David0412-sun/Rapidhand/RAPID-Hand-main/README.md

<p align="center">
    <h1 align="center"><strong>
    RAPID Hand: A Robust, Affordable,<br>
    Perception-Integrated, Dexterous Manipulation Platform<br>
    for Generalist Robot Autonomy</strong>
    </h1>
</p>

<p align="center" style="font-size:18px;">
    <a href="https://jeffreyzhaoliang.github.io/zhaoliang-wan.github.io/"><strong>Zhaoliang Wan</strong></a>
    ·
    <a href=""><strong>Zetong Bi</strong></a>
    ·
    <a href=""><strong>Zida Zhou</strong></a>
    ·
    <a href="https://hren20.github.io/"><strong>Hao Ren</strong></a>
    ·
    <a href="https://jzengym.github.io/JZENGYM/"><strong>Yiming Zeng</strong></a>
    ·
    <a href=""><strong>Yihan Li</strong></a>
    <br>
    <a href="http://luqi.info/"><strong>Lu Qi</strong></a>
    ·
    <a href="https://people.ucas.edu.cn/~XuYang"><strong>Xu Yang</strong></a>
    ·
    <a href="https://faculty.ucmerced.edu/mhyang/"><strong>Ming-Hsuan Yang</strong></a>
    ·
    <a href="https://cse.sysu.edu.cn/teacher/ChengHui"><strong>Hui Cheng</strong></a>
</p>

<p align="center">
    <img src="RapidTeleop/assets/images/institution/sysu_logo.png" height=40">                    
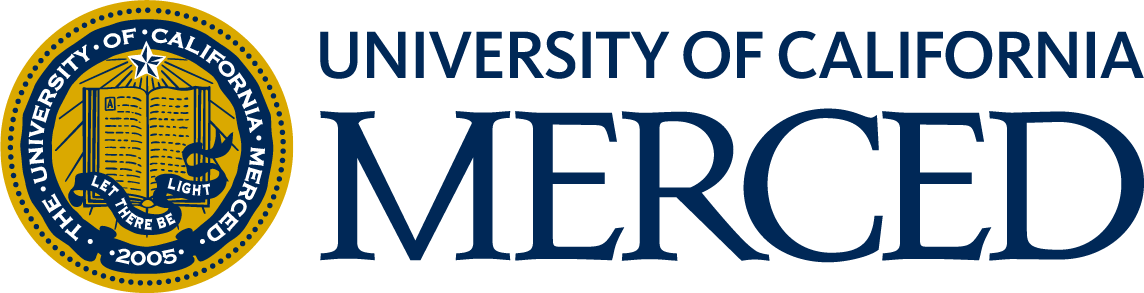
[picture p1: RAPID-Hand-main/RapidTeleop/assets/images/institution/University_of_Califronia_Merced_logo.png]
                        
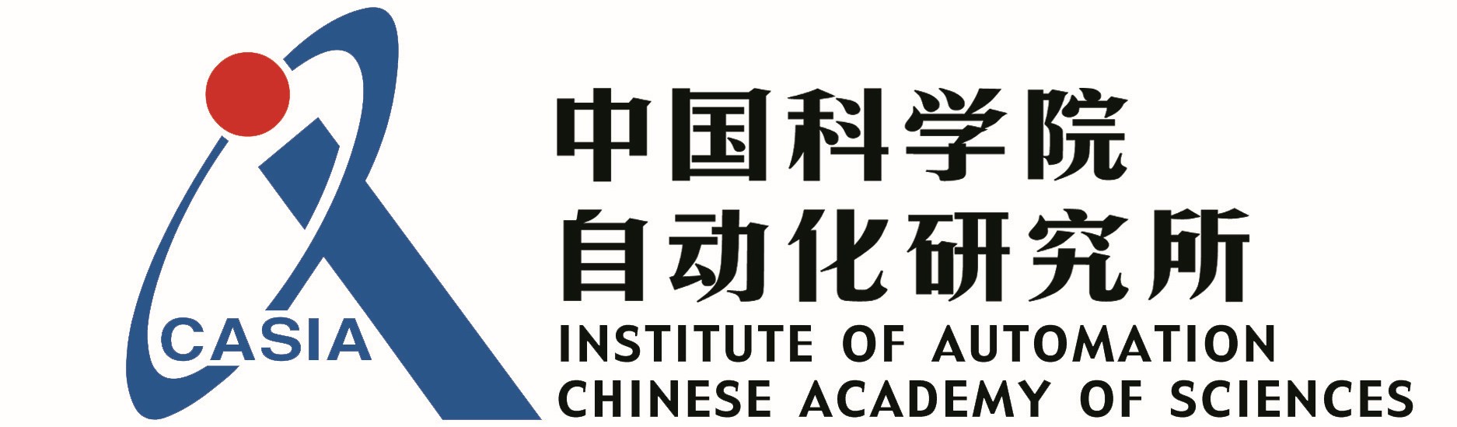
[picture p2: RAPID-Hand-main/RapidTeleop/assets/images/institution/casia-logo.jpg]
    
</p>

<h3 align="center"><a href="https://www.arxiv.org/abs/2506.07490">Paper</a> | <a href="https://rapid-hand.github.io/">Project Page</a> | <a href="https://github.com/SYSU-RoboticsLab/RAPID-Hand/tree/main/RapidHandHardware">Hardware Design</a> | <a href="https://github.com/SYSU-RoboticsLab/RAPID-Hand/tree/main/RapidTeleop">Teleoperation</a> </a></h3>

<p align="center">
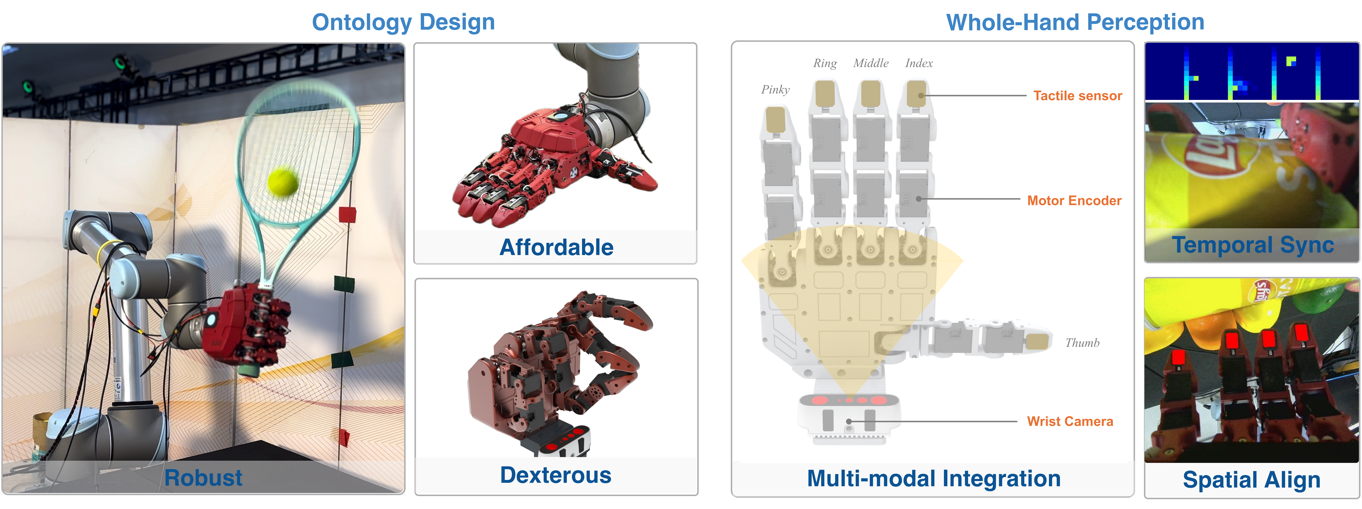
[picture p3: RAPID-Hand-main/RapidTeleop/assets/images/teaser_rss_7_00.png]
    
</p>

## 🔥 News

- \[2025-06\] RAPID Hand full system released with mechanical, electrical, and software modules.
- \[2025-06\] We release the [paper](https://www.arxiv.org/abs/2506.07490) of RAPID Hand.

---

## 🏠 Introduction

This repository is an official implementation of **RAPID Hand**, which is a low-cost, high-fidelity, modular hardware-software platform for dexterous hand manipulation, consisting of:

- **RapidHandHardware**: Detailed hardware design (PCBs, 3D printable parts, bill of materials).
- **RapidTeleop**: Vision-guided teleoperation suite with intuitive user control.

It enables researchers and hobbyists to easily replicate complex hand hardware for manipulation tasks at a much lower cost.

---

## 🛠️ Installation & Usage

Please refer to the sub-repository READMEs for detailed instructions:

- 🧩 [RapidHandHardware](./RapidHandHardware/README.md): mechanical design, PCB setup, and system integration for the RAPID Hand platform.
- 🖥️ [RapidTeleop](./RapidTeleop/README.md): teleoperation interface, ROS setup, and control pipeline for both simulation and real hardware.

---

## 📝 TODO

- \[x\] Release hardware and BOM.
- \[x\] Upload software for teleop and control.
- \[ \] Extend to multiple hand variants and task types.

---

## 🔗 Citation

If you use our project, please cite:

```bibtex
@article{wan2025rapid,
  title={RAPID Hand: A Robust, Affordable, Perception-Integrated, Dexterous Manipulation Platform for Generalist Robot Autonomy},
  author={Wan, Zhaoliang and Bi, Zetong and Zhou, Zida and Ren, Hao and Zeng, Yiming and Li, Yihan and Qi, Lu and Yang, Xu and Yang, Ming-Hsuan and Cheng, Hui},
  journal={arXiv preprint arXiv:2506.07490},
  year={2025}
}
```

---

## 📄 License

This project is licensed under the [Creative Commons BY-NC-SA 4.0 License](http://creativecommons.org/licenses/by-nc-sa/4.0/).

---

## 🙏 Acknowledgements

This project was developed with help of the following codebases.
- [Tracking Streamer](https://github.com/Improbable-AI/VisionProTeleop)  
- [AnyTeleop](https://yzqin.github.io/anyteleop/)  
- [Bunny-VisionPro](https://dingry.github.io/projects/bunny_visionpro.html)  
- [HATO](https://toruowo.github.io/hato/)  
- [Orbbec-sdk](https://github.com/orbbec/pyorbbecsdk)  

We would also like to thank orbot **ORBOT** Ltd. for their support on the robot hardware and [LUSTER](https://www.luster3ds.com/content/details202_5099.html) for motion capture devices. We sincerely appreciate the contributions from all related institutions and authors.
