David0412-sun/Rapidhand/RAPID-Hand-main/RapidHandHardware/mechanical_structure/rss_design/finger_with_cam/手指带摄像头爆炸图.PNG

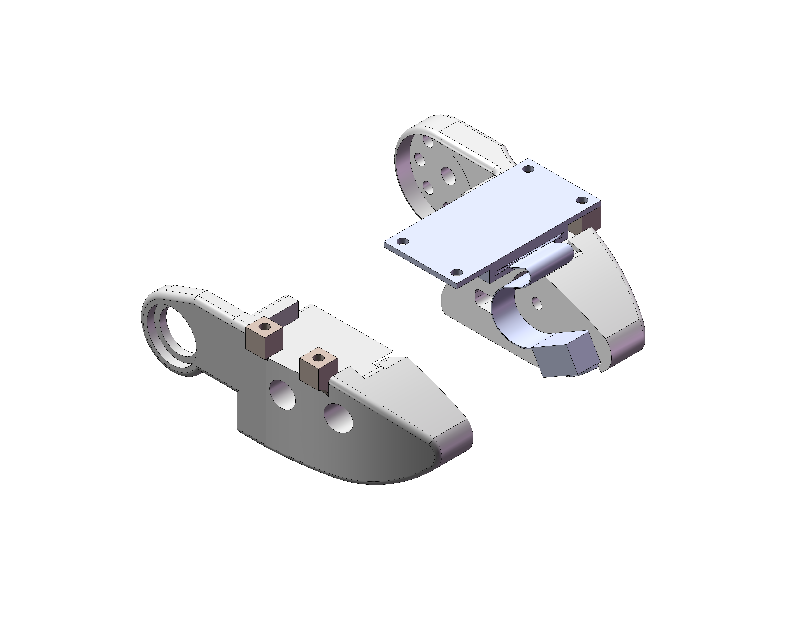
RAPID-Hand-main/RapidHandHardware/mechanical_structure/rss_design/finger_with_cam/手指带摄像头爆炸图.PNG
