David0412-sun/Rapidhand/tmp/pdfs/final_render/page_01.png

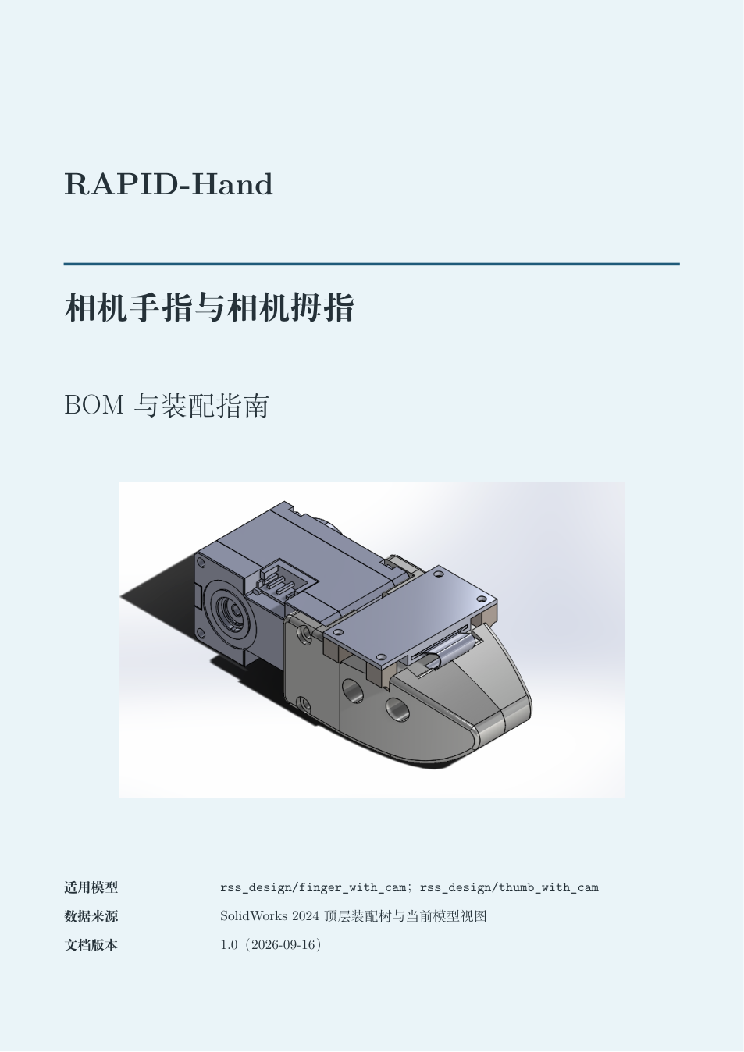
tmp/pdfs/final_render/page_01.png
