David0412-sun/Rapidhand/tmp/pdfs/final_render/page_02.png

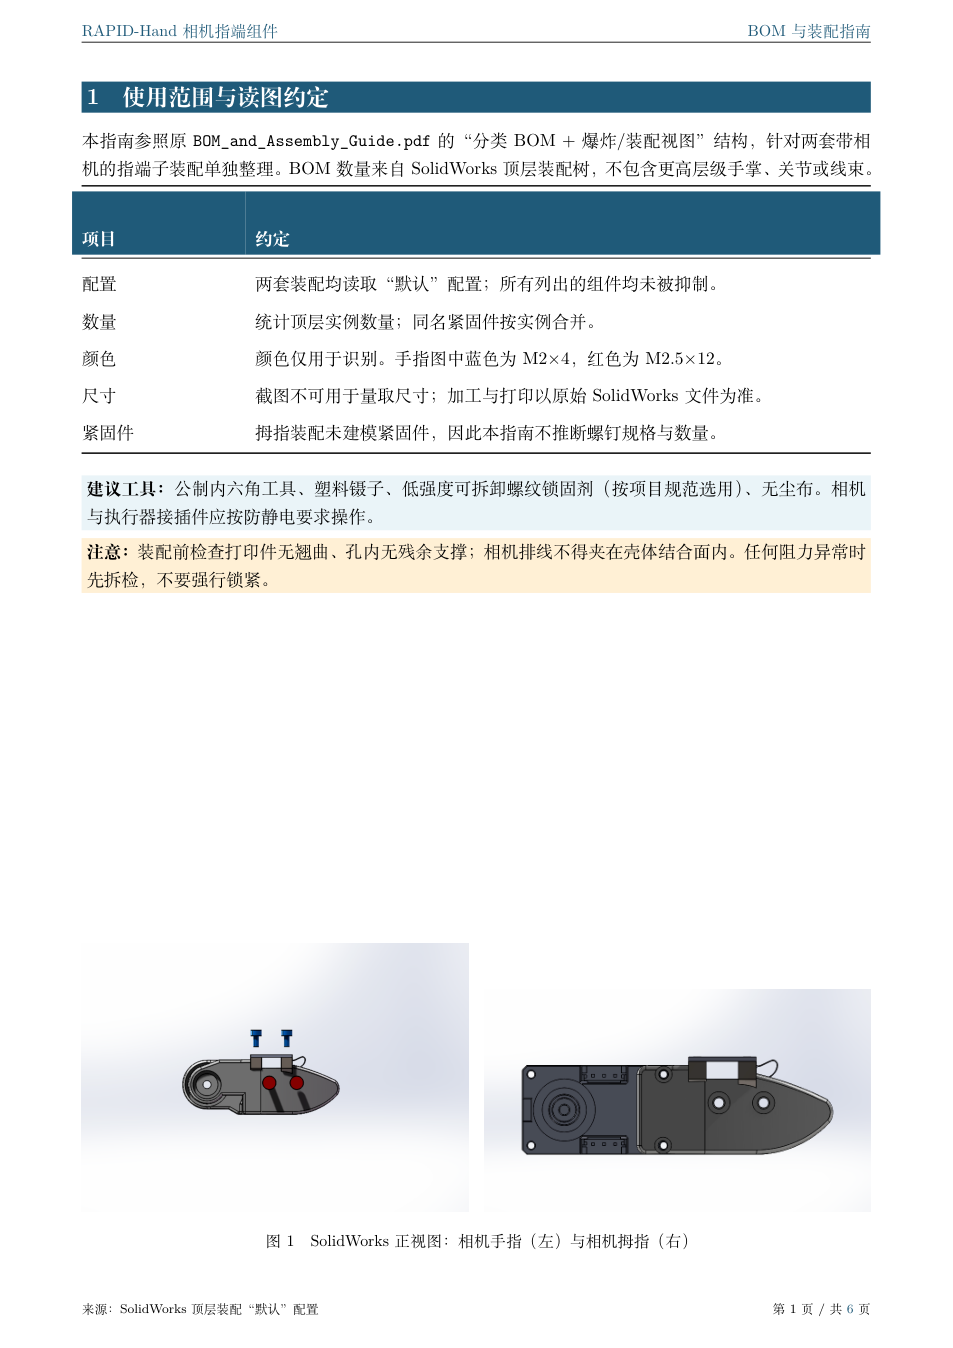
tmp/pdfs/final_render/page_02.png
