David0412-sun/Rapidhand/tmp/pdfs/final_render/page_03.png

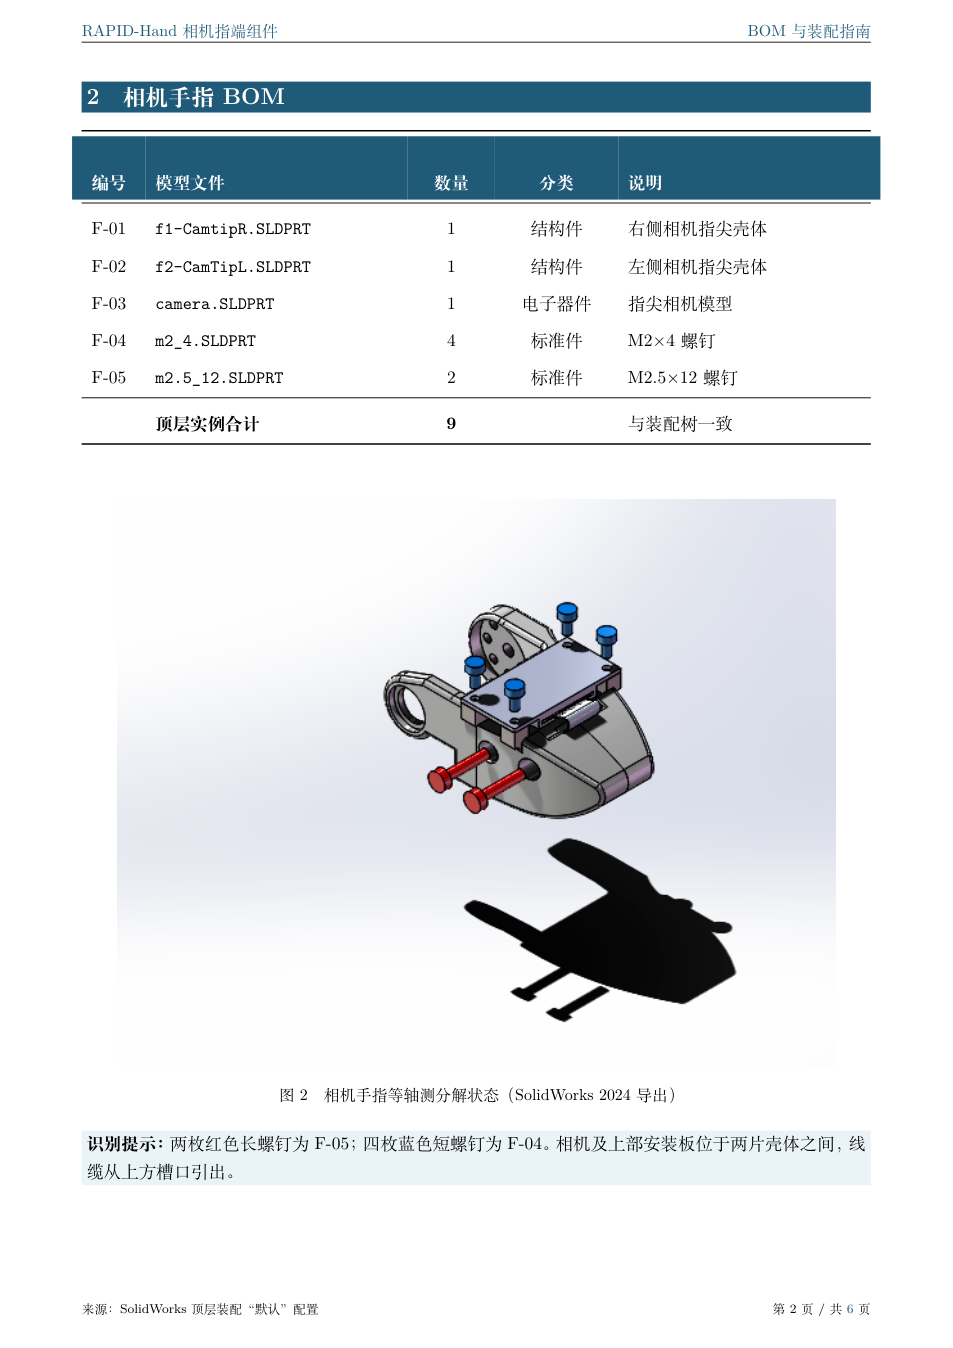
tmp/pdfs/final_render/page_03.png
