David0412-sun/Rapidhand/tmp/pdfs/final_render/page_04.png

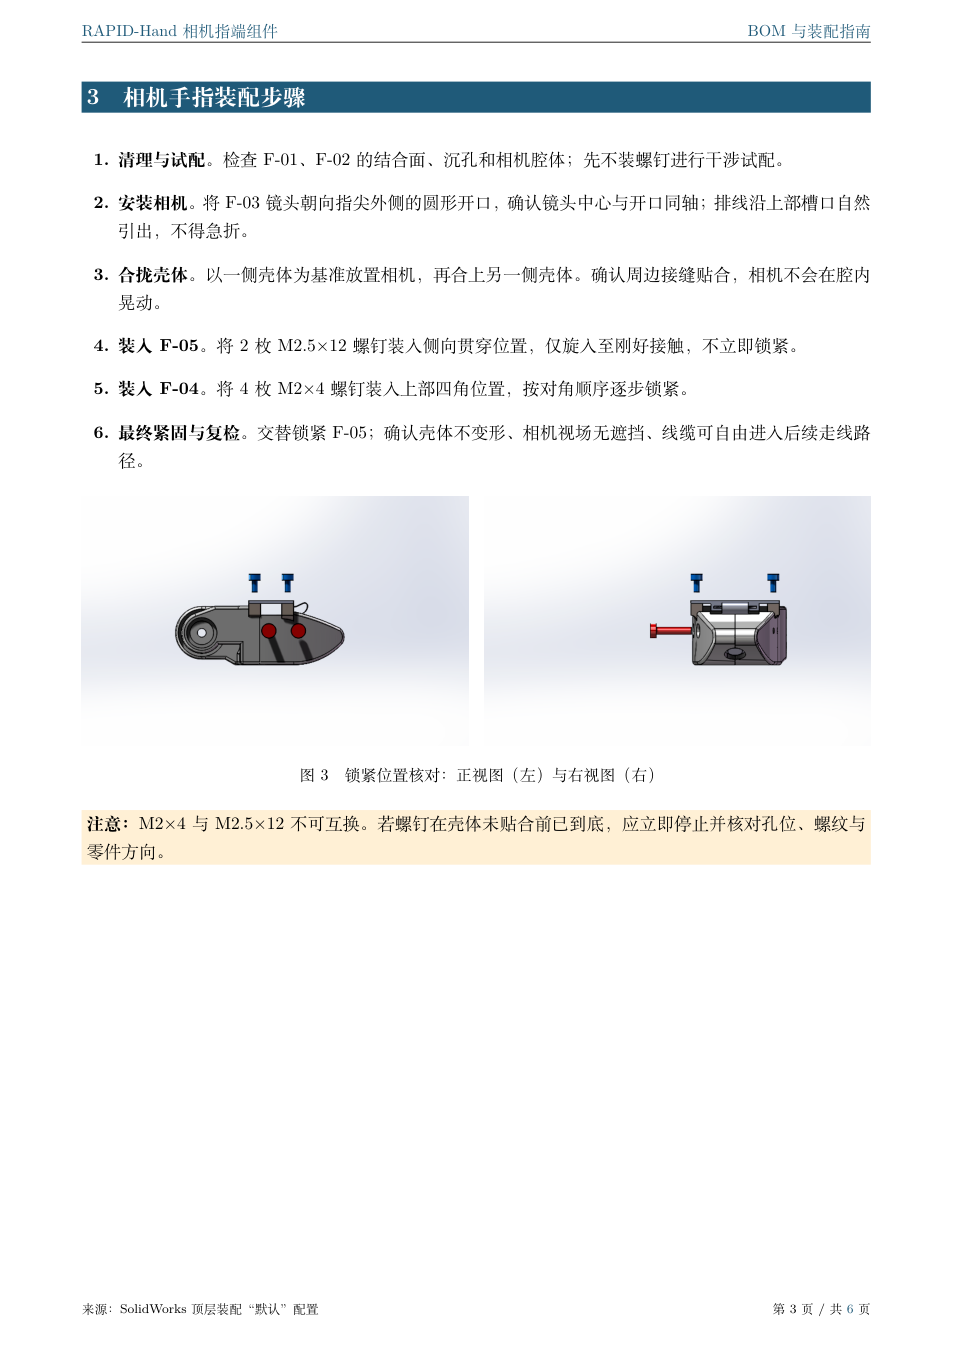
tmp/pdfs/final_render/page_04.png
