David0412-sun/Rapidhand/tmp/pdfs/final_render/page_05.png

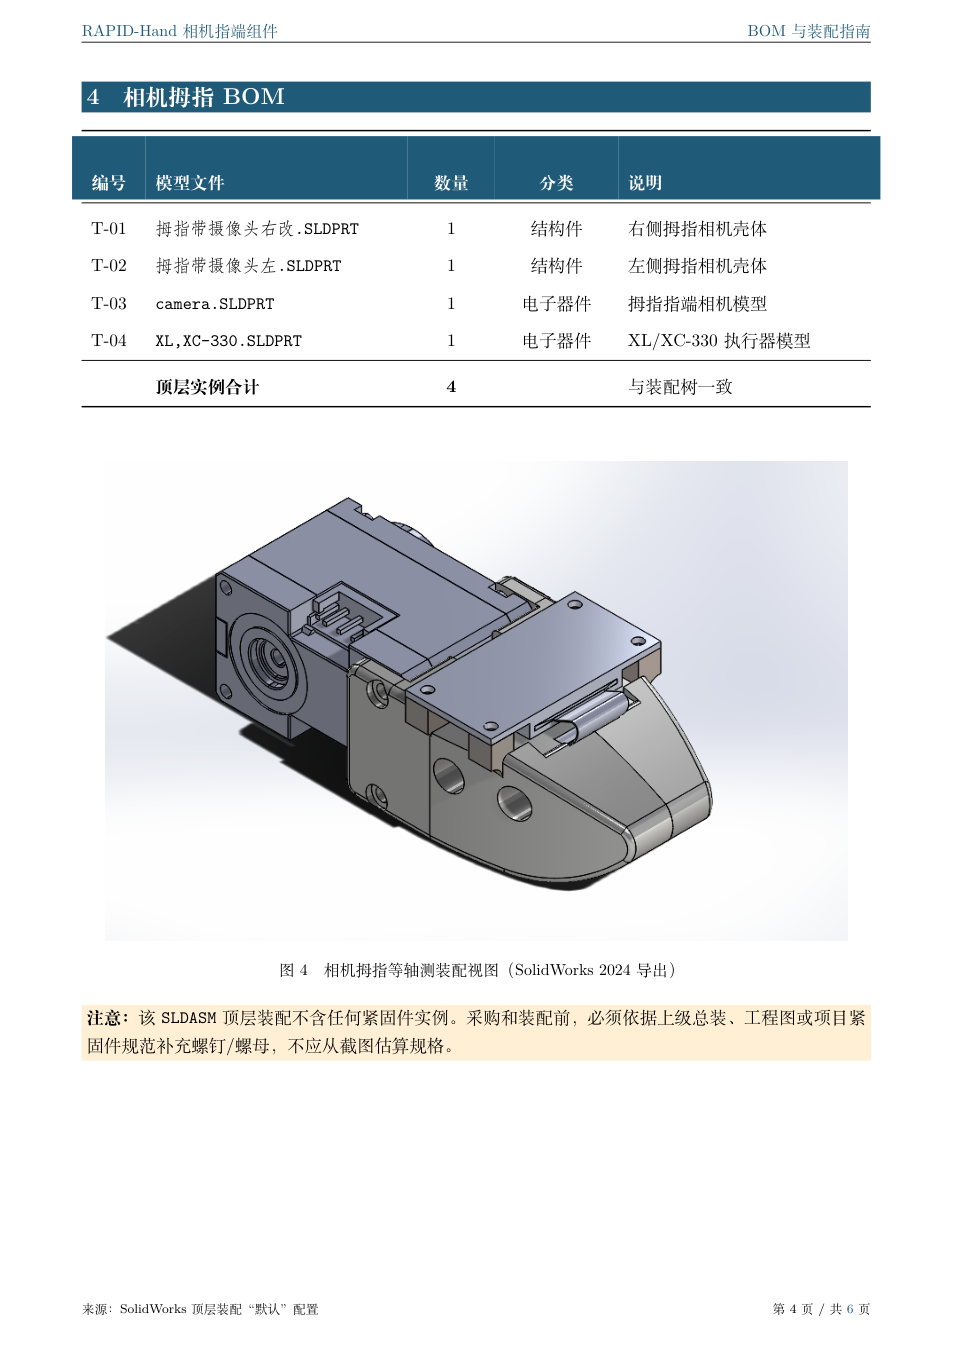
tmp/pdfs/final_render/page_05.png
