David0412-sun/Rapidhand/tmp/pdfs/final_render/page_07.png

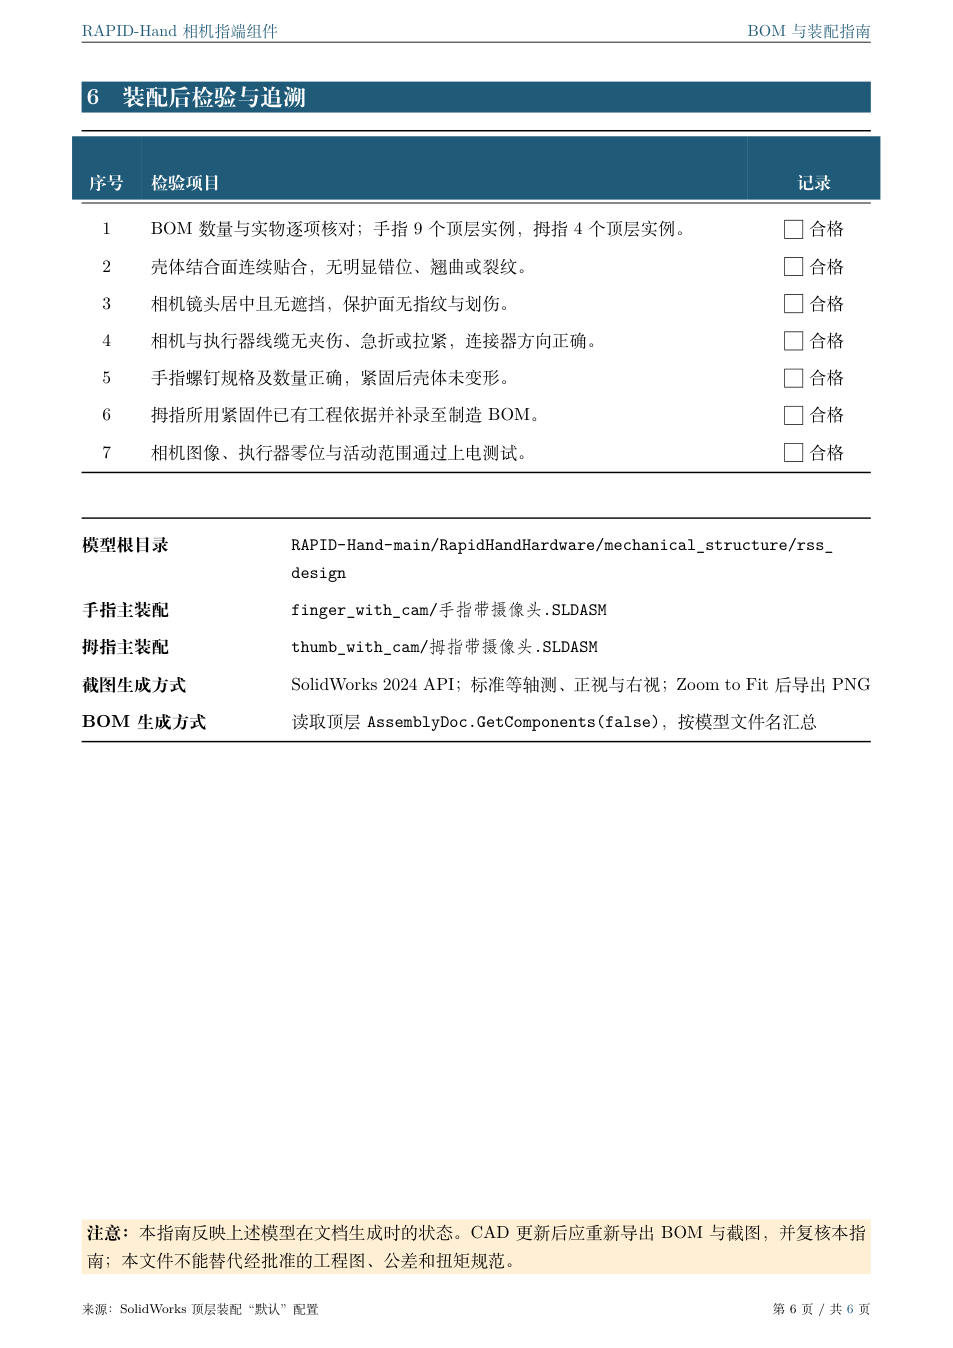
tmp/pdfs/final_render/page_07.png
