David0412-sun/Rapidhand/tmp/thumb_latest_review.png

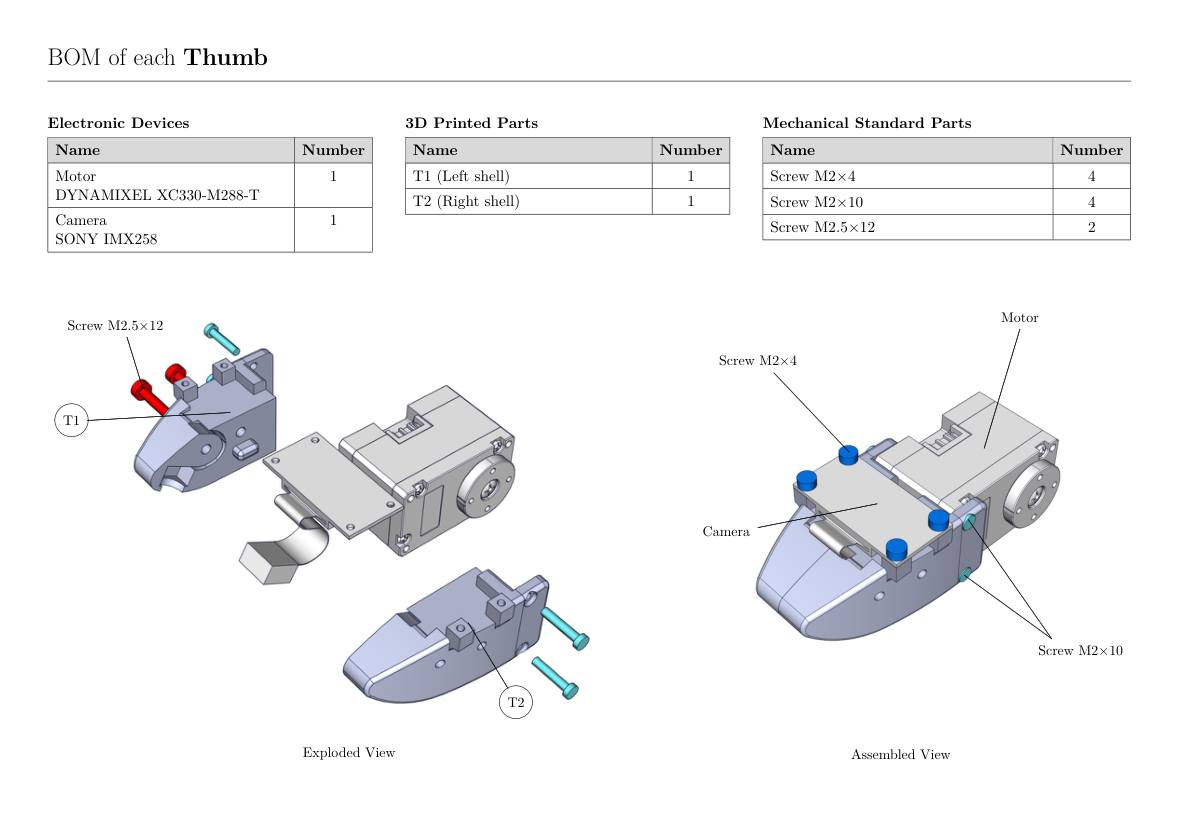
tmp/thumb_latest_review.png
