David0412-sun/Rapidhand/tmp/finger_bom_package_03548a5a9b424c499b2d4891ffd1fe91/RapidHand_camera_BOM_assembly_guide.pdf

## BOM of each Finger

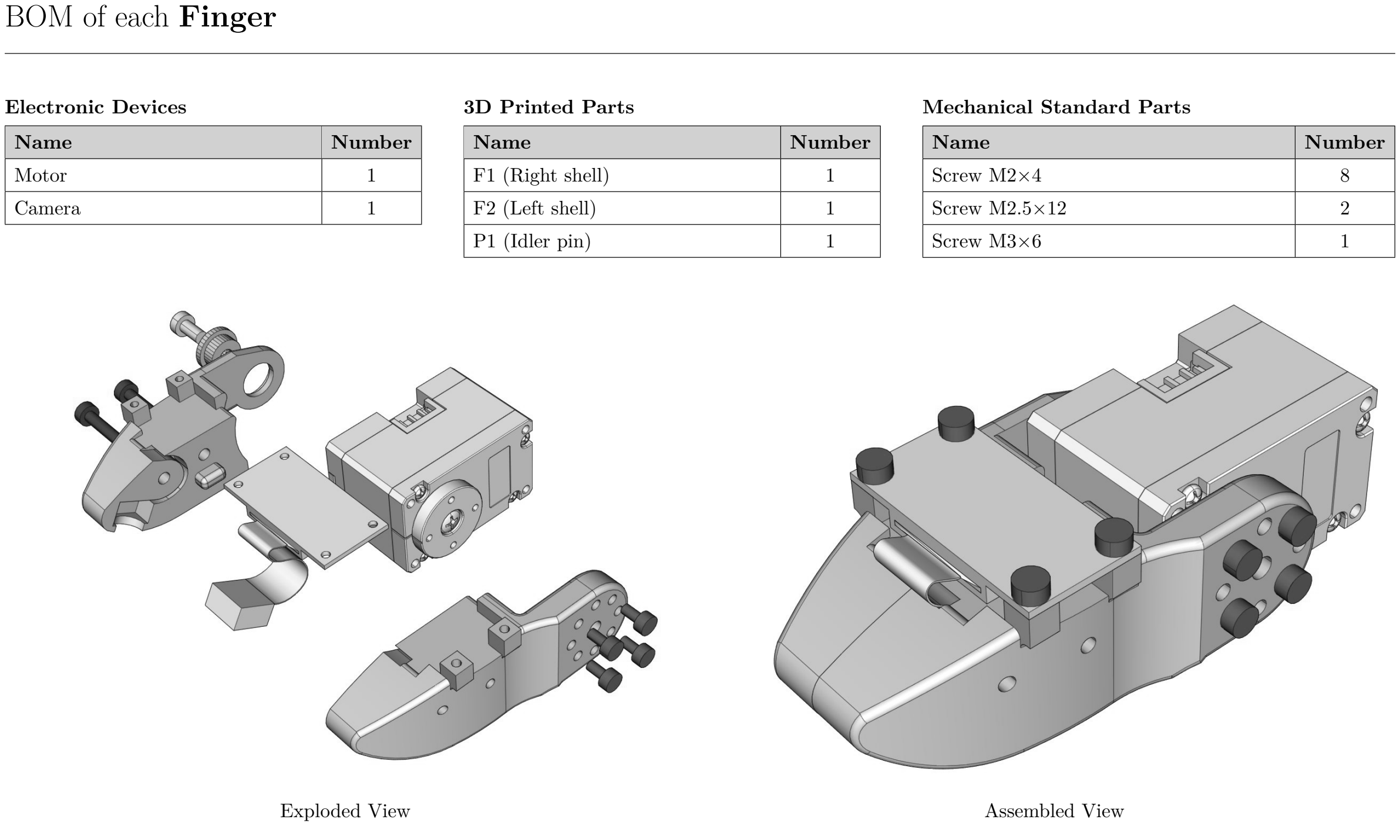
[picture p33: page 1]

Electronic Devices

Name | Number
Motor | 1
Camera | 1

3D Printed Parts

Name | Number
F1 (Right shell) | 1
F2 (Left shell) | 1
P1 (Idler pin) | 1

Mechanical Standard Parts

Name | Number
Screw M2×4 | 8
Screw M2.5×12 | 2
Screw M3×6 | 1
Exploded View | Assembled View
