David0412-sun/Rapidhand/RAPID-Hand-main/RapidHandHardware/mechanical_structure/FingerVIP_Mechanical_structure/FingerVIP_BOM_assembly_guide.pdf

## BOM of each Finger


Electronic Devices

Name | Number
Motor
DYNAMIXEL XC330-M288-T

1

Camera
SONY IMX258

1

3D Printed Parts

Name | Number
F1 (Right shell) | 1
F2 (Left shell) | 1
P1 (Idler pin) | 1

Mechanical Standard Parts

Name | Number
Screw M2×4 | 8
Screw M2.5×12 | 2
Screw M3×6 | 1

✖✕

✗✔F1

✖✕

✗✔F2

✖✕

✗✔P1

Screw M2.5×12

Screw M3×6

Motor

Camera

Screw M2×4

Exploded View | Assembled View

## BOM of Thumb


Electronic Devices

Name | Number
Motor
DYNAMIXEL XC330-M288-T

1

Camera
SONY IMX258

1

3D Printed Parts

Name | Number
T1 (Left shell) | 1
T2 (Right shell) | 1

Mechanical Standard Parts

Name | Number
Screw M2×4 | 4
Screw M2×10 | 4
Screw M2.5×12 | 2

✖✕

✗✔T1

✖✕

✗✔T2

Screw M2.5×12 | Motor

Camera

Screw M2×4

Screw M2×10

Exploded View | Assembled View

## Total BOM

Quantity basis: 4 Finger assemblies + 1 Thumb assembly.

Electronic Devices

Name | Number
Motor
DYNAMIXEL XC330-M288-T

5

Camera
SONY IMX258

5

3D Printed Parts

Name | Number
F1 (Right shell) | 4
F2 (Left shell) | 4
P1 (Idler pin) | 4
T1 (Left shell) | 1
T2 (Right shell) | 1

Mechanical Standard Parts

Name | Number
Screw M2×4 | 36
Screw M2×10 | 4
Screw M2.5×12 | 10
Screw M3×6 | 4

Scope: camera finger and thumb assemblies listed in this document only.
