David0412-sun/Rapidhand/RAPID-Hand-main/RapidHandHardware/pcb_sync_module/pcb_sourcing/BOM_Board1_PCB1.xlsx

No. | Quantity | Comment | Designator | Footprint | Value | Manufacturer Part | Manufacturer | Supplier Part | Supplier
1 | 12 | 100nF | C23,C24,C25,C26,C27,C28,C35,C41,C42,C54,C87,C89 | C0402 | 100nF | CL05B104KO5NNNC | SAMSUNG(三星) | C1525 | LCSC
2 | 1 | 1uF | C29 | C0402 | 1uF | CL05A105KP5NNNC | SAMSUNG(三星) | C14445 | LCSC
3 | 2 | 2.2uF | C30,C31 | C0402 | 2.2uF | CL05A225KO5NQNC | SAMSUNG(三星) | C170151 | LCSC
4 | 2 | 20pF | C32,C33 | C0402 | 20pF | GRM1555C1H200JA01D | muRata(村田) | C76959 | LCSC
5 | 2 | 10uF | C88,C90 | C0402 | 10uF | CL05A106MP5NUNC | SAMSUNG(三星) | C315248 | LCSC
6 | 2 | WAFER-GH1.25-2PWB | Camera,Servo | CONN-TH_2P-P1.25_XUNPU_WAFER-GH1.25-2PWB |  | WAFER-GH1.25-2PWB | XUNPU(讯普) | C3029377 | LCSC
7 | 5 | AFC42-S04FMA-1H | FPC1,FPC2,FPC3,FPC4,FPC5 | FFC-SMD_4P-P0.50_AFC42-S04FMA-1H |  | AFC42-S04FMA-1H | JS(钜硕电子) | C466528 | LCSC
8 | 1 | PZ254V-11-04P | H5 | HDR-TH_4P-P2.54-V-M |  | PZ254V-11-04P | XFCN(兴飞) | C2691448 | LCSC
9 | 1 | NCD0805B2 | PB1 | LED0805-R-RD |  | NCD0805B2 | 国星光电 | C84259 | LCSC
10 | 1 | NCD0805G1 | PB2 | LED0805-R-RD |  | NCD0805G1 | 国星光电 | C84260 | LCSC
11 | 1 | NCD0805R1 | PWR | LED0805-R-RD |  | NCD0805R1 | 国星光电 | C84256 | LCSC
12 | 1 | S8050-J3Y | Q3 | SOT-23-3_L3.0-W1.7-P0.95-LS2.9-BR |  | S8050-J3Y | MDD(辰达半导体) | C364312 | LCSC
13 | 4 | 1kΩ | R6,R7,R24,R36 | R0402 | 1kΩ | ERJ2RKF1001X | PANASONIC(松下) | C242161 | LCSC
14 | 1 | 10kΩ | R21 | R0603 | 10kΩ | RC0603FR-0710KL | YAGEO(国巨) | C98220 | LCSC
15 | 5 | 10kΩ | R23,R37,R38,R39,R40 | R0603 | 10kΩ | 0603WAF1002T5E | UNI-ROYAL(厚声) | C25804 | LCSC
16 | 3 | 4.7kΩ | R33,R34,R42 | R0402 | 4.7kΩ | ERJ2RKF4701X | PANASONIC(松下) | C400631 | LCSC
17 | 1 | 0Ω | R41 | R0402 | 0Ω | ERJ2GE0R00X | PANASONIC(松下) | C242160 | LCSC
18 | 1 | TS-1088-AR02016 | SW3 | SW-SMD_L3.9-W3.0-P4.45 |  | TS-1088-AR02016 | XUNPU(讯普) | C720477 | LCSC
19 | 4 | 螺丝孔 | TP1,TP2,TP3,TP4 | M2螺丝
20 | 1 | STM32H743VIT6 | U4 | LQFP-100_L14.0-W14.0-P0.50-LS16.0-BL |  | STM32H743VIT6 | ST(意法半导体) | C114409 | LCSC
21 | 1 | CH340N | U6 | SOP-8_L4.9-W3.9-P1.27-LS6.0-BL |  | CH340N | WCH(南京沁恒) | C2977777 | LCSC
22 | 1 | SN74LVC2G241DCTR | U16 | SSOP-8_L3.0-W2.8-P0.65-LS4.0-BL |  | SN74LVC2G241DCTR | TI(德州仪器) | C2676069 | LCSC
23 | 1 | AMS1117-3.3 | U28 | SOT-223-3_L6.5-W3.4-P2.30-LS7.0-BR |  | AMS1117-3.3 | AMS | C6186 | LCSC
24 | 1 | TYPE-C-31-M-12 | USBC1 | USB-C_SMD-TYPE-C-31-M-12 |  | TYPE-C-31-M-12 | 韩国韩荣 | C165948 | LCSC
25 | 1 | 12MHz | X2 | OSC-SMD_4P-L3.2-W2.5-BL | 12MHz | X322512MSB4SI | YXC(扬兴晶振) | C9002 | LCSC
