David0412-sun/Rapidhand/tmp/bom_two_pages_1.png

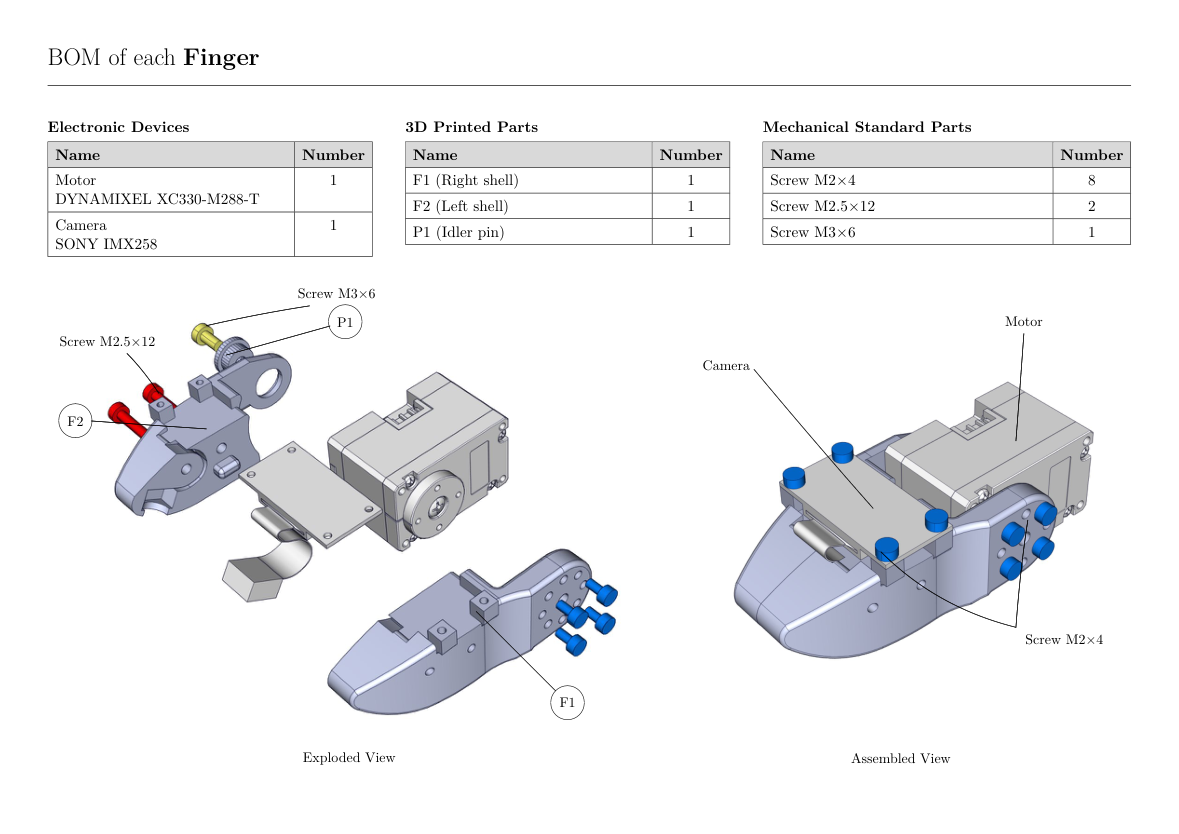
tmp/bom_two_pages_1.png
