David0412-sun/Rapidhand/tmp/finger_bom_color_review.png

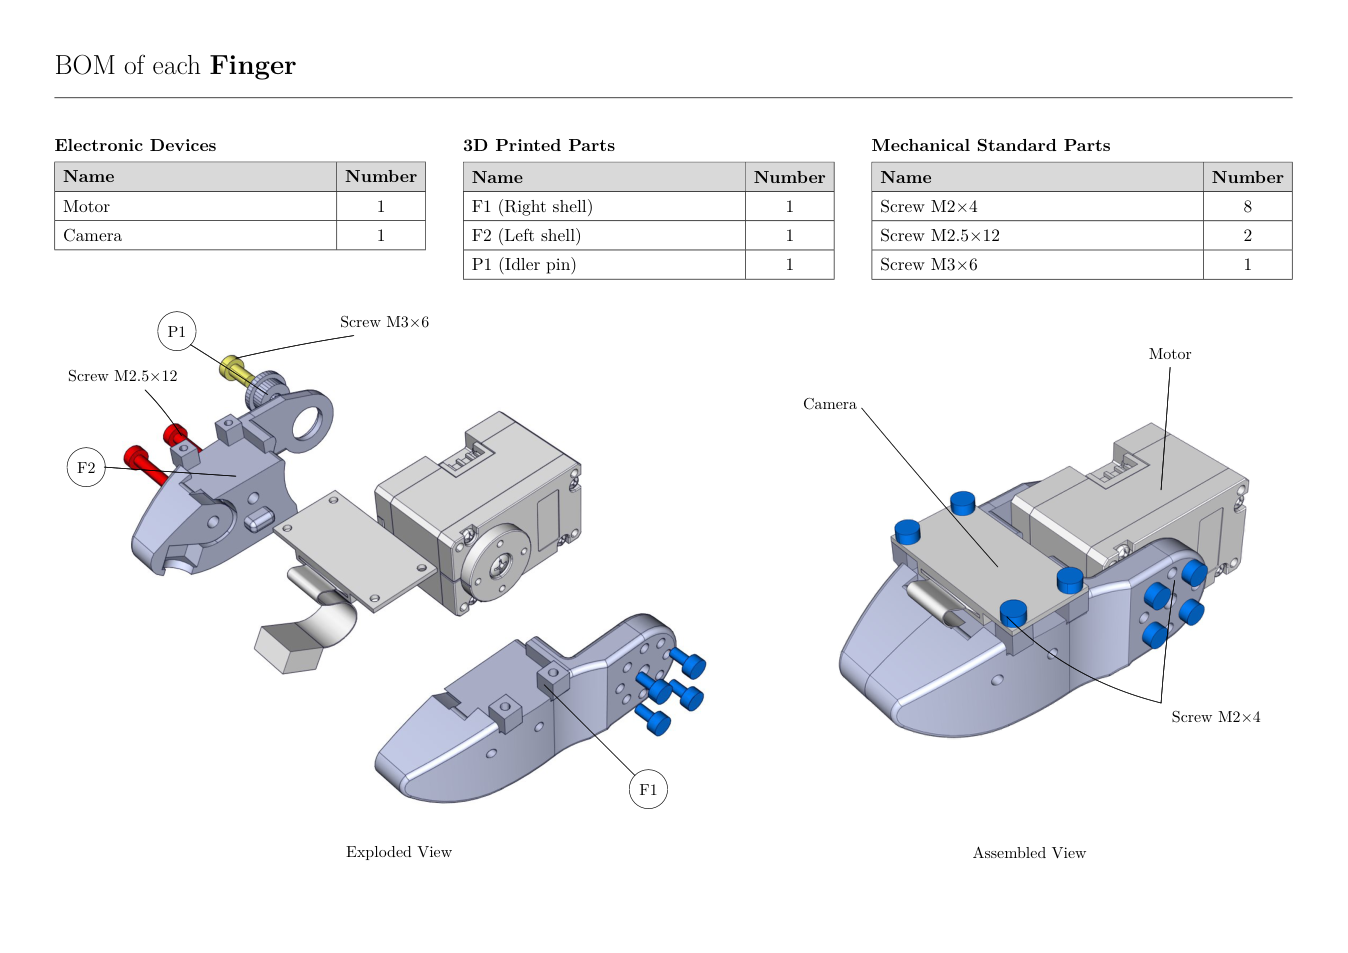
tmp/finger_bom_color_review.png
