David0412-sun/Rapidhand/tmp/finger_bom_review.png

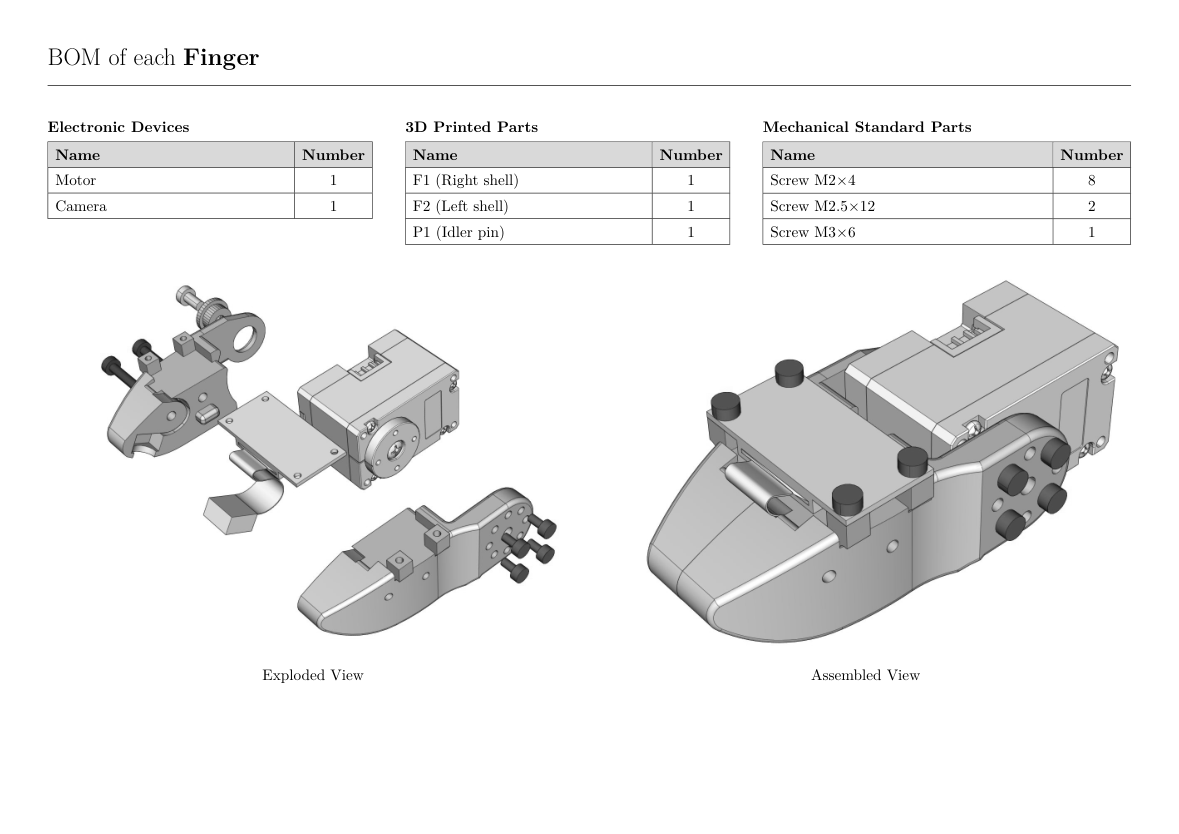
tmp/finger_bom_review.png
