David0412-sun/Rapidhand/tmp/total_bom_review.png

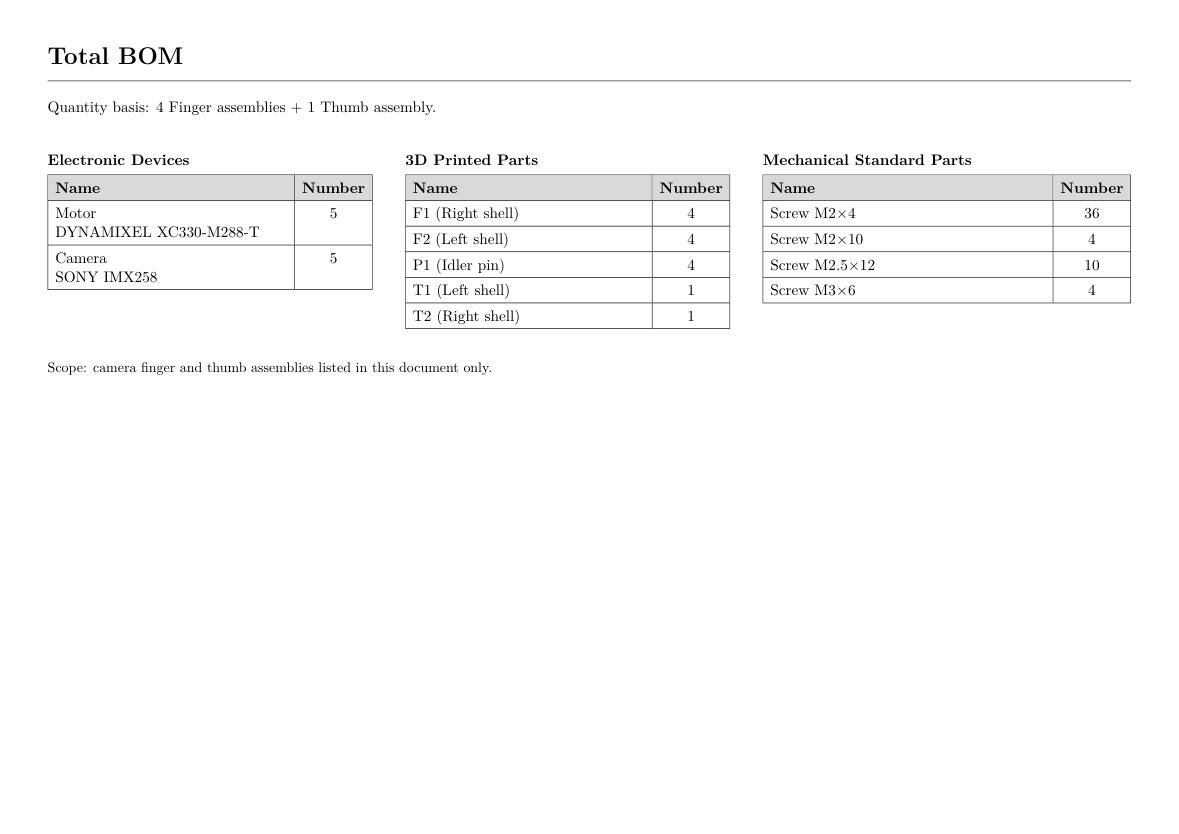
tmp/total_bom_review.png
