David0412-sun/Rapidhand/RAPID-Hand-main/RapidHandHardware/mechanical_structure/3D Printed Parts/3d打印文件/手指tactile3d打印/f7_tactile.STL

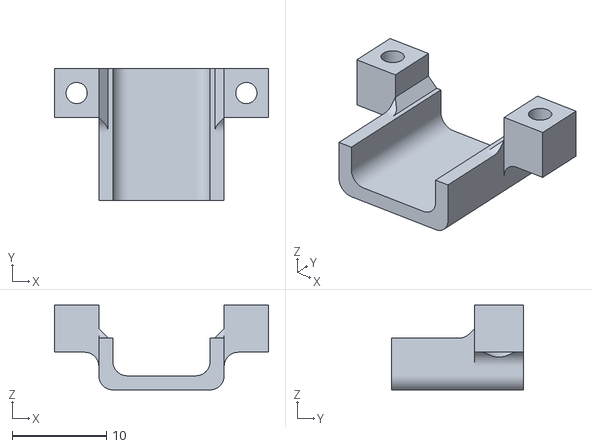
[picture p51: CAD file, 2026-05-18]
RAPID-Hand-main/RapidHandHardware/mechanical_structure/3D Printed Parts/3d打印文件/手指tactile3d打印/f7_tactile.STL
22.7 x 14.0 x 9.00
