David0412-sun/Rapidhand/RAPID-Hand-main/RapidHandHardware/mechanical_structure/3D Printed Parts/3d打印文件/手掌加工2026-3/机械件/P2-2-DC15_A01_IDLE_CAP_DUMMY.STL

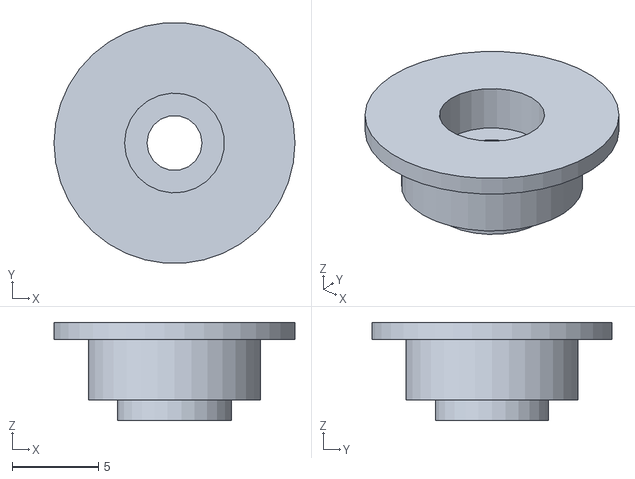
[picture p52: CAD file, 2026-05-18]
RAPID-Hand-main/RapidHandHardware/mechanical_structure/3D Printed Parts/3d打印文件/手掌加工2026-3/机械件/P2-2-DC15_A01_IDLE_CAP_DUMMY.STL
14.0 x 14.0 x 5.70
