David0412-sun/Rapidhand/RAPID-Hand-main/RapidHandHardware/mechanical_structure/3D Printed Parts/3d打印文件/横向支撑件.STL

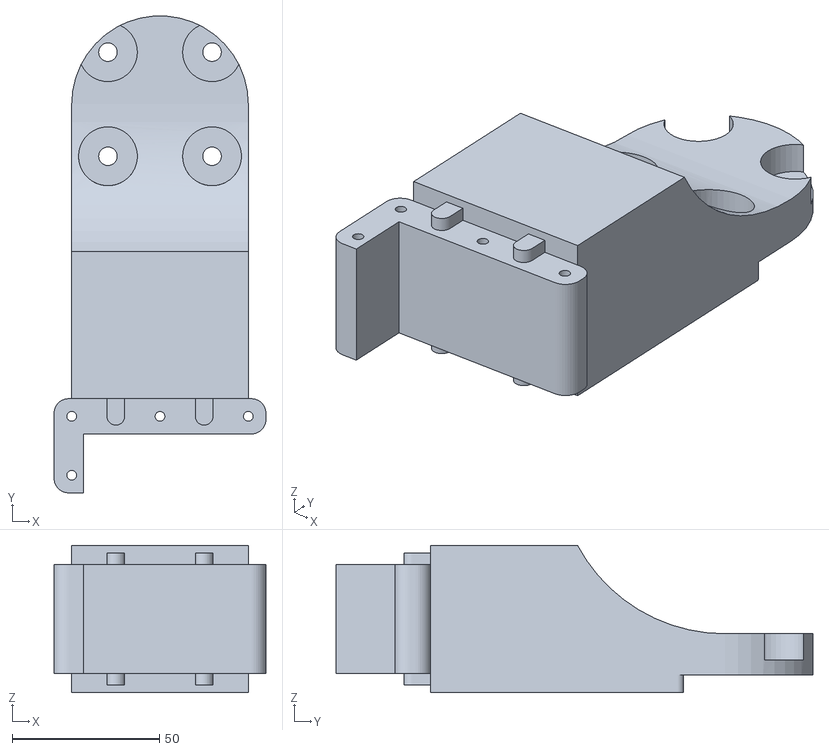
[picture p53: CAD file, 2026-09-17]
RAPID-Hand-main/RapidHandHardware/mechanical_structure/3D Printed Parts/3d打印文件/横向支撑件.STL
72.0 x 161.9 x 50.0
