David0412-sun/Rapidhand/RAPID-Hand-main/RapidHandHardware/mechanical_structure/3D Printed Parts/F4-食指连接件右.STL

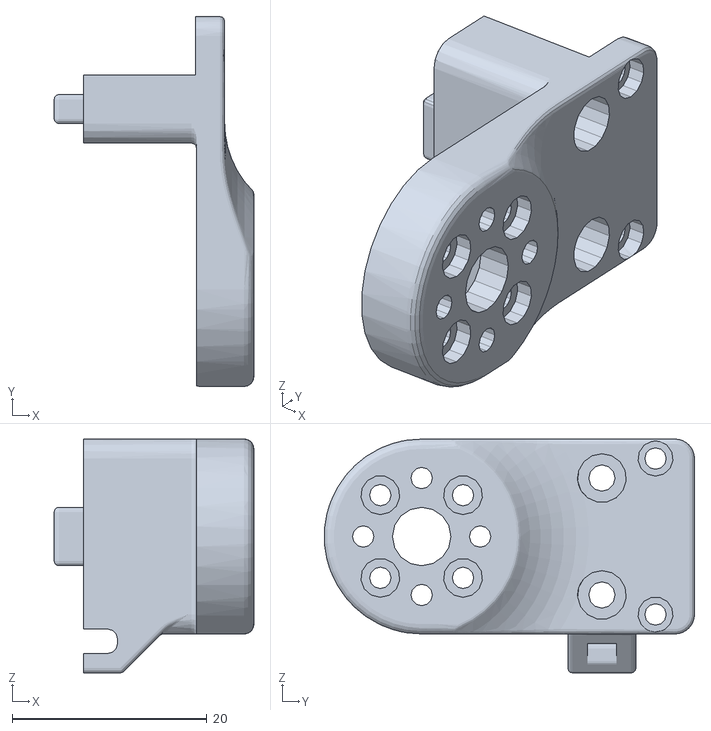
[picture p54: CAD file, 2026-05-18]
RAPID-Hand-main/RapidHandHardware/mechanical_structure/3D Printed Parts/F4-食指连接件右.STL
20.5 x 38.0 x 24.0
