David0412-sun/Rapidhand/RAPID-Hand-main/RapidHandHardware/mechanical_structure/3D Printed Parts/mesh/URDF/PALM_URDF_0723_collision_featured.SLDASM/meshes/TDIP_TACTILE_UP.STL

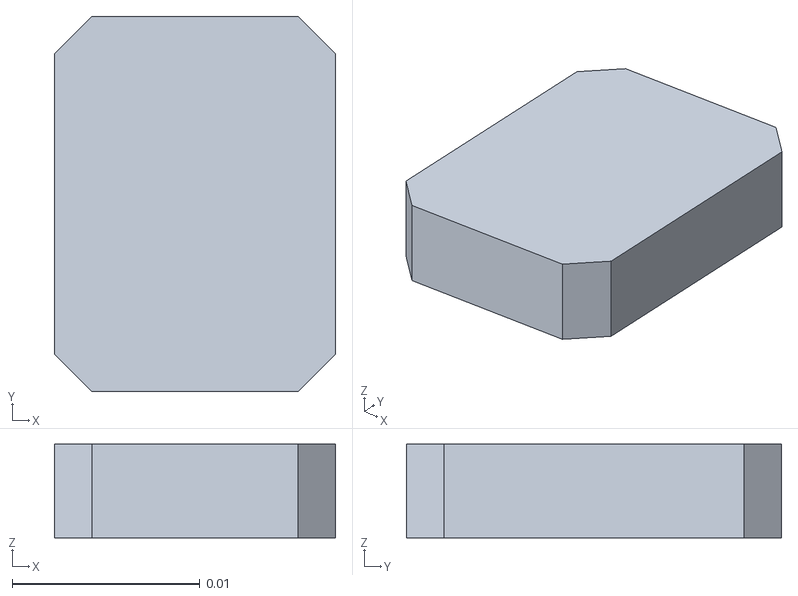
[picture p55: CAD file, 2026-09-09]
RAPID-Hand-main/RapidHandHardware/mechanical_structure/3D Printed Parts/mesh/URDF/PALM_URDF_0723_collision_featured.SLDASM/meshes/TDIP_TACTILE_UP.STL
0.015 x 0.02 x 0.005
