David0412-sun/Rapidhand/RAPID-Hand-main/RapidHandHardware/mechanical_structure/3D Printed Parts/mesh/URDF/PALM_URDF_0723_collision_featured_2.SLDASM/meshes/MDIP_CAMERA.STL

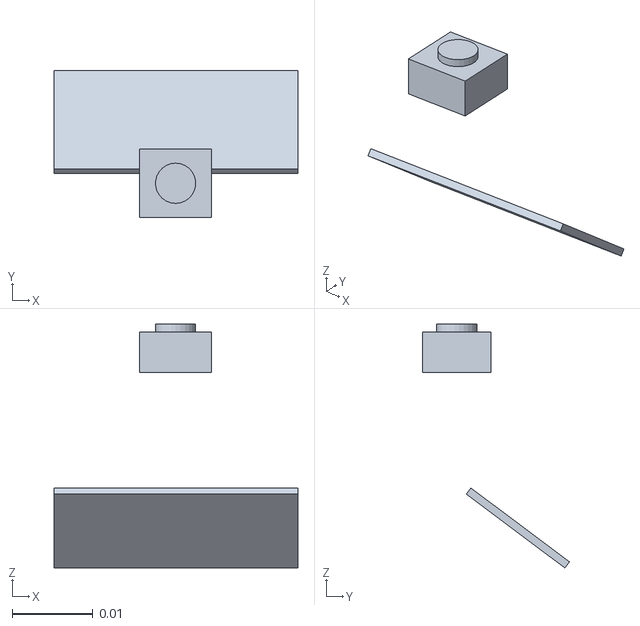
[picture p56: CAD file, 2026-09-09]
RAPID-Hand-main/RapidHandHardware/mechanical_structure/3D Printed Parts/mesh/URDF/PALM_URDF_0723_collision_featured_2.SLDASM/meshes/MDIP_CAMERA.STL
0.0303 x 0.0183 x 0.0303
