David0412-sun/Rapidhand/RAPID-Hand-main/RapidHandHardware/mechanical_structure/3D Printed Parts/mesh/URDF/PALM_URDF_0724_collision_featured_4.SLDASM/meshes/BASE.STL

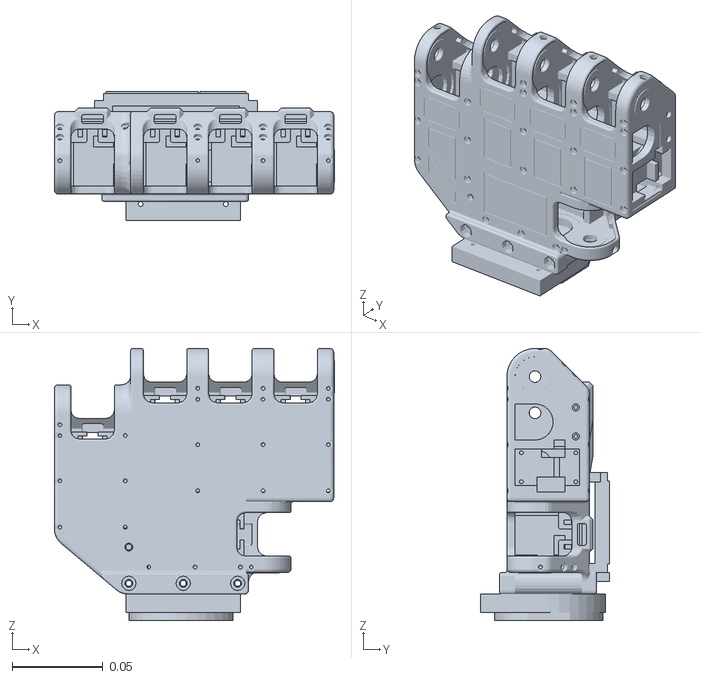
[picture p57: CAD file, 2026-09-09]
RAPID-Hand-main/RapidHandHardware/mechanical_structure/3D Printed Parts/mesh/URDF/PALM_URDF_0724_collision_featured_4.SLDASM/meshes/BASE.STL
0.154 x 0.071 x 0.15
