David0412-sun/Rapidhand/RAPID-Hand-main/RapidHandHardware/mechanical_structure/3D Printed Parts/机械件/g2-1m25t直齿轮（驱动轮）改.STL

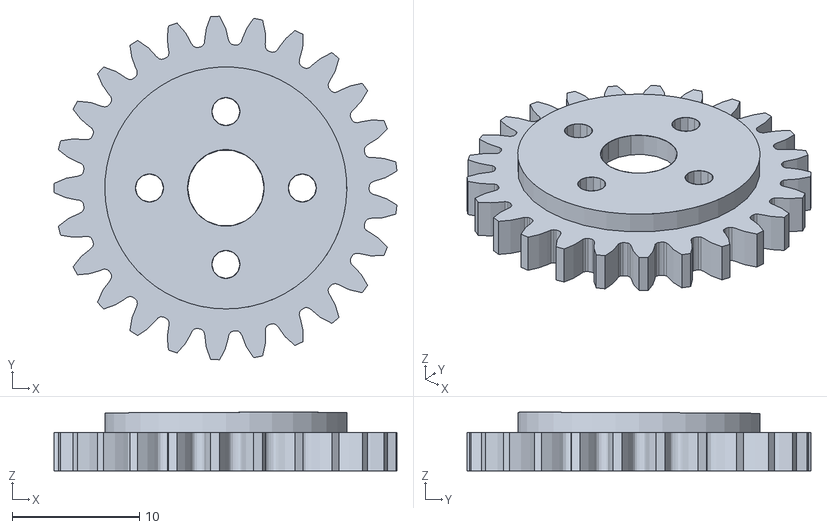
[picture p58: CAD file, 2026-05-18]
RAPID-Hand-main/RapidHandHardware/mechanical_structure/3D Printed Parts/机械件/g2-1m25t直齿轮（驱动轮）改.STL
26.9 x 27.0 x 4.60
