David0412-sun/Rapidhand/RAPID-Hand-main/RapidHandHardware/mechanical_structure/calibration_board.STL

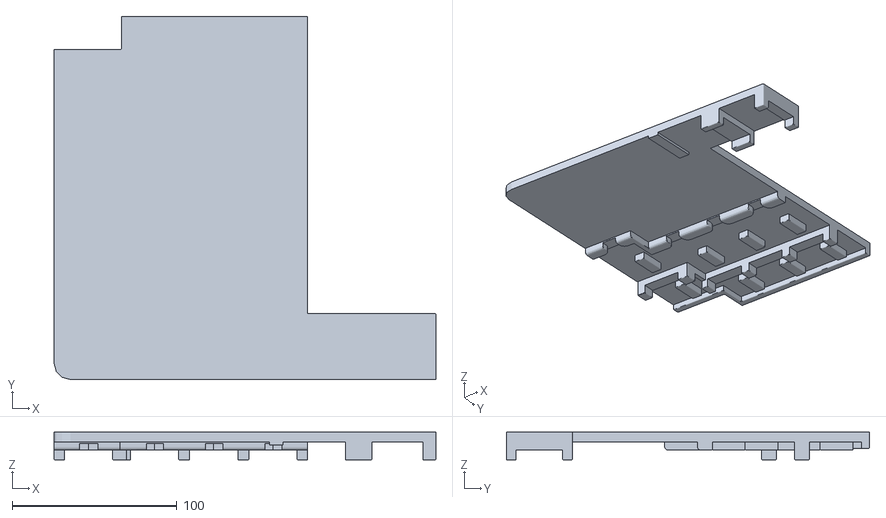
[picture p59: CAD file, 2026-05-18]
RAPID-Hand-main/RapidHandHardware/mechanical_structure/calibration_board.STL
232.0 x 220.5 x 17.0
