David0412-sun/Rapidhand/RAPID-Hand-main/RapidHandHardware/mechanical_structure/FingerVIP_Mechanical_structure/3D_Printing_Parts/Finger/F2.STL

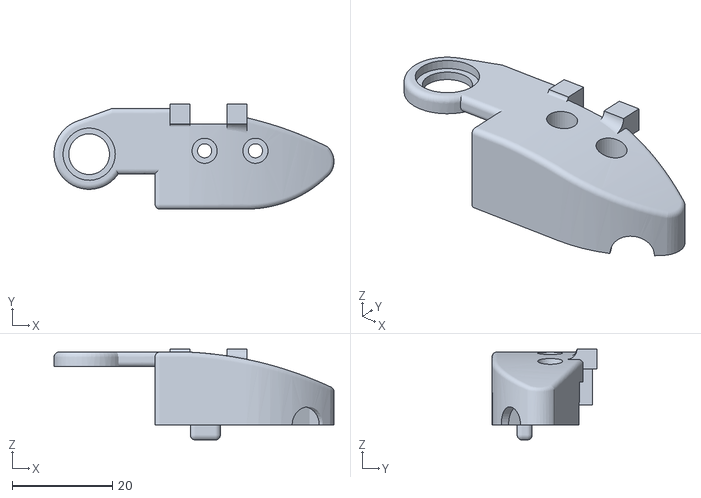
[picture p60: CAD file, 2026-09-17]
RAPID-Hand-main/RapidHandHardware/mechanical_structure/FingerVIP_Mechanical_structure/3D_Printing_Parts/Finger/F2.STL
55.7 x 20.9 x 18.1
