David0412-sun/Rapidhand/RAPID-Hand-main/RapidHandHardware/RapidTeleop/assets/robots/arms/ur10e/meshes/collision/shoulder.obj

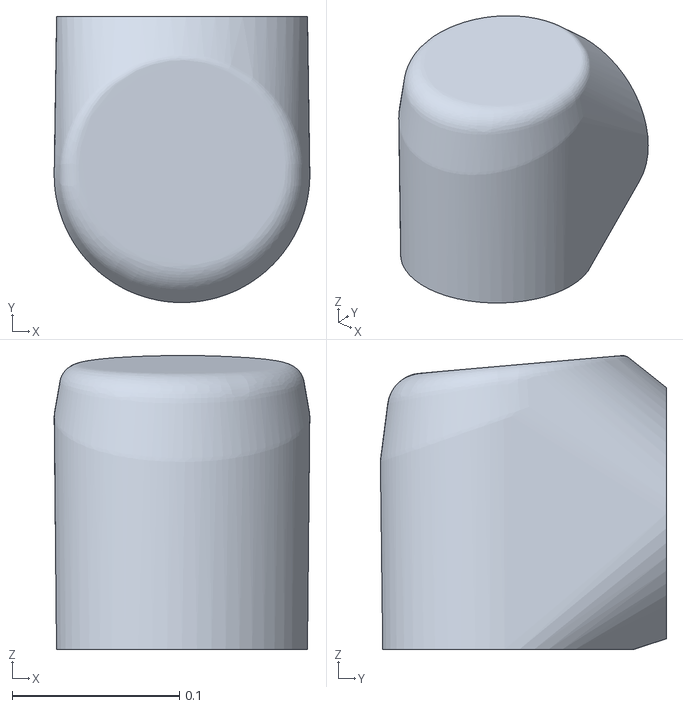
[picture p62: CAD file, 2026-05-18]
RAPID-Hand-main/RapidHandHardware/RapidTeleop/assets/robots/arms/ur10e/meshes/collision/shoulder.obj
0.153 x 0.171 x 0.176
