David0412-sun/Rapidhand/RAPID-Hand-main/RapidHandHardware/RapidTeleop/assets/robots/arms/ur10e/meshes/visual/base.obj

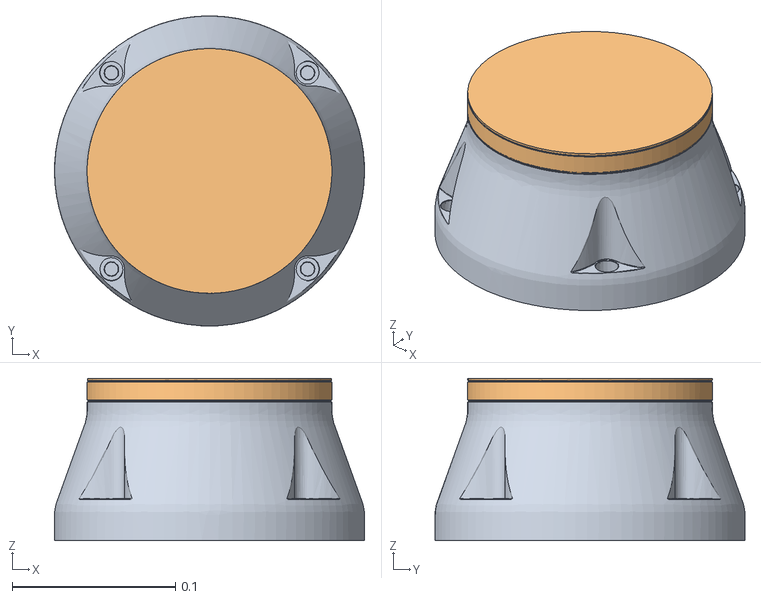
[picture p63: CAD file, 2026-05-18]
RAPID-Hand-main/RapidHandHardware/RapidTeleop/assets/robots/arms/ur10e/meshes/visual/base.obj
0.19 x 0.19 x 0.0993
eSeries_UR10e_010
eSeries_UR10e_001
