David0412-sun/Rapidhand/RAPID-Hand-main/RapidHandHardware/RapidTeleop/assets/robots/arms/ur5e/meshes/collision/wrist2.obj

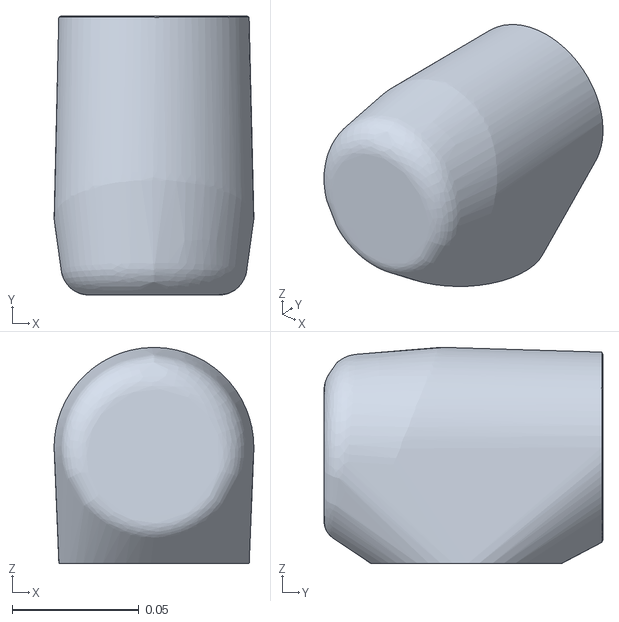
[picture p64: CAD file, 2026-05-18]
RAPID-Hand-main/RapidHandHardware/RapidTeleop/assets/robots/arms/ur5e/meshes/collision/wrist2.obj
0.0787 x 0.11 x 0.0852
