David0412-sun/Rapidhand/RAPID-Hand-main/RapidHandHardware/RapidTeleop/assets/robots/arms/ur5e/meshes/visual/wrist2.obj

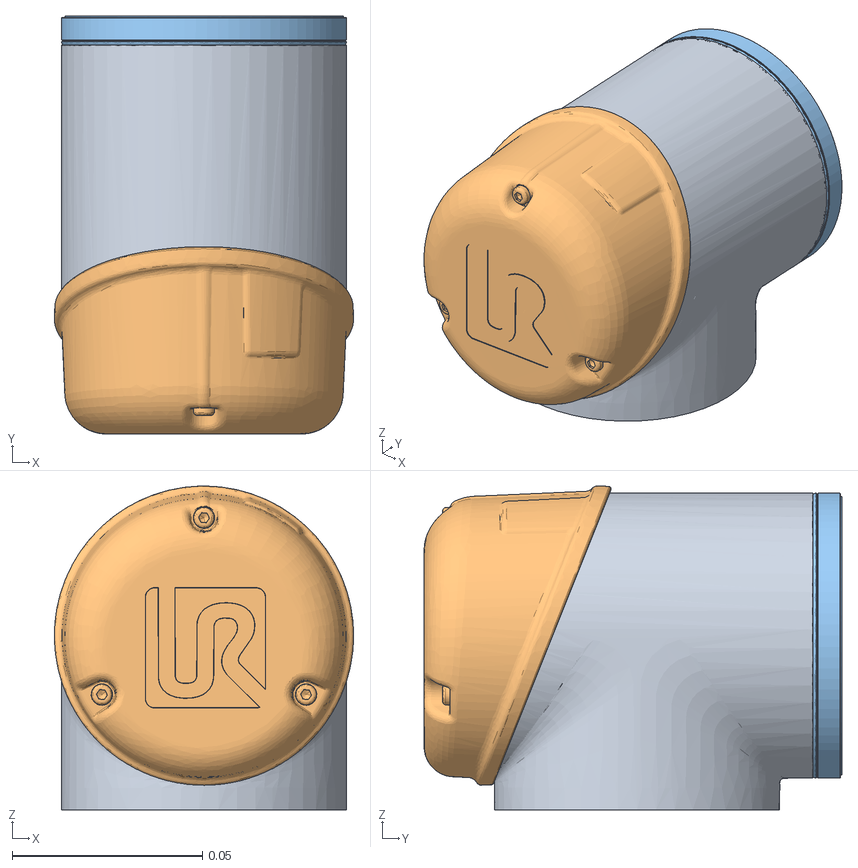
[picture p65: CAD file, 2026-05-18]
RAPID-Hand-main/RapidHandHardware/RapidTeleop/assets/robots/arms/ur5e/meshes/visual/wrist2.obj
0.0787 x 0.11 x 0.0852
eSeries_UR5e_049
eSeries_UR5e_029
eSeries_UR5e_002
