David0412-sun/Rapidhand/RAPID-Hand-main/RapidHandHardware/RapidTeleop/assets/robots/hands/allegro_hand/meshes/collision/link_tip.obj

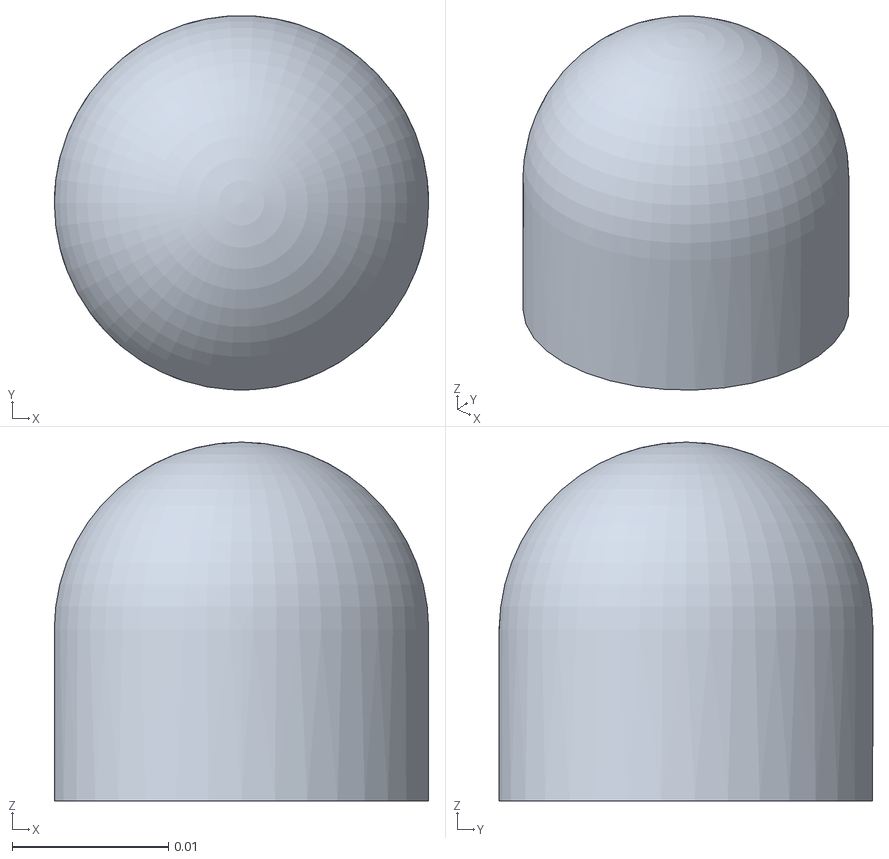
[picture p66: CAD file, 2026-05-18]
RAPID-Hand-main/RapidHandHardware/RapidTeleop/assets/robots/hands/allegro_hand/meshes/collision/link_tip.obj
0.024 x 0.024 x 0.023
