David0412-sun/Rapidhand/RAPID-Hand-main/RapidHandHardware/RapidTeleop/assets/robots/hands/allegro_hand/variation/meshes/collision/longer_finger_tip.obj

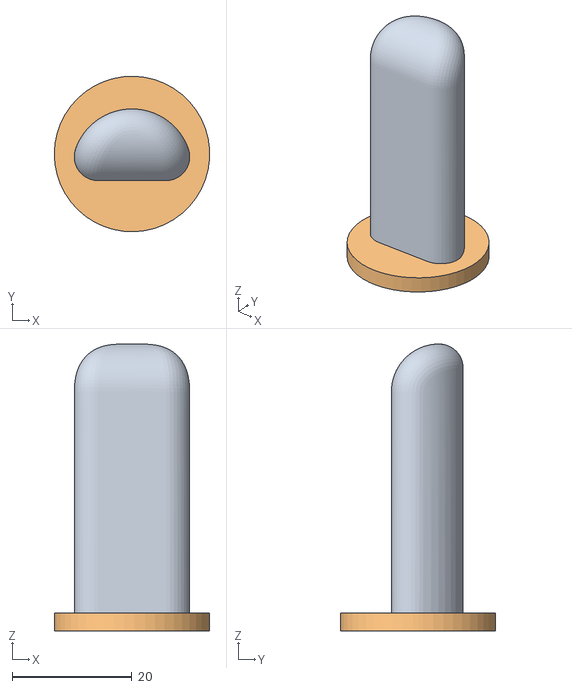
[picture p68: CAD file, 2026-05-18]
RAPID-Hand-main/RapidHandHardware/RapidTeleop/assets/robots/hands/allegro_hand/variation/meshes/collision/longer_finger_tip.obj
26.0 x 26.0 x 48.0
geometry_0
geometry_1
