David0412-sun/Rapidhand/RAPID-Hand-main/RapidHandHardware/RapidTeleop/assets/robots/hands/leap_hand/meshes/collision/white_tip_thumb.obj

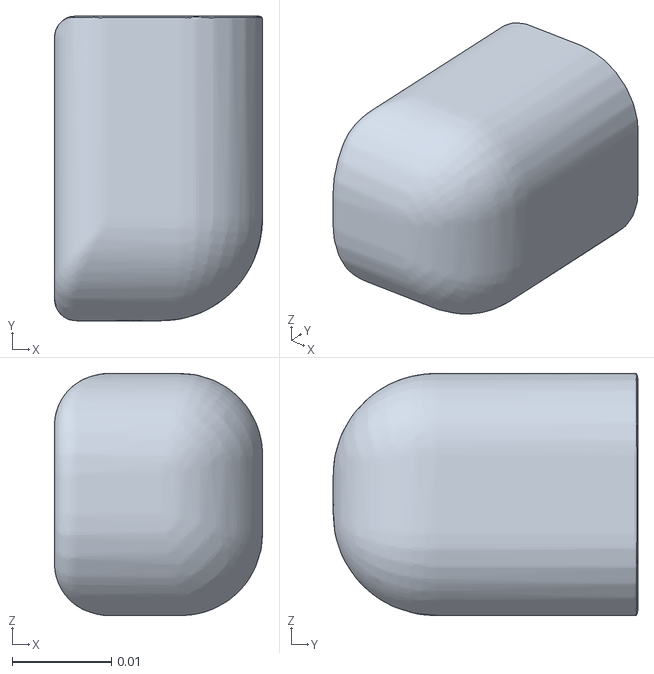
[picture p70: CAD file, 2026-05-18]
RAPID-Hand-main/RapidHandHardware/RapidTeleop/assets/robots/hands/leap_hand/meshes/collision/white_tip_thumb.obj
0.0209 x 0.0306 x 0.0243
