David0412-sun/Rapidhand/RAPID-Hand-main/RapidHandHardware/RapidTeleop/assets/robots/hands/leap_hand/meshes/visual/palm_lower_left.obj

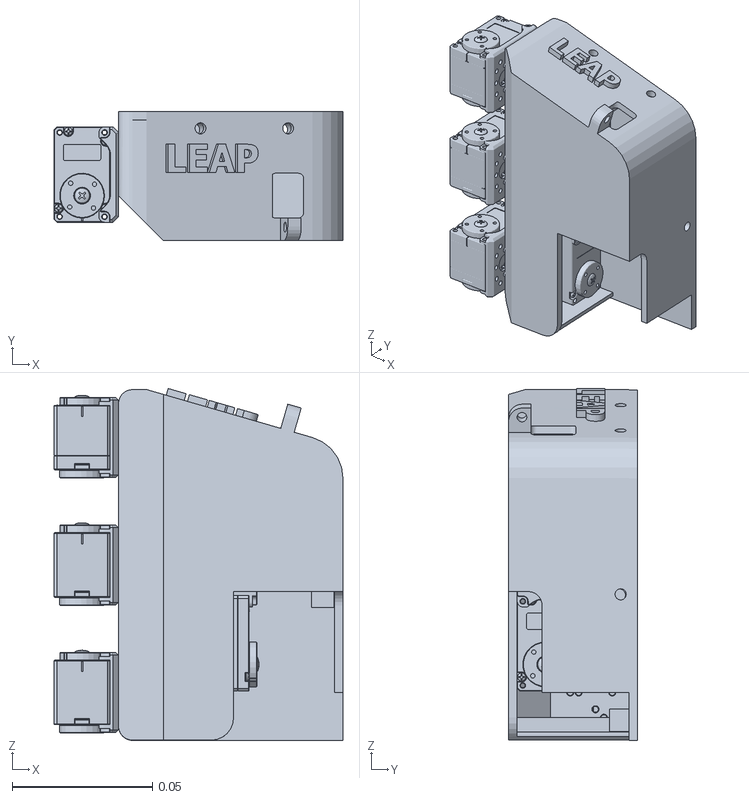
[picture p71: CAD file, 2026-05-18]
RAPID-Hand-main/RapidHandHardware/RapidTeleop/assets/robots/hands/leap_hand/meshes/visual/palm_lower_left.obj
0.103 x 0.046 x 0.125
