David0412-sun/Rapidhand/RAPID-Hand-main/RapidHandHardware/RapidTeleop/assets/robots/hands/rapid_hand/meshes/IPIP.STL

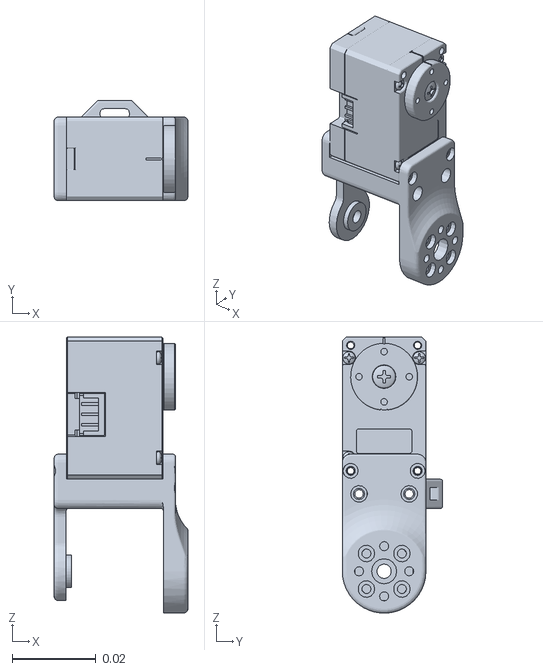
[picture p72: CAD file, 2026-05-18]
RAPID-Hand-main/RapidHandHardware/RapidTeleop/assets/robots/hands/rapid_hand/meshes/IPIP.STL
0.032 x 0.024 x 0.066
