David0412-sun/Rapidhand/RAPID-Hand-main/RapidHandHardware/mechanical_structure/3D Printed Parts/3d打印文件/手指tactile3d打印/f9-食指底座.step.STL

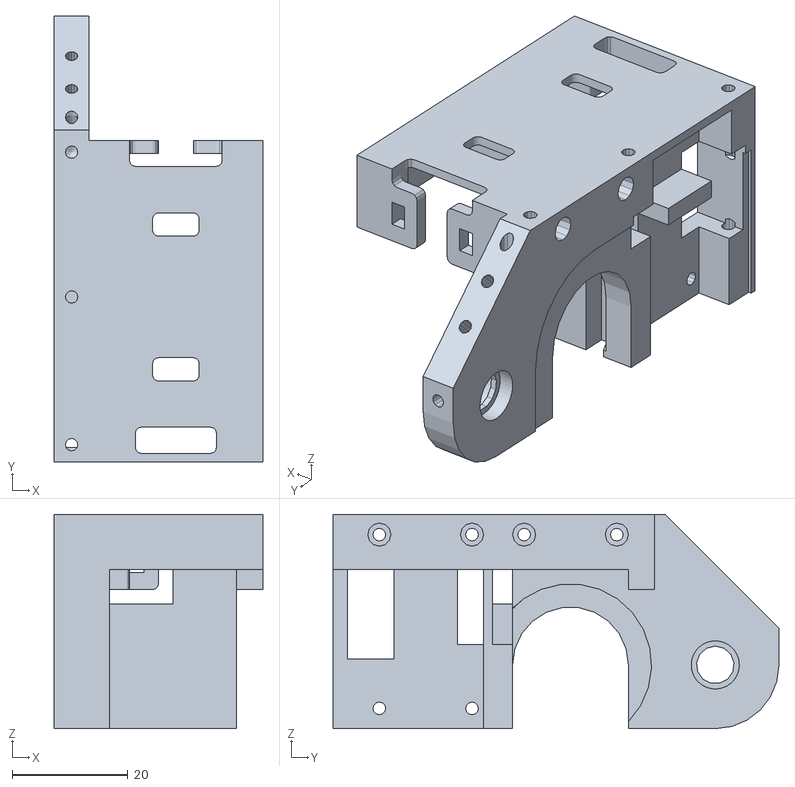
[picture p73: CAD file, 2026-05-18]
RAPID-Hand-main/RapidHandHardware/mechanical_structure/3D Printed Parts/3d打印文件/手指tactile3d打印/f9-食指底座.step.STL
36.0 x 77.0 x 37.0
