David0412-sun/Rapidhand/RAPID-Hand-main/RapidHandHardware/mechanical_structure/3D Printed Parts/F6-近指连接件下.STL

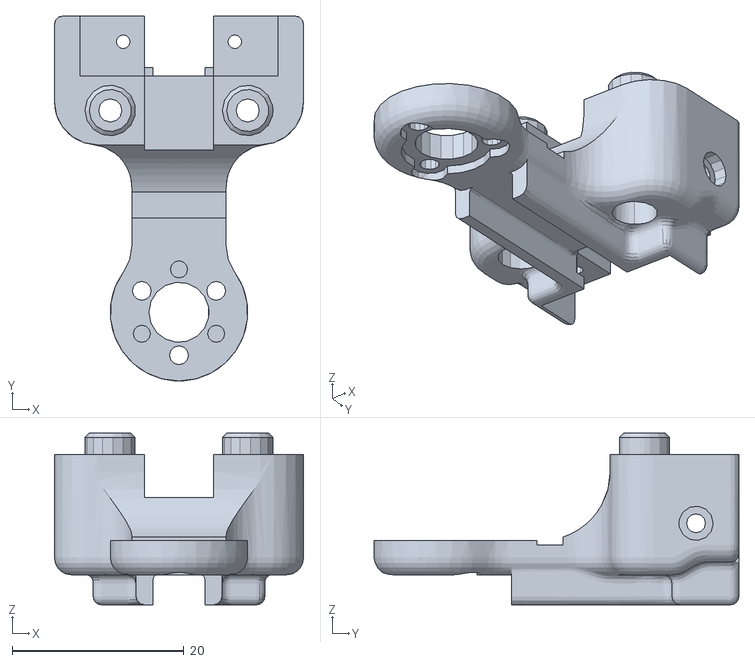
[picture p74: CAD file, 2026-05-18]
RAPID-Hand-main/RapidHandHardware/mechanical_structure/3D Printed Parts/F6-近指连接件下.STL
29.0 x 42.5 x 20.0
