David0412-sun/Rapidhand/RAPID-Hand-main/RapidHandHardware/mechanical_structure/3D Printed Parts/mesh/URDF/PALM_URDF_0723_collision_featured_1.SLDASM/meshes/LPIP.STL

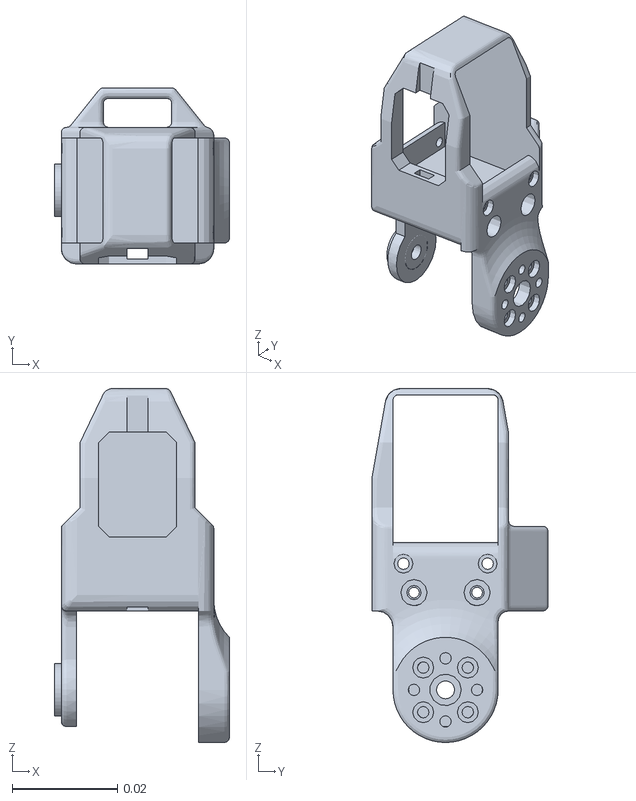
[picture p75: CAD file, 2026-09-09]
RAPID-Hand-main/RapidHandHardware/mechanical_structure/3D Printed Parts/mesh/URDF/PALM_URDF_0723_collision_featured_1.SLDASM/meshes/LPIP.STL
0.0333 x 0.0335 x 0.0673
