David0412-sun/Rapidhand/RAPID-Hand-main/RapidHandHardware/mechanical_structure/3D Printed Parts/mesh/URDF/PALM_URDF_0724_collision_featured_4.SLDASM/meshes/RPIP_TACTILE.STL

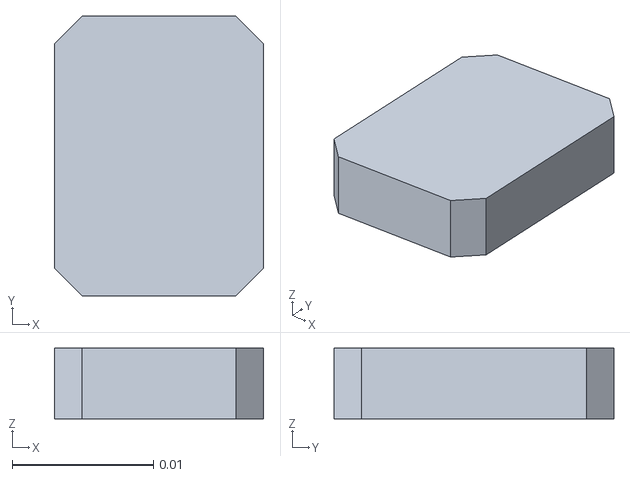
[picture p77: CAD file, 2026-09-09]
RAPID-Hand-main/RapidHandHardware/mechanical_structure/3D Printed Parts/mesh/URDF/PALM_URDF_0724_collision_featured_4.SLDASM/meshes/RPIP_TACTILE.STL
0.0148 x 0.0198 x 0.005
