David0412-sun/Rapidhand/RAPID-Hand-main/RapidHandHardware/mechanical_structure/3D Printed Parts/机械件/g5-1m18t锥齿轮(从动轮)改.STL

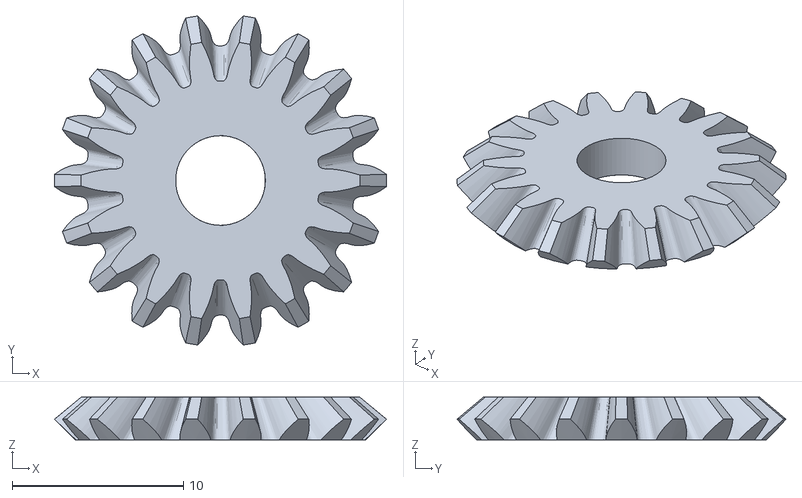
[picture p78: CAD file, 2026-05-18]
RAPID-Hand-main/RapidHandHardware/mechanical_structure/3D Printed Parts/机械件/g5-1m18t锥齿轮(从动轮)改.STL
19.4 x 19.2 x 2.50
