David0412-sun/Rapidhand/RAPID-Hand-main/RapidHandHardware/mechanical_structure/FingerVIP_Mechanical_structure/3D_Printing_Parts/Finger/F1.STL

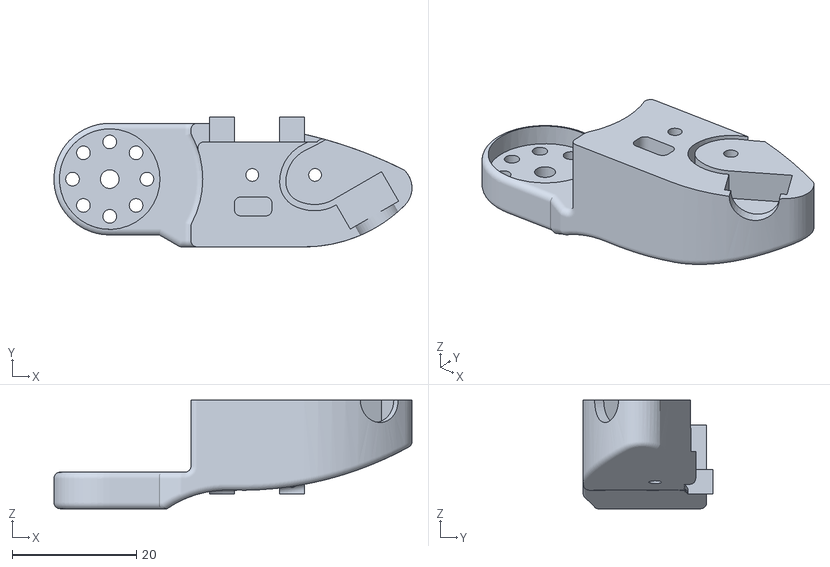
[picture p79: CAD file, 2026-09-17]
RAPID-Hand-main/RapidHandHardware/mechanical_structure/FingerVIP_Mechanical_structure/3D_Printing_Parts/Finger/F1.STL
57.7 x 20.9 x 17.5
