David0412-sun/Rapidhand/RAPID-Hand-main/RapidHandHardware/mechanical_structure/FingerVIP_Mechanical_structure/3D_Printing_Parts/Thumb/T1.STL

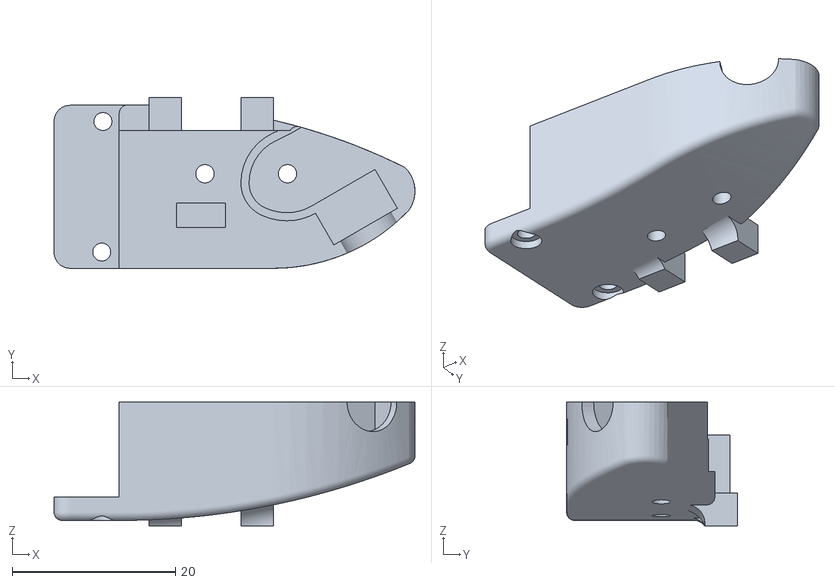
[picture p80: CAD file, 2026-09-17]
RAPID-Hand-main/RapidHandHardware/mechanical_structure/FingerVIP_Mechanical_structure/3D_Printing_Parts/Thumb/T1.STL
44.3 x 20.9 x 15.2
