David0412-sun/Rapidhand/RAPID-Hand-main/RapidHandHardware/RapidTeleop/assets/robots/arms/ur10e/meshes/collision/forearm.obj

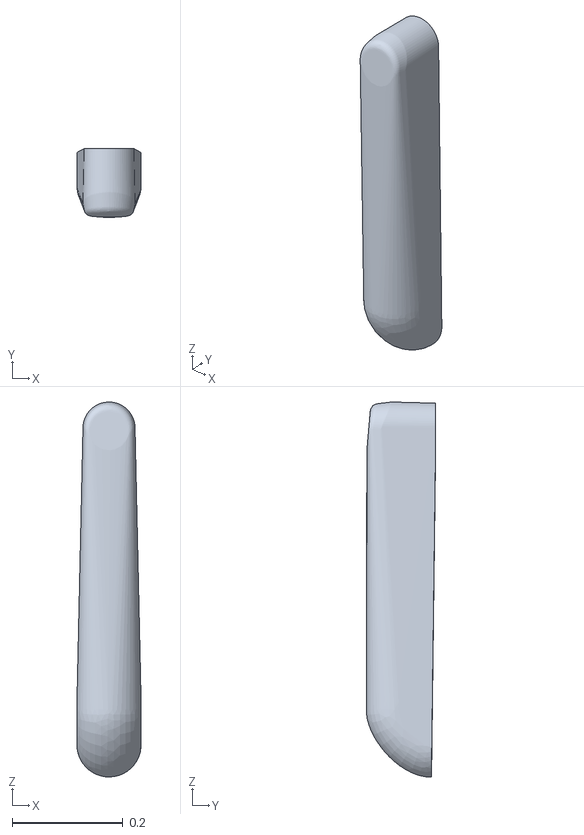
[picture p81: CAD file, 2026-05-18]
RAPID-Hand-main/RapidHandHardware/RapidTeleop/assets/robots/arms/ur10e/meshes/collision/forearm.obj
0.116 x 0.125 x 0.676
