David0412-sun/Rapidhand/RAPID-Hand-main/RapidHandHardware/RapidTeleop/assets/robots/arms/ur10e/meshes/visual/wrist2.obj

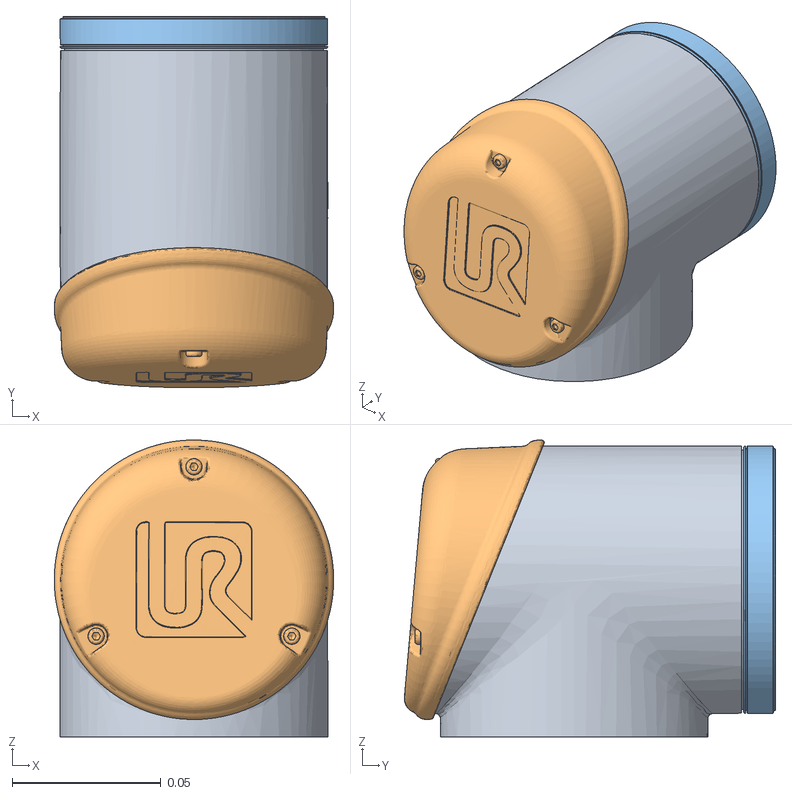
[picture p82: CAD file, 2026-05-18]
RAPID-Hand-main/RapidHandHardware/RapidTeleop/assets/robots/arms/ur10e/meshes/visual/wrist2.obj
0.094 x 0.125 x 0.0999
eSeries_UR10e_040
eSeries_UR10e_030
eSeries_UR10e_035
