David0412-sun/Rapidhand/RAPID-Hand-main/RapidHandHardware/RapidTeleop/assets/robots/arms/ur5e/meshes/collision/wrist3.obj

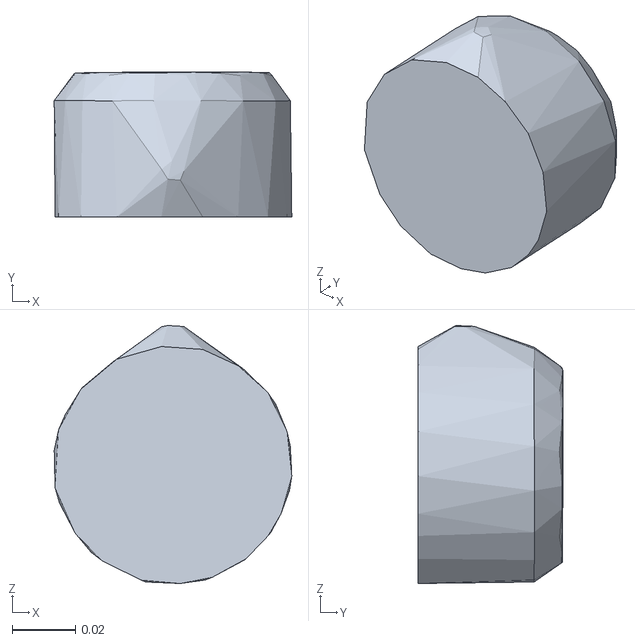
[picture p83: CAD file, 2026-05-18]
RAPID-Hand-main/RapidHandHardware/RapidTeleop/assets/robots/arms/ur5e/meshes/collision/wrist3.obj
0.0751 x 0.0458 x 0.0816
