David0412-sun/Rapidhand/RAPID-Hand-main/RapidHandHardware/RapidTeleop/assets/robots/arms/ur5e/meshes/visual/base.obj

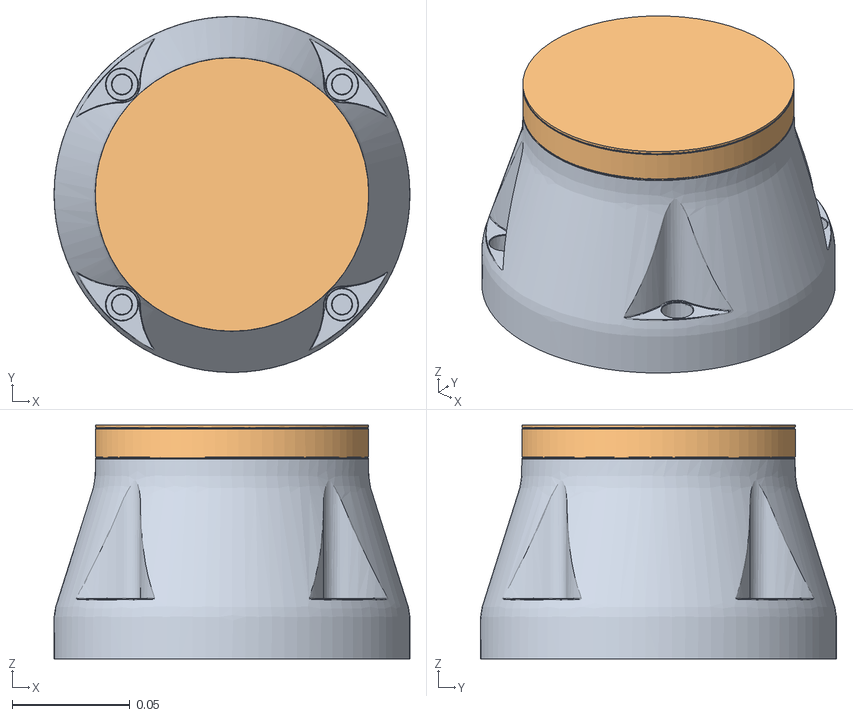
[picture p84: CAD file, 2026-05-18]
RAPID-Hand-main/RapidHandHardware/RapidTeleop/assets/robots/arms/ur5e/meshes/visual/base.obj
0.151 x 0.151 x 0.0991
eSeries_UR5e_013
eSeries_UR5e_006
