David0412-sun/Rapidhand/RAPID-Hand-main/RapidHandHardware/RapidTeleop/assets/robots/hands/allegro_hand/variation/meshes/visual/tactile.obj

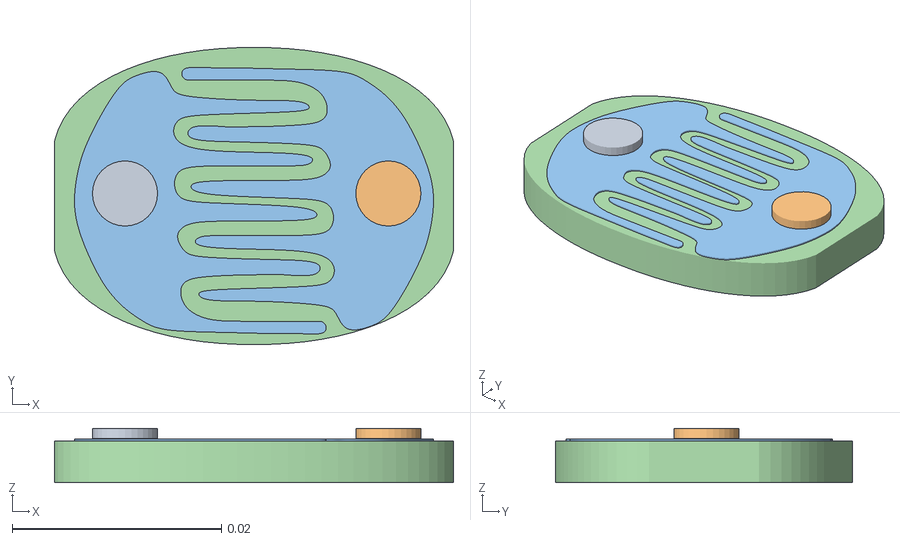
[picture p86: CAD file, 2026-05-18]
RAPID-Hand-main/RapidHandHardware/RapidTeleop/assets/robots/hands/allegro_hand/variation/meshes/visual/tactile.obj
0.0382 x 0.0284 x 0.00519
LIGHT_CATCHER_2
photocell
