David0412-sun/Rapidhand/RAPID-Hand-main/RapidHandHardware/RapidTeleop/assets/robots/hands/leap_hand/meshes/visual/mcp_joint.obj

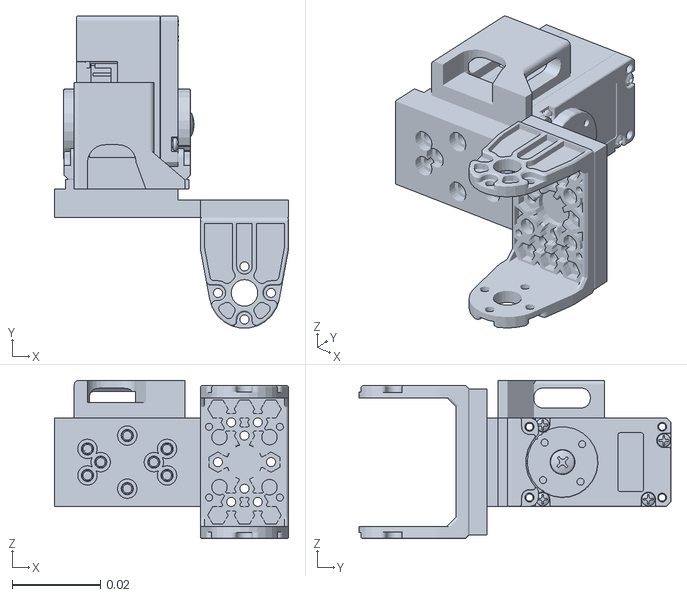
[picture p87: CAD file, 2026-05-18]
RAPID-Hand-main/RapidHandHardware/RapidTeleop/assets/robots/hands/leap_hand/meshes/visual/mcp_joint.obj
0.053 x 0.0705 x 0.0358
