David0412-sun/Rapidhand/RAPID-Hand-main/RapidHandHardware/mechanical_structure/3D Printed Parts/3d打印文件/手指tactile3d打印/手指带摄像头左_倾斜扩大.STL

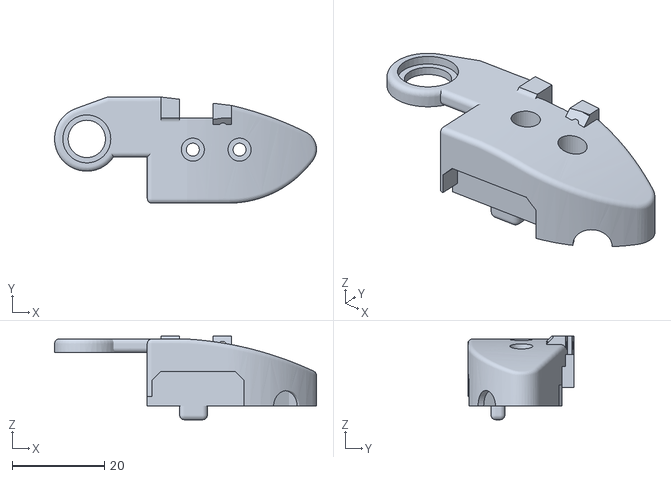
[picture p88: CAD file, 2026-05-18]
RAPID-Hand-main/RapidHandHardware/mechanical_structure/3D Printed Parts/3d打印文件/手指tactile3d打印/手指带摄像头左_倾斜扩大.STL
56.8 x 23.0 x 18.1
