David0412-sun/Rapidhand/RAPID-Hand-main/RapidHandHardware/mechanical_structure/3D Printed Parts/3d打印文件/手掌加工2026-3/拇指/t7-拇指旋转件改走线.STL

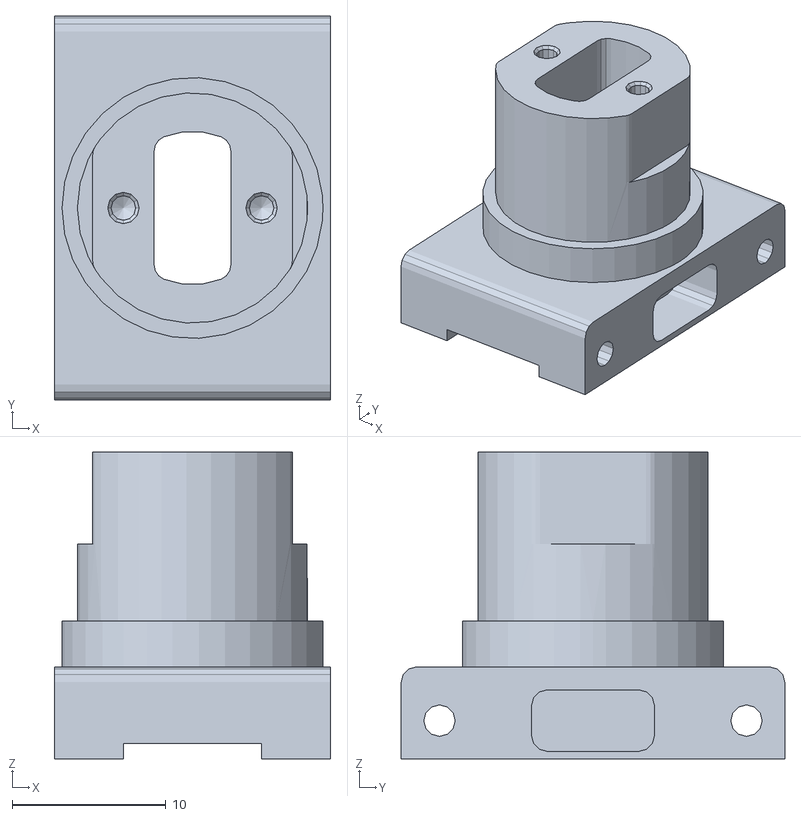
[picture p89: CAD file, 2026-05-18]
RAPID-Hand-main/RapidHandHardware/mechanical_structure/3D Printed Parts/3d打印文件/手掌加工2026-3/拇指/t7-拇指旋转件改走线.STL
18.0 x 25.0 x 20.0
