David0412-sun/Rapidhand/RAPID-Hand-main/RapidHandHardware/mechanical_structure/3D Printed Parts/mesh/URDF/PALM_URDF_0723_collision_featured_1.SLDASM/meshes/TDIP_CAMERA.STL

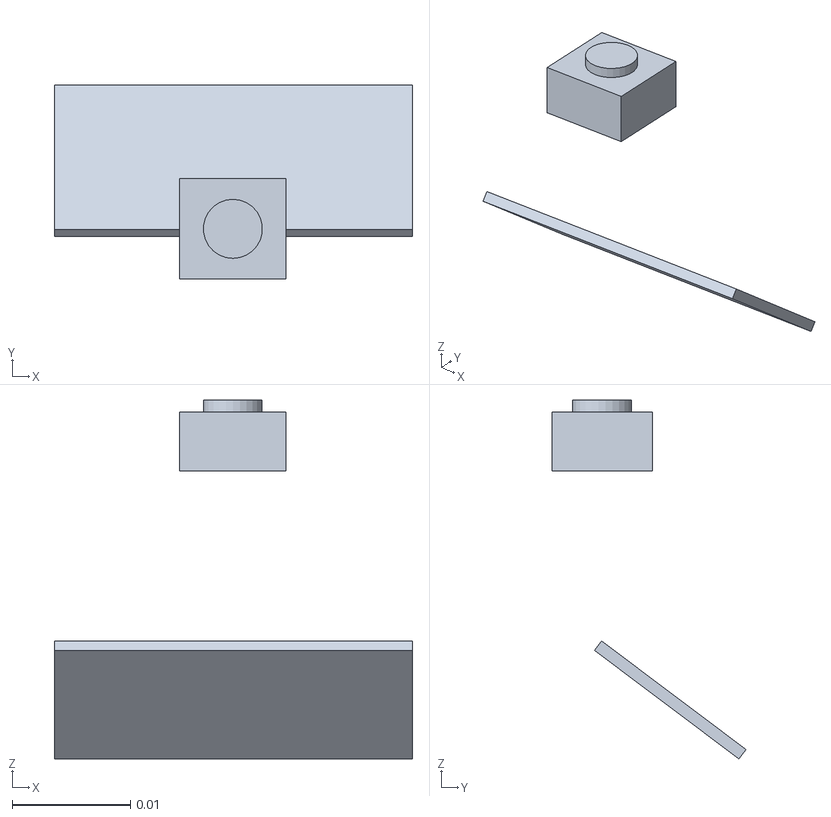
[picture p90: CAD file, 2026-09-09]
RAPID-Hand-main/RapidHandHardware/mechanical_structure/3D Printed Parts/mesh/URDF/PALM_URDF_0723_collision_featured_1.SLDASM/meshes/TDIP_CAMERA.STL
0.0303 x 0.0164 x 0.0304
