David0412-sun/Rapidhand/RAPID-Hand-main/RapidHandHardware/mechanical_structure/3D Printed Parts/T9-拇指指骨构件下.STL

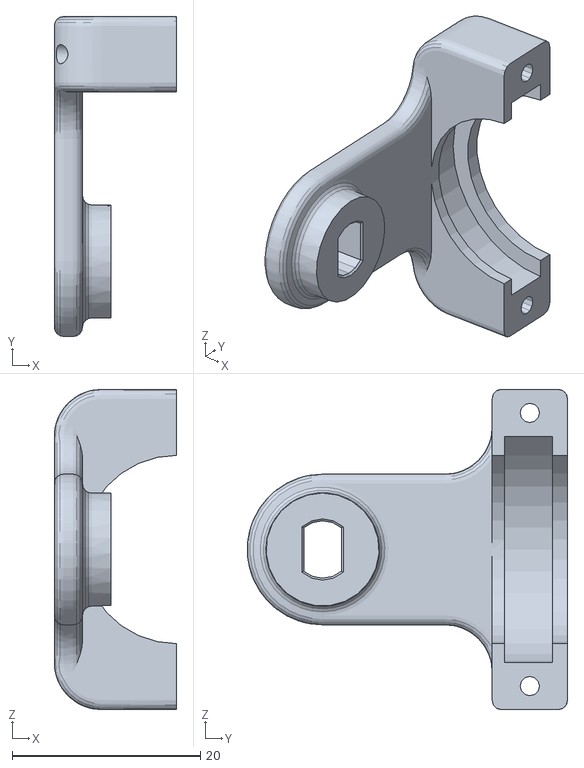
[picture p91: CAD file, 2026-05-18]
RAPID-Hand-main/RapidHandHardware/mechanical_structure/3D Printed Parts/T9-拇指指骨构件下.STL
13.0 x 34.0 x 34.0
