David0412-sun/Rapidhand/RAPID-Hand-main/RapidHandHardware/RapidTeleop/assets/robots/arms/ur10e/meshes/collision/upperarm.obj

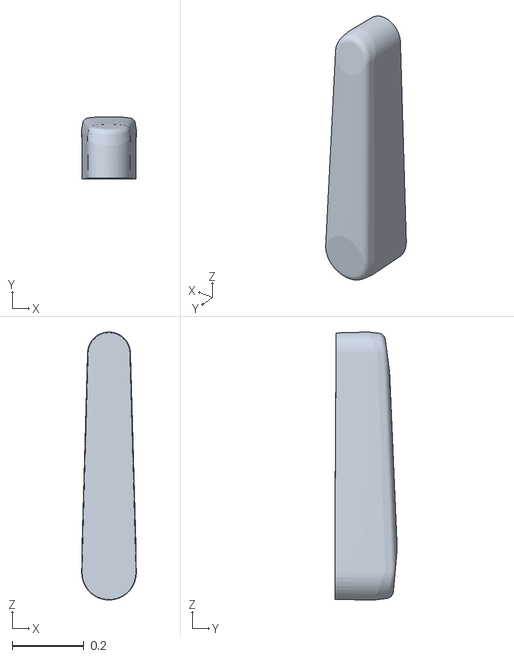
[picture p92: CAD file, 2026-05-18]
RAPID-Hand-main/RapidHandHardware/RapidTeleop/assets/robots/arms/ur10e/meshes/collision/upperarm.obj
0.153 x 0.175 x 0.749
