David0412-sun/Rapidhand/RAPID-Hand-main/RapidHandHardware/RapidTeleop/assets/robots/arms/ur5e/meshes/collision/wrist1.obj

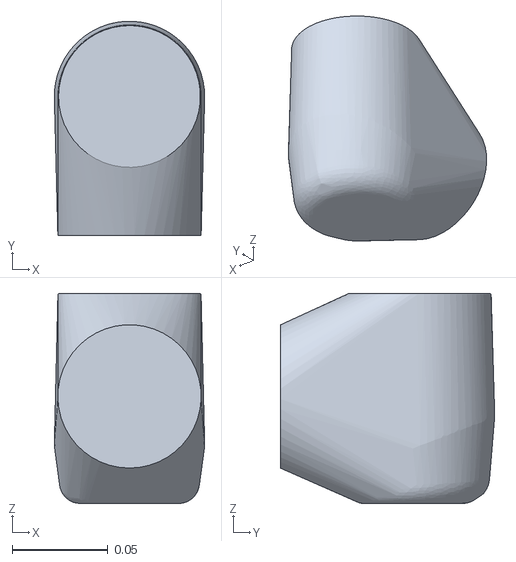
[picture p94: CAD file, 2026-05-18]
RAPID-Hand-main/RapidHandHardware/RapidTeleop/assets/robots/arms/ur5e/meshes/collision/wrist1.obj
0.0787 x 0.112 x 0.11
