David0412-sun/Rapidhand/RAPID-Hand-main/RapidHandHardware/RapidTeleop/assets/robots/arms/ur5e/meshes/visual/forearm.obj

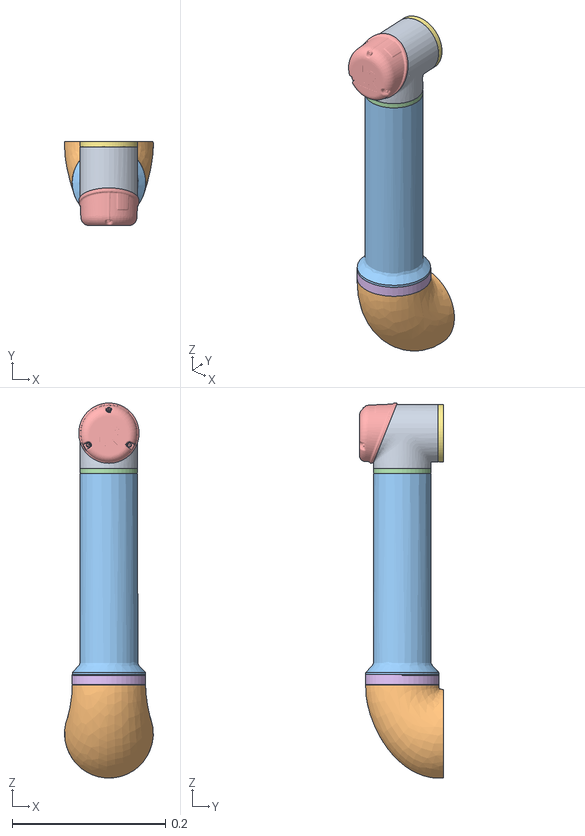
[picture p95: CAD file, 2026-05-18]
RAPID-Hand-main/RapidHandHardware/RapidTeleop/assets/robots/arms/ur5e/meshes/visual/forearm.obj
0.116 x 0.11 x 0.489
eSeries_UR5e_028
eSeries_UR5e_020
eSeries_UR5e_022
eSeries_UR5e_023
eSeries_UR5e_024
eSeries_UR5e_021
eSeries_UR5e_025
