David0412-sun/Rapidhand/RAPID-Hand-main/RapidHandHardware/RapidTeleop/assets/robots/hands/allegro_hand/meshes/visual/base_link_left.obj

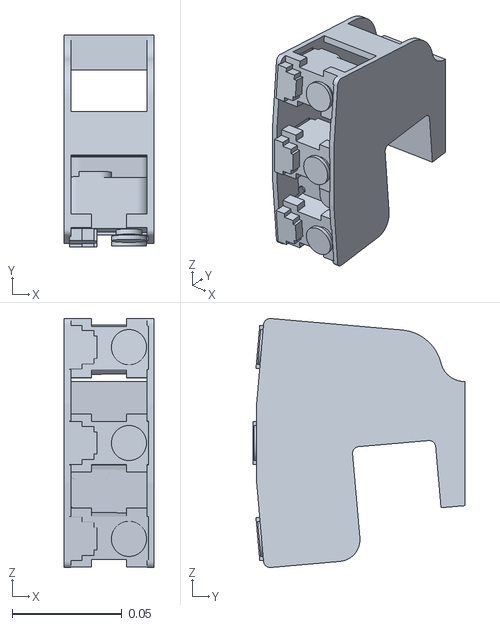
[picture p96: CAD file, 2026-05-18]
RAPID-Hand-main/RapidHandHardware/RapidTeleop/assets/robots/hands/allegro_hand/meshes/visual/base_link_left.obj
0.0408 x 0.0967 x 0.113
