David0412-sun/Rapidhand/RAPID-Hand-main/RapidHandHardware/RapidTeleop/assets/robots/hands/leap_hand/meshes/visual/fingertip.obj

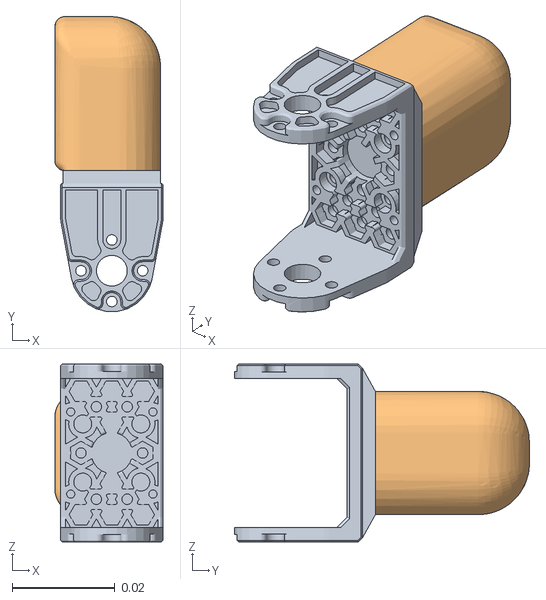
[picture p97: CAD file, 2026-05-18]
RAPID-Hand-main/RapidHandHardware/RapidTeleop/assets/robots/hands/leap_hand/meshes/visual/fingertip.obj
0.0211 x 0.0574 x 0.0346
fingertip
fingertip_W
