David0412-sun/Rapidhand/RAPID-Hand-main/RapidHandHardware/RapidTeleop/assets/robots/hands/rapid_hand/meshes/RMCPS.STL

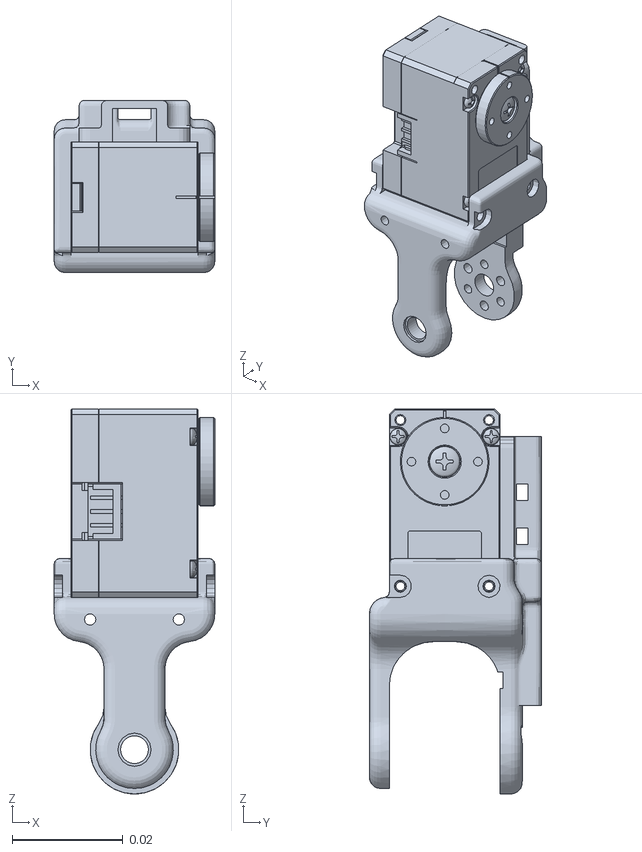
[picture p98: CAD file, 2026-05-18]
RAPID-Hand-main/RapidHandHardware/RapidTeleop/assets/robots/hands/rapid_hand/meshes/RMCPS.STL
0.029 x 0.0311 x 0.0695
