David0412-sun/Rapidhand/RAPID-Hand-main/RapidHandHardware/mechanical_structure/3D Printed Parts/3d打印文件/手指tactile3d打印/f6_tactile.STL

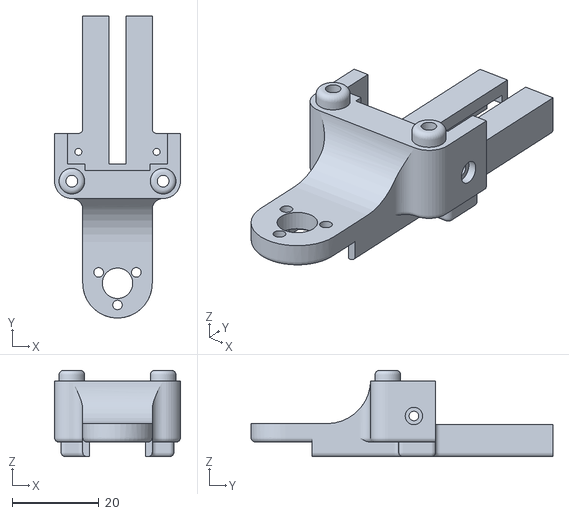
[picture p99: CAD file, 2026-05-18]
RAPID-Hand-main/RapidHandHardware/mechanical_structure/3D Printed Parts/3d打印文件/手指tactile3d打印/f6_tactile.STL
29.0 x 69.5 x 19.9
