David0412-sun/Rapidhand/RAPID-Hand-main/RapidHandHardware/mechanical_structure/3D Printed Parts/3d打印文件/手掌加工2026-3/拇指/t3_tactile.STL

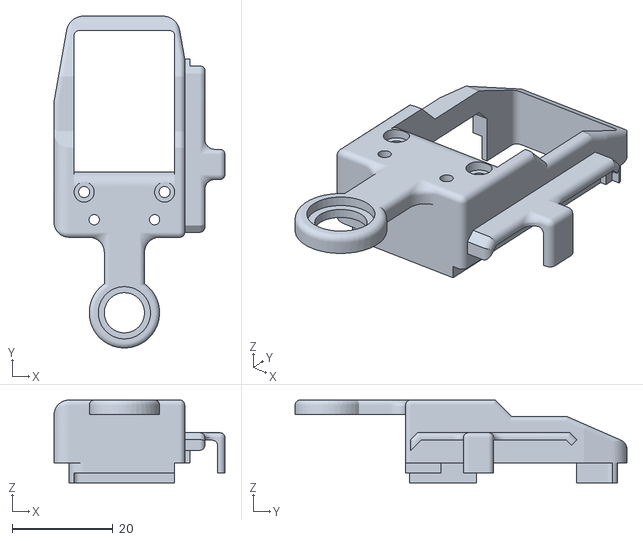
[picture p100: CAD file, 2026-05-18]
RAPID-Hand-main/RapidHandHardware/mechanical_structure/3D Printed Parts/3d打印文件/手掌加工2026-3/拇指/t3_tactile.STL
34.0 x 66.0 x 16.5
