David0412-sun/Rapidhand/RAPID-Hand-main/RapidHandHardware/mechanical_structure/3D Printed Parts/mesh/URDF/PALM_URDF_0723_collision_featured_2.SLDASM/meshes/IMCPS.STL

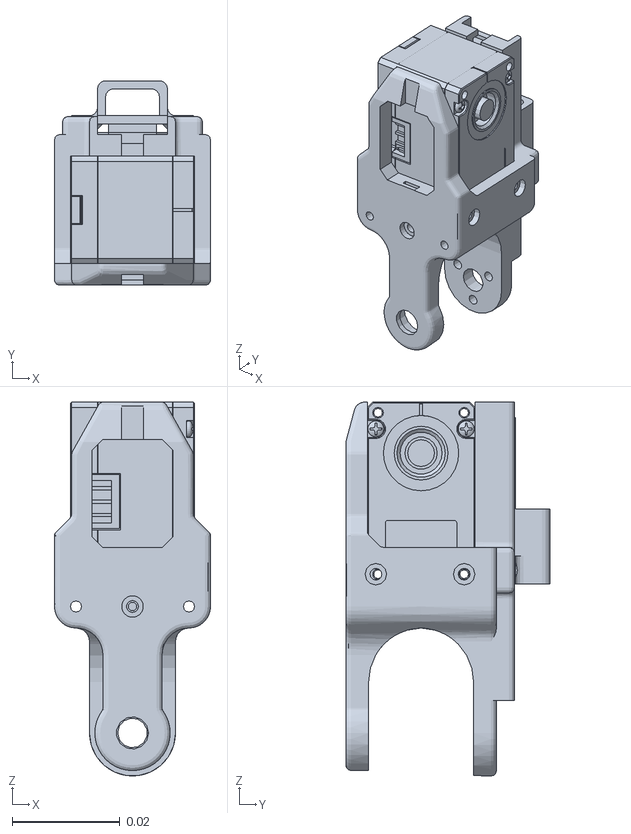
[picture p102: CAD file, 2026-09-09]
RAPID-Hand-main/RapidHandHardware/mechanical_structure/3D Printed Parts/mesh/URDF/PALM_URDF_0723_collision_featured_2.SLDASM/meshes/IMCPS.STL
0.029 x 0.038 x 0.0695
