David0412-sun/Rapidhand/RAPID-Hand-main/RapidHandHardware/mechanical_structure/3D Printed Parts/T7-拇指旋转件.STL

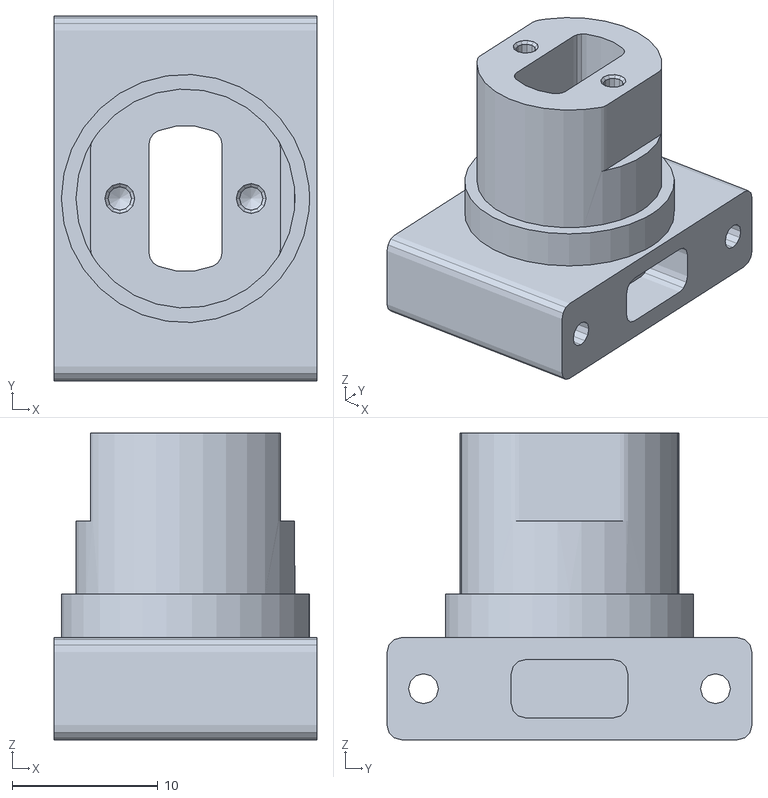
[picture p103: CAD file, 2026-05-18]
RAPID-Hand-main/RapidHandHardware/mechanical_structure/3D Printed Parts/T7-拇指旋转件.STL
18.0 x 25.0 x 21.0
