David0412-sun/Rapidhand/RAPID-Hand-main/RapidHandHardware/RapidTeleop/assets/robots/arms/ur5e/meshes/visual/upperarm.obj

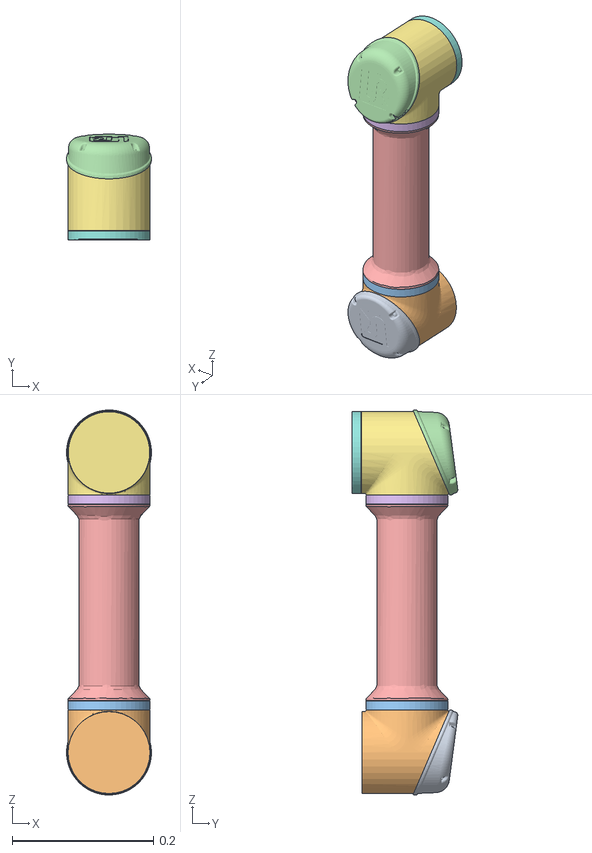
[picture p106: CAD file, 2026-05-18]
RAPID-Hand-main/RapidHandHardware/RapidTeleop/assets/robots/arms/ur5e/meshes/visual/upperarm.obj
0.12 x 0.15 x 0.545
eSeries_UR5e_009
eSeries_UR5e_010
eSeries_UR5e_011
eSeries_UR5e_012
eSeries_UR5e_014
eSeries_UR5e_017
eSeries_UR5e_018
eSeries_UR5e_019
