David0412-sun/Rapidhand/RAPID-Hand-main/RapidHandHardware/RapidTeleop/assets/robots/hands/allegro_hand/meshes/visual/link_13.0.obj

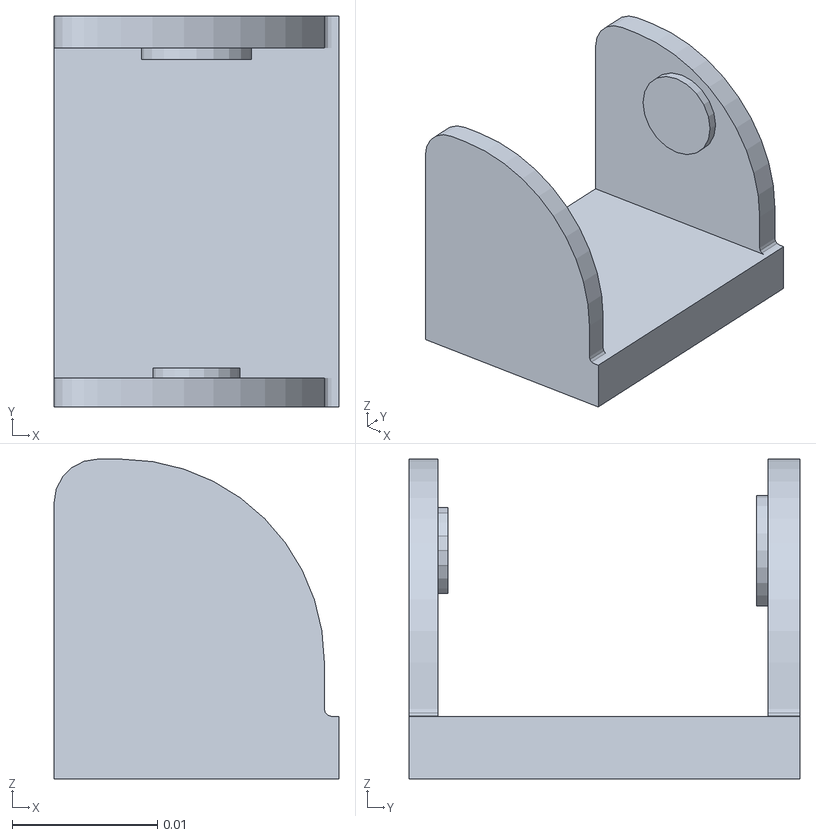
[picture p107: CAD file, 2026-05-18]
RAPID-Hand-main/RapidHandHardware/RapidTeleop/assets/robots/hands/allegro_hand/meshes/visual/link_13.0.obj
0.0196 x 0.0269 x 0.022
