David0412-sun/Rapidhand/RAPID-Hand-main/RapidHandHardware/RapidTeleop/assets/robots/hands/leap_hand/meshes/visual/pip.obj

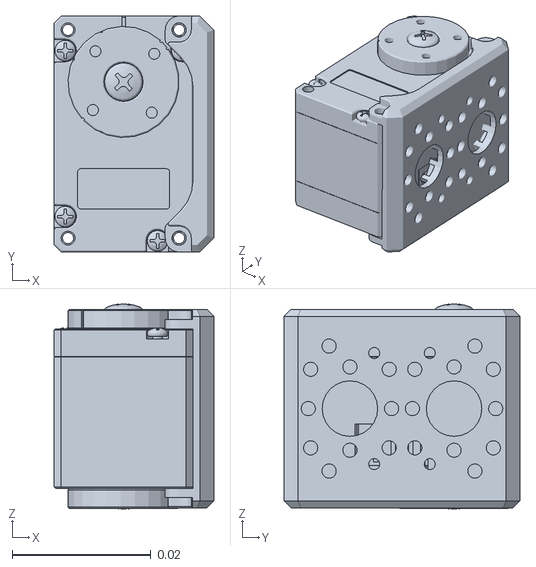
[picture p108: CAD file, 2026-05-18]
RAPID-Hand-main/RapidHandHardware/RapidTeleop/assets/robots/hands/leap_hand/meshes/visual/pip.obj
0.023 x 0.034 x 0.0295
