David0412-sun/Rapidhand/RAPID-Hand-main/RapidHandHardware/RapidTeleop/assets/robots/hands/rapid_hand/meshes/IDIP.STL

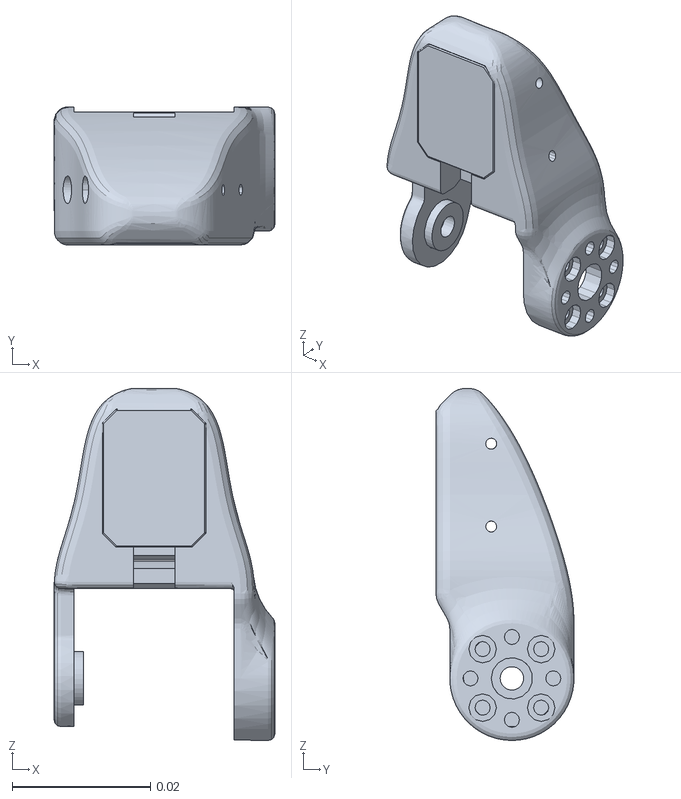
[picture p109: CAD file, 2026-05-18]
RAPID-Hand-main/RapidHandHardware/RapidTeleop/assets/robots/hands/rapid_hand/meshes/IDIP.STL
0.032 x 0.02 x 0.051
