David0412-sun/Rapidhand/RAPID-Hand-main/RapidHandHardware/mechanical_structure/3D Printed Parts/3d打印文件/手指tactile3d打印/f8-mcp十字轴.STL

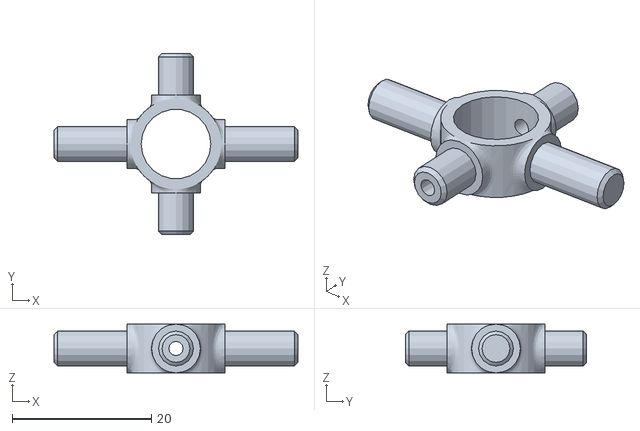
[picture p110: CAD file, 2026-05-18]
RAPID-Hand-main/RapidHandHardware/mechanical_structure/3D Printed Parts/3d打印文件/手指tactile3d打印/f8-mcp十字轴.STL
35.0 x 26.0 x 7.00
