David0412-sun/Rapidhand/RAPID-Hand-main/RapidHandHardware/mechanical_structure/3D Printed Parts/mesh/URDF/PALM_URDF_0723_collision_featured_1.SLDASM/meshes/TMCPS.STL

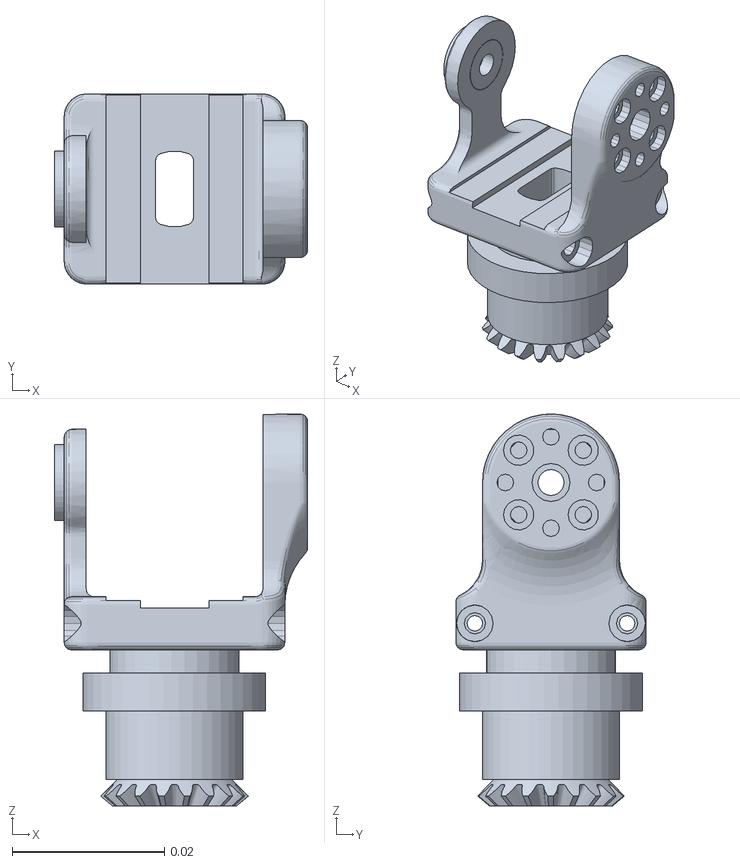
[picture p112: CAD file, 2026-09-09]
RAPID-Hand-main/RapidHandHardware/mechanical_structure/3D Printed Parts/mesh/URDF/PALM_URDF_0723_collision_featured_1.SLDASM/meshes/TMCPS.STL
0.0333 x 0.025 x 0.0515
