David0412-sun/Rapidhand/RAPID-Hand-main/RapidHandHardware/mechanical_structure/3D Printed Parts/thumb/TPIP.SLDASM

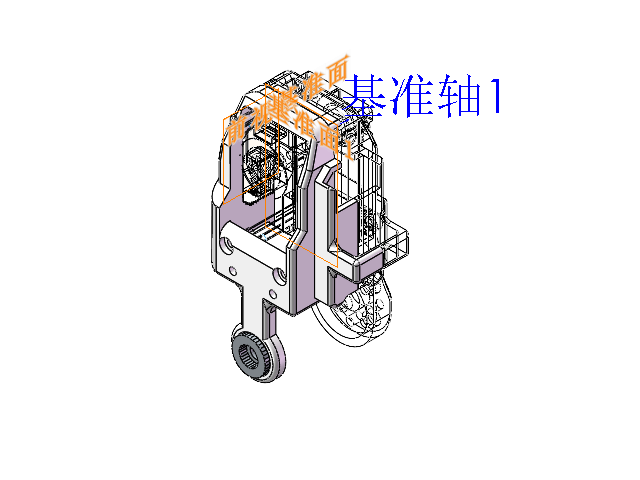
[picture p113: CAD file, 2026-09-09]
RAPID-Hand-main/RapidHandHardware/mechanical_structure/3D Printed Parts/thumb/TPIP.SLDASM
t3_tactile-镜像
t4_tactile_mirrored
tactile
P1-从动销
XL,XC-330
