David0412-sun/Rapidhand/RAPID-Hand-main/RapidHandHardware/mechanical_structure/rss_design/thumb_with_cam/拇指带摄像头.SLDASM

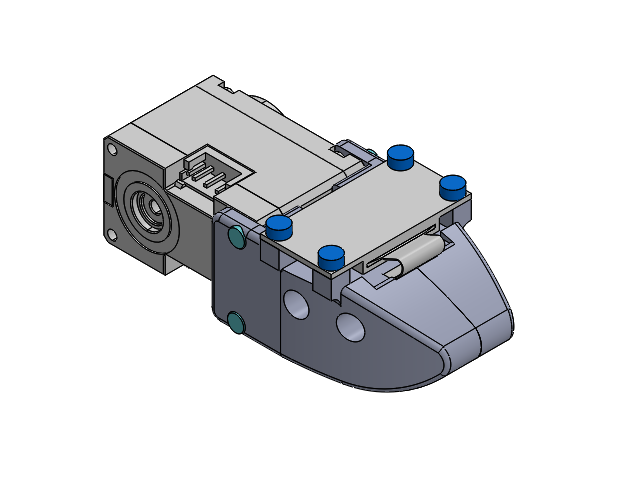
[picture p114: CAD file, 2026-09-17]
RAPID-Hand-main/RapidHandHardware/mechanical_structure/rss_design/thumb_with_cam/拇指带摄像头.SLDASM
拇指带摄像头右改
拇指带摄像头左
camera
XL,XC-330
m2.5_12 x 2
m2_10 x 4
m2_4 x 4
