David0412-sun/Rapidhand/tmp/solidworks_lighting/手指带摄像头_before_lighting.SLDASM

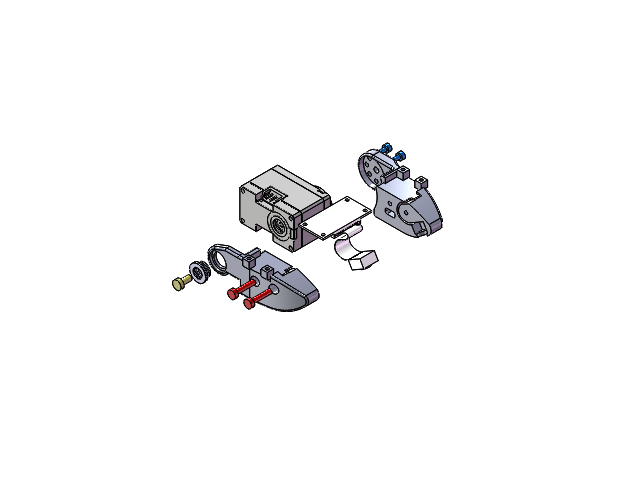
[picture p115: CAD file, 2026-09-16]
tmp/solidworks_lighting/手指带摄像头_before_lighting.SLDASM
f1-CamtipR
f2-CamTipL
m2.5_12 x 2
camera.step
XL,XC-330
m2_4 x 4
p1-从动销.step
m3_6
