David0412-sun/Rapidhand/RAPID-Hand-main/RapidHandHardware/mechanical_structure/Model/XL,XC-330.SLDASM

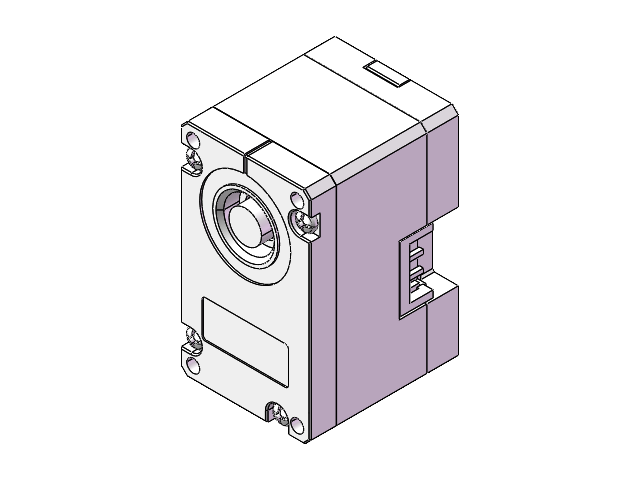
[picture p116: CAD file, 2026-09-09]
RAPID-Hand-main/RapidHandHardware/mechanical_structure/Model/XL,XC-330.SLDASM
DC15_A01_CASE_M_DUMMY.stp
DC15_A01_CASE_F_DUMMY.stp
DC15_A01_CASE_B_DUMMY.stp
DC15_A01_LED_CAP2_DUMMY.stp
PHS_1_7X20_5_DC10.stp x 4
B3B-EH.stp x 2
