David0412-sun/Rapidhand/RAPID-Hand-main/RapidHandHardware/mechanical_structure/rss_design/finger_with_cam/手指带摄像头.SLDASM

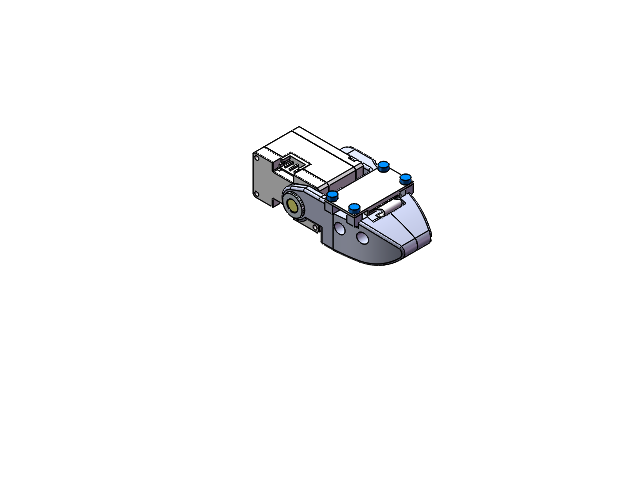
[picture p117: CAD file, 2026-09-17]
RAPID-Hand-main/RapidHandHardware/mechanical_structure/rss_design/finger_with_cam/手指带摄像头.SLDASM
f1-CamtipR
f2-CamTipL
m2.5_12 x 2
m2_4 x 8
camera.step
XL,XC-330
m3_6
p1-Idler_pin
