David0412-sun/Rapidhand/RAPID-Hand-main/RapidHandHardware/mechanical_structure/rss_design/palm_asm/拇指装配.SLDASM

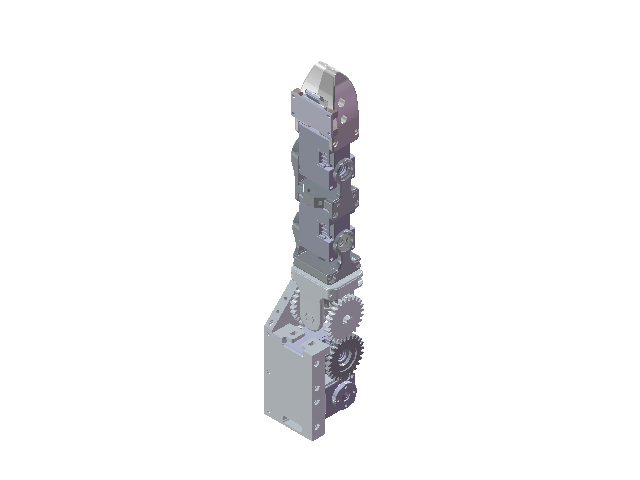
[picture p118: CAD file, 2026-05-18]
RAPID-Hand-main/RapidHandHardware/mechanical_structure/rss_design/palm_asm/拇指装配.SLDASM
t12-拇指底座
XL,XC-330 x 4
g2-1m25t直齿轮（驱动轮）
g3-从动直齿轮
g1-1m25t直齿轮+1m18t锥齿轮 x 2
t11-tmcp十字轴
t10-拇指指骨构件上
t9-拇指指骨构件下
t7-拇指旋转件
t8-1竖直锥齿轮
t8-2齿轮固定环
t5-拇指掌骨构件左
t6-拇指掌骨构件右
t3-拇指连接件左
t4-拇指连接件右
拇指带摄像头右改
拇指带摄像头左
camera
