David0412-sun/Rapidhand/RAPID-Hand-main/RapidHandHardware/mechanical_structure/3D Printed Parts/finger/IMCPS.SLDASM

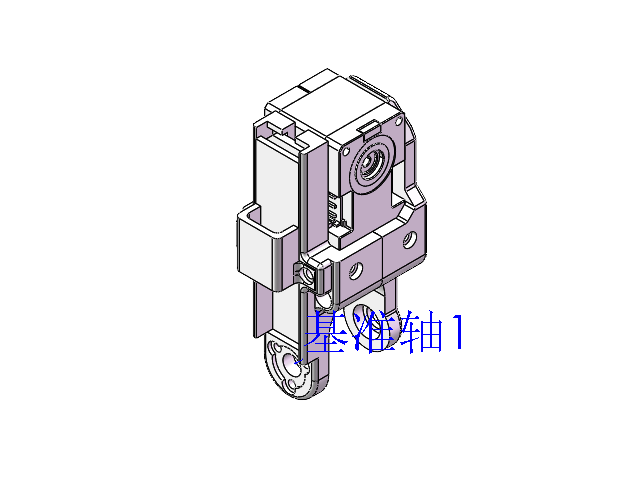
[picture p119: CAD file, 2026-09-09]
RAPID-Hand-main/RapidHandHardware/mechanical_structure/3D Printed Parts/finger/IMCPS.SLDASM
f5_tactile
f6_tactile
f7_tactile
tactile
tactile_板子
XL,XC-330
f5盖子
