David0412-sun/Rapidhand/RAPID-Hand-main/RapidHandHardware/mechanical_structure/3D Printed Parts/palm/支撑装配.SLDASM

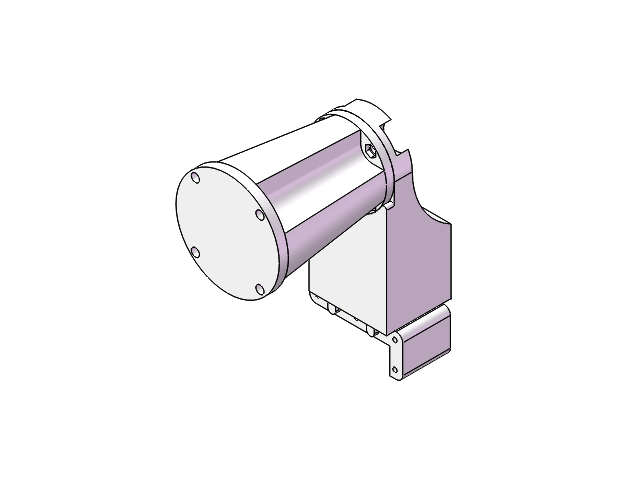
[picture p120: CAD file, 2026-09-17]
RAPID-Hand-main/RapidHandHardware/mechanical_structure/3D Printed Parts/palm/支撑装配.SLDASM
手支架
横向支撑件
