David0412-sun/Rapidhand/RAPID-Hand-main/RapidHandHardware/mechanical_structure/3D Printed Parts/thumb/TDIP.SLDASM

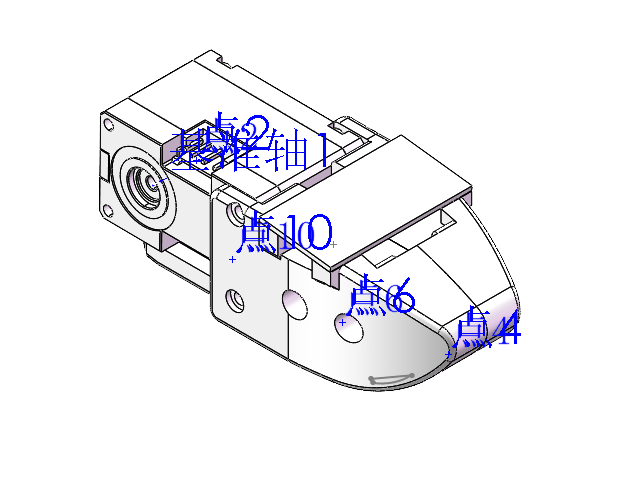
[picture p121: CAD file, 2026-09-09]
RAPID-Hand-main/RapidHandHardware/mechanical_structure/3D Printed Parts/thumb/TDIP.SLDASM
拇指带摄像头右-倾斜扩大改
tactile x 2
XL,XC-330
拇指带摄像头左
拇指摄像头-改走线
