David0412-sun/Rapidhand/RAPID-Hand-main/RapidHandHardware/mechanical_structure/3D Printed Parts/finger/IDIP.SLDASM

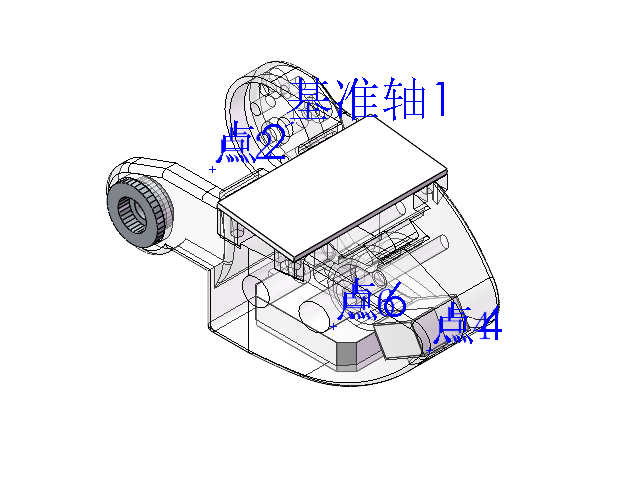
[picture p122: CAD file, 2026-09-09]
RAPID-Hand-main/RapidHandHardware/mechanical_structure/3D Printed Parts/finger/IDIP.SLDASM
手指带摄像头右_倾斜扩大改
手指带摄像头左_倾斜扩大
摄像头-改走线
tactile
P1-从动销
