David0412-sun/Rapidhand/RAPID-Hand-main/RapidHandHardware/mechanical_structure/3D Printed Parts/thumb/TMCPS.SLDASM

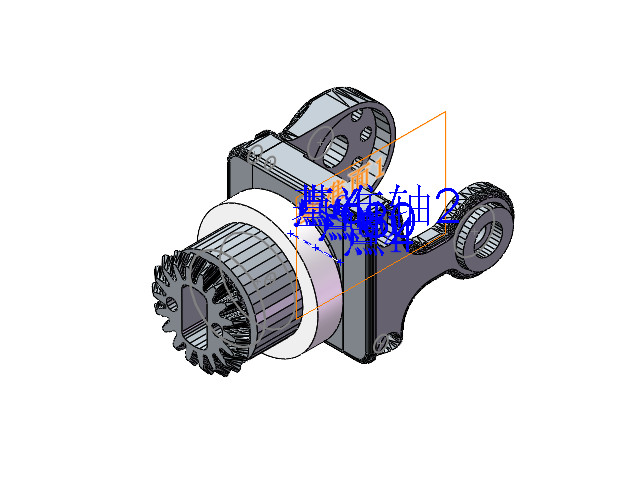
[picture p123: CAD file, 2026-09-09]
RAPID-Hand-main/RapidHandHardware/mechanical_structure/3D Printed Parts/thumb/TMCPS.SLDASM
t7-拇指旋转件
t5-拇指掌骨构件左
t6-拇指掌骨构件右
t8-1竖直锥齿轮
15X24X5_Bearing
t8-2齿轮固定环
P1-从动销
