David0412-sun/Rapidhand/RAPID-Hand-main/RapidHandHardware/mechanical_structure/3D Printed Parts/finger/IPIP.SLDASM

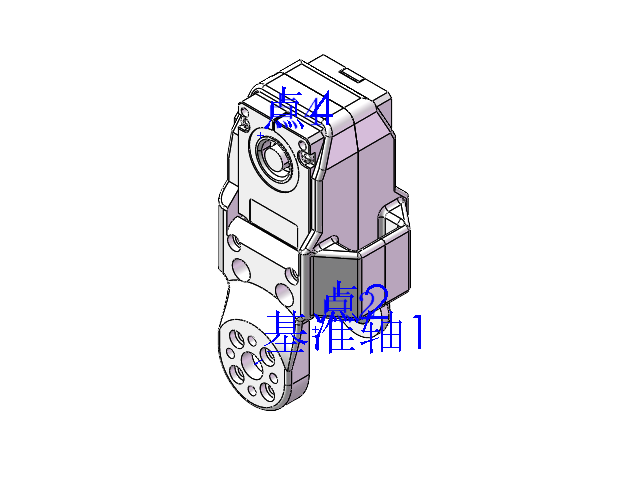
[picture p124: CAD file, 2026-09-09]
RAPID-Hand-main/RapidHandHardware/mechanical_structure/3D Printed Parts/finger/IPIP.SLDASM
f3_tactile
f4_tactile
tactile
XL,XC-330
P1-从动销
