David0412-sun/Rapidhand/RAPID-Hand-main/RapidHandHardware/mechanical_structure/3D Printed Parts/finger/手指装配.SLDASM

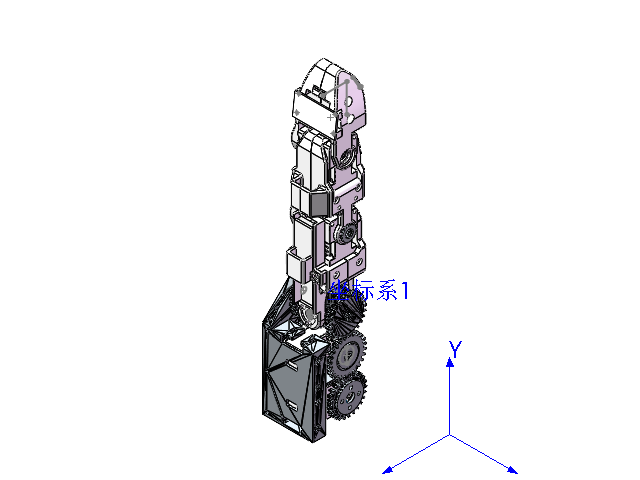
[picture p125: CAD file, 2026-09-09]
RAPID-Hand-main/RapidHandHardware/mechanical_structure/3D Printed Parts/finger/手指装配.SLDASM
f9-食指底座.step
DC15_A01_CASE_M_DUMMY.stp x 4
DC15_A01_CASE_F_DUMMY.stp x 4
DC15_A01_CASE_B_DUMMY.stp x 4
DC15_A01_HORN_DUMMY.stp x 4
DC15_A01_LED_CAP2_DUMMY.stp x 4
PHS_1_7X20_5_DC10.stp x 16
BTS2_M2_6X8.stp x 4
B3B-EH.stp x 8
g2-1m25t直齿轮（驱动轮） x 2
g3-1m25t直齿轮（从动轮）
f8-mcp十字轴
g1-1m25t直齿轮+1m18t锥齿轮 x 2
g4-1m18t锥齿轮(驱动轮)
g5-1m18t锥齿轮(从动轮)
f3_tactile
f4_tactile
f5_tactile
f6_tactile
tactile_板子
f7_tactile
手指带摄像头左_倾斜扩大
手指带摄像头右_倾斜扩大改
f5盖子
P2-1-DC15_A01_IDLE_CAP_DUMMY
P1-从动销
tactile x 3
摄像头-改走线^手指带摄像头-tactile
