David0412-sun/Rapidhand/RAPID-Hand-main/RapidHandHardware/mechanical_structure/3D Printed Parts/palm/PALM_URDF.SLDASM

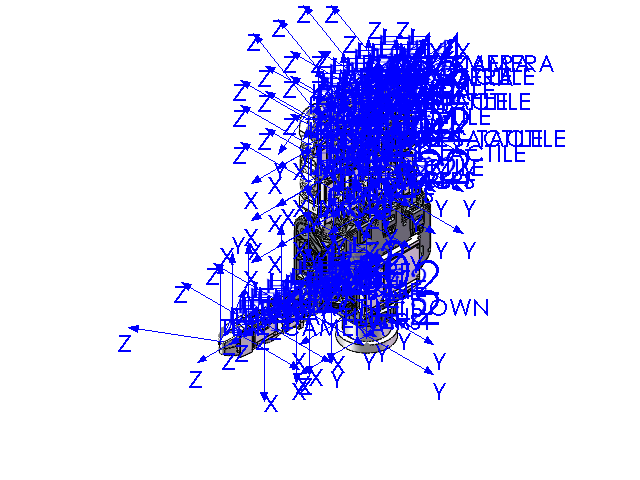
[picture p126: CAD file, 2026-09-09]
RAPID-Hand-main/RapidHandHardware/mechanical_structure/3D Printed Parts/palm/PALM_URDF.SLDASM
h1-手背-改
H2-手掌
H3-掌侧外壳
H4-关节保护内 x 2
H5-关节保护左
H6-关节保护右里 x 2
H7-手部连接件-快拆
f9-食指底座.step x 4
t12-拇指底座
H9-板子支架-mesh
电路板
拇指带摄像头右-倾斜扩大改
tactile x 15
XL,XC-330 x 10
拇指带摄像头左
拇指摄像头-改走线
t10-拇指指骨构件上
t11-tmcp十字轴
t9-拇指指骨构件下
t7-拇指旋转件
t5-拇指掌骨构件左
t6-拇指掌骨构件右
t8-1竖直锥齿轮
15X24X5_Bearing
t8-2齿轮固定环
P1-从动销 x 10
t3_tactile-镜像
t4_tactile_mirrored
f3_tactile x 4
f4_tactile x 4
f8-mcp十字轴 x 4
手指带摄像头右_倾斜扩大改 x 4
手指带摄像头左_倾斜扩大 x 4
摄像头-改走线 x 4
f5_tactile x 4
f6_tactile x 4
f7_tactile x 4
tactile_板子 x 4
f5盖子 x 4
wrist
