David0412-sun/Rapidhand/RAPID-Hand-main/RapidHandHardware/mechanical_structure/3D Printed Parts/palm/BASE.SLDASM

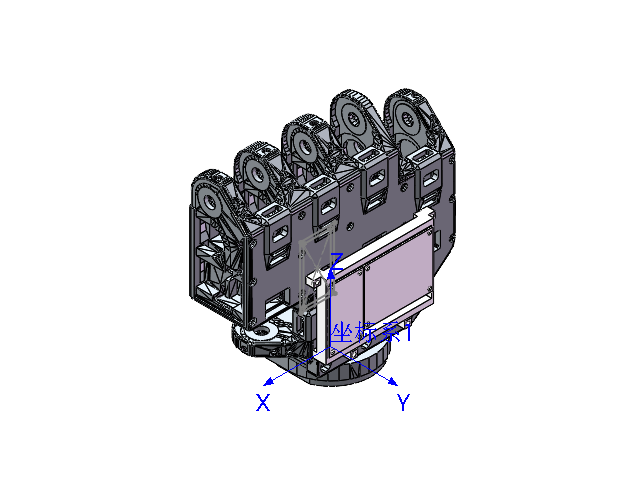
[picture p127: CAD file, 2026-09-09]
RAPID-Hand-main/RapidHandHardware/mechanical_structure/3D Printed Parts/palm/BASE.SLDASM
h1-手背-改
H2-手掌
H3-掌侧外壳
H4-关节保护内 x 2
H5-关节保护左
H6-关节保护右里 x 2
H7-手部连接件-快拆
f9-食指底座.step x 4
t12-拇指底座
H9-板子支架-mesh
电路板
