David0412-sun/Rapidhand/RAPID-Hand-main/RapidHandHardware/mechanical_structure/Model/手掌连接件.SLDASM

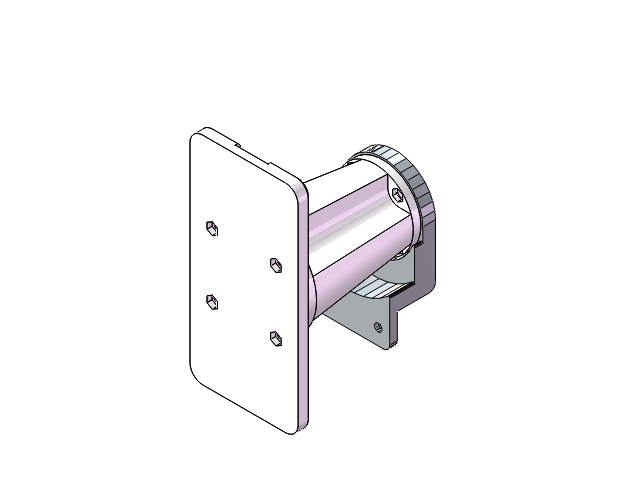
[picture p128: CAD file, 2026-05-18]
RAPID-Hand-main/RapidHandHardware/mechanical_structure/Model/手掌连接件.SLDASM
h7-手部连接件内
手支架
零件1
