David0412-sun/Rapidhand/RAPID-Hand-main/RapidHandHardware/mechanical_structure/3D Printed Parts/finger/手指带摄像头_倾斜扩大.SLDASM

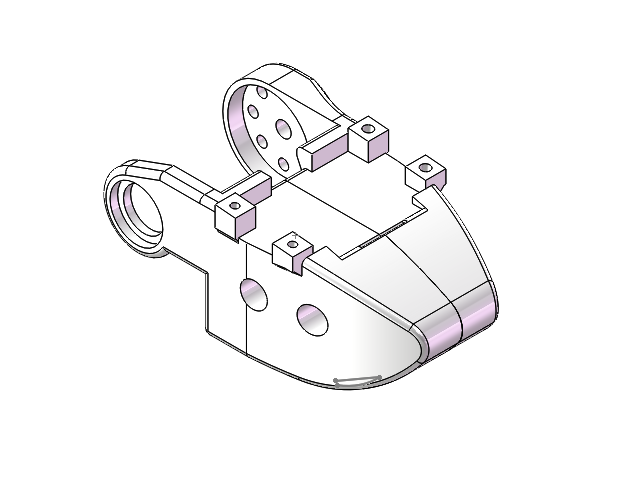
[picture p129: CAD file, 2026-05-18]
RAPID-Hand-main/RapidHandHardware/mechanical_structure/3D Printed Parts/finger/手指带摄像头_倾斜扩大.SLDASM
手指带摄像头右_倾斜扩大改
手指带摄像头左_倾斜扩大
