David0412-sun/Rapidhand/RAPID-Hand-main/RapidHandHardware/mechanical_structure/3D Printed Parts/thumb/t4_tactile_mirror.SLDASM

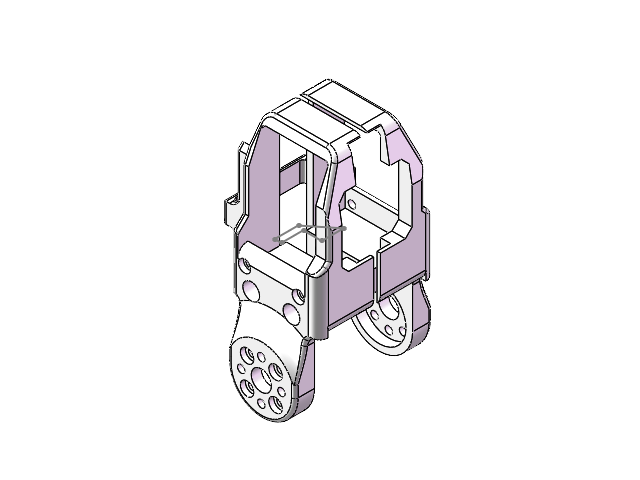
[picture p130: CAD file, 2026-05-18]
RAPID-Hand-main/RapidHandHardware/mechanical_structure/3D Printed Parts/thumb/t4_tactile_mirror.SLDASM
t4_tactile
Mirrort4_tactile
