David0412-sun/Rapidhand/RAPID-Hand-main/RapidHandHardware/mechanical_structure/rss_design/palm_asm/拇指带摄像头.SLDASM

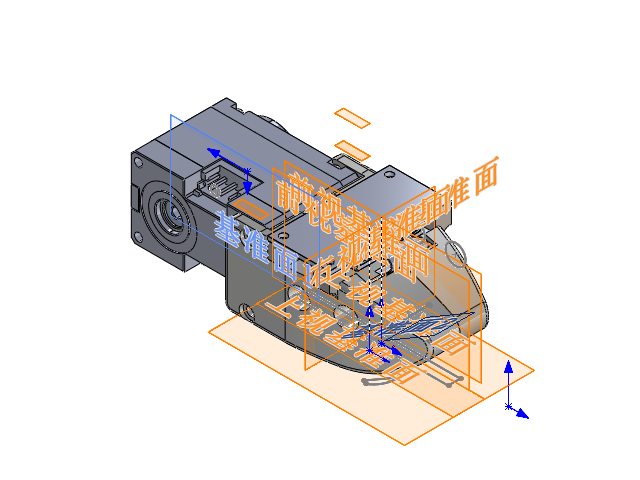
[picture p131: CAD file, 2026-05-18]
RAPID-Hand-main/RapidHandHardware/mechanical_structure/rss_design/palm_asm/拇指带摄像头.SLDASM
拇指带摄像头右改
拇指带摄像头左
camera
XL,XC-330
