David0412-sun/Rapidhand/RAPID-Hand-main/RapidHandHardware/mechanical_structure/3D Printed Parts/palm/手掌装配.SLDASM

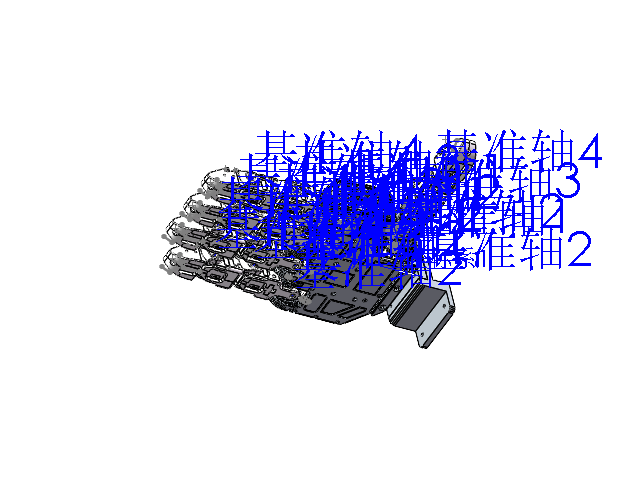
[picture p132: CAD file, 2026-05-18]
RAPID-Hand-main/RapidHandHardware/mechanical_structure/3D Printed Parts/palm/手掌装配.SLDASM
H9-板子支架
h1-手背-改
H7-手部连接件-快拆
H7-2-手部连接件-快拆-realsense底座
f9-食指底座.step x 4
DC15_A01_CASE_M_DUMMY.stp x 20
DC15_A01_CASE_F_DUMMY.stp x 20
DC15_A01_CASE_B_DUMMY.stp x 20
DC15_A01_HORN_DUMMY.stp x 20
DC15_A01_LED_CAP2_DUMMY.stp x 20
PHS_1_7X20_5_DC10.stp x 80
BTS2_M2_6X8.stp x 20
B3B-EH.stp x 40
g2-1m25t直齿轮（驱动轮） x 10
g3-1m25t直齿轮（从动轮） x 5
f8-mcp十字轴 x 4
g1-1m25t直齿轮+1m18t锥齿轮 x 10
g4-1m18t锥齿轮(驱动轮) x 4
g5-1m18t锥齿轮(从动轮) x 4
f3_tactile x 4
f4_tactile x 4
f5_tactile x 4
f6_tactile x 4
tactile_板子 x 5
f7_tactile x 4
手指带摄像头左_倾斜扩大 x 4
手指带摄像头右_倾斜扩大改 x 4
f5盖子 x 4
P2-1-DC15_A01_IDLE_CAP_DUMMY x 4
P1-从动销 x 4
H3-掌侧外壳
t12-拇指底座
t11-tmcp十字轴
t10-拇指指骨构件上
t9-拇指指骨构件下
t8-1竖直锥齿轮
t8-2齿轮固定环
t7-拇指旋转件
15X24X5_Bearing
t6-拇指掌骨构件右
t5-拇指掌骨构件左
拇指带摄像头左
t4_tactile_mirrored
拇指带摄像头右-倾斜扩大改
t3_tactile-镜像
H2-手掌
H4-关节保护内 x 2
H5-关节保护左
H6-关节保护右里 x 2
