David0412-sun/Rapidhand/RAPID-Hand-main/RapidHandHardware/mechanical_structure/3D Printed Parts/thumb/t3_tactile_mirror.SLDASM

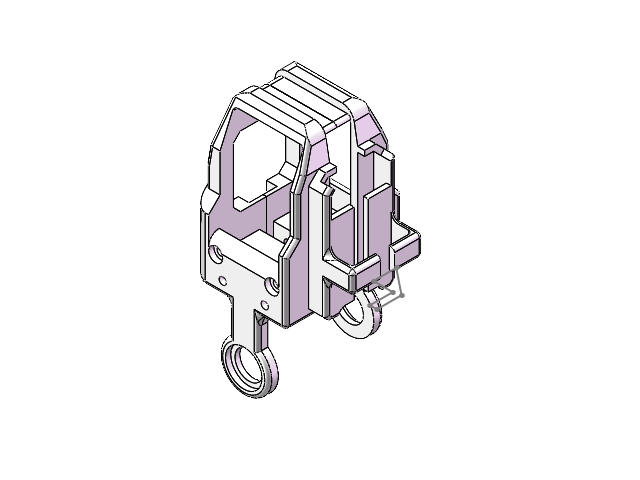
[picture p133: CAD file, 2026-05-18]
RAPID-Hand-main/RapidHandHardware/mechanical_structure/3D Printed Parts/thumb/t3_tactile_mirror.SLDASM
t3_tactile
Mirrort3_tactile
