David0412-sun/Rapidhand/RAPID-Hand-main/RapidHandHardware/mechanical_structure/rss_design/palm_asm/手掌装配-1.SLDASM

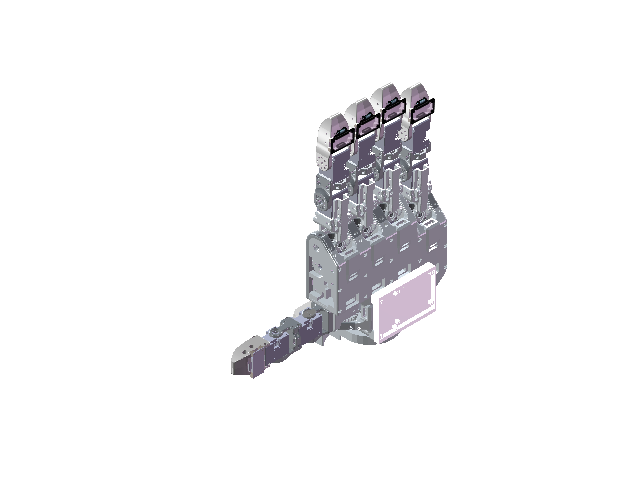
[picture p134: CAD file, 2026-05-18]
RAPID-Hand-main/RapidHandHardware/mechanical_structure/rss_design/palm_asm/手掌装配-1.SLDASM
h1-手背
f9-Fingerbase x 4
DC15_A01_CASE_M_DUMMY.stp_1.STEP x 8
DC15_A01_CASE_F_DUMMY.stp_1.STEP x 8
DC15_A01_CASE_B_DUMMY.stp_1.STEP x 8
DC15_A01_HORN_DUMMY.stp_1.STEP x 8
DC15_A01_LED_CAP2_DUMMY.stp_1.STEP x 8
PHS_1_7X20_5_DC10.stp_1.STEP x 32
BTS2_M2_6X8.stp_1.STEP x 8
B3B-EH.stp_1.STEP x 16
g2-1m25t直齿轮（驱动轮） x 5
g3-从动直齿轮 x 5
g1-1m25t直齿轮+1m18t锥齿轮 x 10
f8-mcp x 4
f5 x 4
g5-1m18t锥齿轮(从动轮) x 4
g4-1m18t锥齿轮(驱动轮) x 4
f6 x 4
XL,XC-330 x 12
f7-近指结盖板 x 4
f3 x 4
f2-CamTipL x 4
f4 x 4
f1-CamtipR x 4
camera x 5
h7-手部连接件内
h8-手部连接件外
h2-手掌
板子支架
t12-拇指底座
t11-tmcp十字轴
t10-拇指指骨构件上
t9-拇指指骨构件下
t7-拇指旋转件
t8-1竖直锥齿轮
t8-2齿轮固定环
t5-拇指掌骨构件左
t6-拇指掌骨构件右
t3-拇指连接件左
t4-拇指连接件右
拇指带摄像头右改
拇指带摄像头左
RealSense_D435
h3-掌侧外壳
h4-关节保护内 x 2
h5-关节保护左
h6-关节保护右里 x 2
