David0412-sun/Rapidhand/RAPID-Hand-main/RapidHandHardware/mechanical_structure/rss_design/palm_asm/手指装配.SLDASM

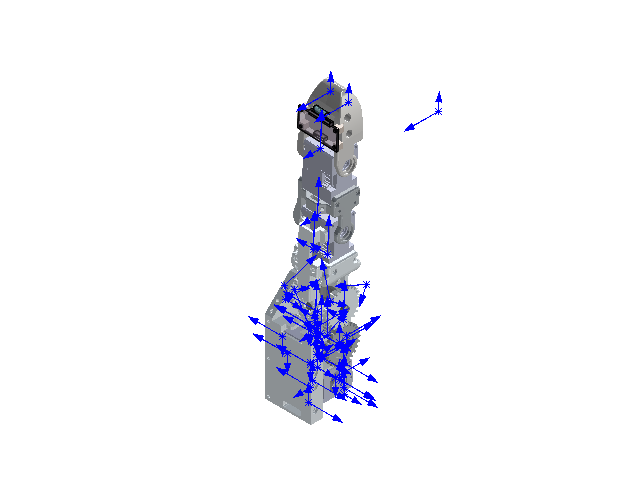
[picture p135: CAD file, 2026-05-18]
RAPID-Hand-main/RapidHandHardware/mechanical_structure/rss_design/palm_asm/手指装配.SLDASM
f9-Fingerbase
DC15_A01_CASE_M_DUMMY.stp_1.STEP x 2
DC15_A01_CASE_F_DUMMY.stp_1.STEP x 2
DC15_A01_CASE_B_DUMMY.stp_1.STEP x 2
DC15_A01_HORN_DUMMY.stp_1.STEP x 2
DC15_A01_LED_CAP2_DUMMY.stp_1.STEP x 2
PHS_1_7X20_5_DC10.stp_1.STEP x 8
BTS2_M2_6X8.stp_1.STEP x 2
B3B-EH.stp_1.STEP x 4
g2-1m25t直齿轮（驱动轮）
g3-从动直齿轮
g1-1m25t直齿轮+1m18t锥齿轮 x 2
f8-mcp
f5
g5-1m18t锥齿轮(从动轮)
g4-1m18t锥齿轮(驱动轮)
f6
XL,XC-330 x 2
f7-近指结盖板
f3
f2-CamTipL
f4
f1-CamtipR
camera
