David0412-sun/Rapidhand/RAPID-Hand-main/RapidHandHardware/mechanical_structure/3D Printed Parts/thumb/TMCPF.SLDASM

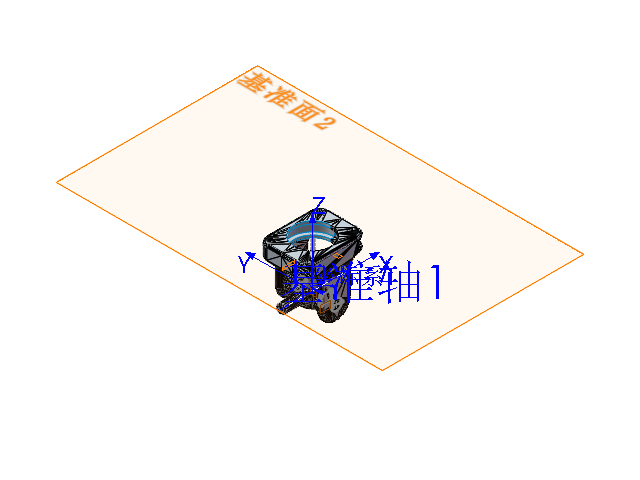
[picture p136: CAD file, 2026-05-18]
RAPID-Hand-main/RapidHandHardware/mechanical_structure/3D Printed Parts/thumb/TMCPF.SLDASM
t10-拇指指骨构件上
t11-tmcp十字轴
t9-拇指指骨构件下
