David0412-sun/Rapidhand/RAPID-Hand-main/RapidHandHardware/mechanical_structure/3D Printed Parts/finger/手指带摄像头.SLDASM

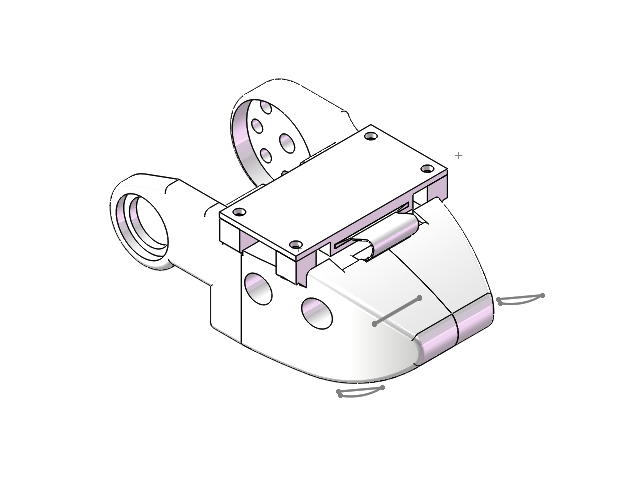
[picture p137: CAD file, 2026-05-18]
RAPID-Hand-main/RapidHandHardware/mechanical_structure/3D Printed Parts/finger/手指带摄像头.SLDASM
手指带摄像头右
零件1
