David0412-sun/Rapidhand/RAPID-Hand-main/RapidHandHardware/mechanical_structure/3D Printed Parts/thumb/拇指装配.SLDASM

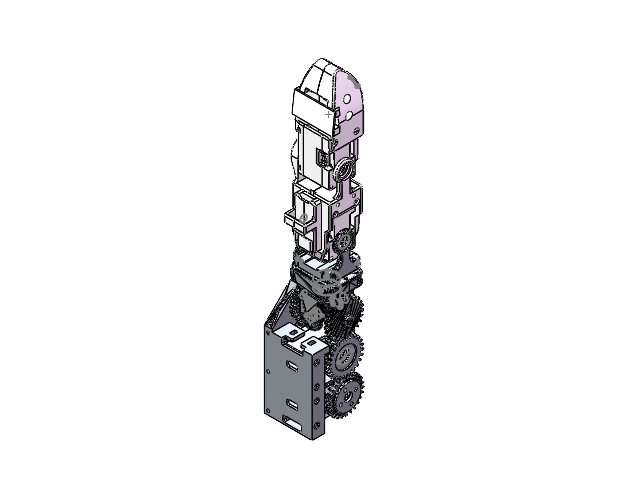
[picture p138: CAD file, 2026-05-18]
RAPID-Hand-main/RapidHandHardware/mechanical_structure/3D Printed Parts/thumb/拇指装配.SLDASM
t12-拇指底座
DC15_A01_CASE_M_DUMMY.stp x 4
DC15_A01_CASE_F_DUMMY.stp x 4
DC15_A01_CASE_B_DUMMY.stp x 4
DC15_A01_HORN_DUMMY.stp x 4
DC15_A01_LED_CAP2_DUMMY.stp x 4
PHS_1_7X20_5_DC10.stp x 16
BTS2_M2_6X8.stp x 4
B3B-EH.stp x 8
g2-1m25t直齿轮（驱动轮） x 2
g3-1m25t直齿轮（从动轮）
t11-tmcp十字轴
g1-1m25t直齿轮+1m18t锥齿轮 x 2
t10-拇指指骨构件上
t9-拇指指骨构件下
t8-1竖直锥齿轮
t8-2齿轮固定环
t7-拇指旋转件
15X24X5_Bearing
t6-拇指掌骨构件右
t5-拇指掌骨构件左
拇指带摄像头左
t4_tactile_mirrored
拇指带摄像头右-倾斜扩大改
t3_tactile-镜像
tactile_板子
tactile x 3
拇指摄像头-改走线
