David0412-sun/Rapidhand/RAPID-Hand-main/RapidHandHardware/mechanical_structure/3D Printed Parts/thumb/拇指尖镜像.SLDASM

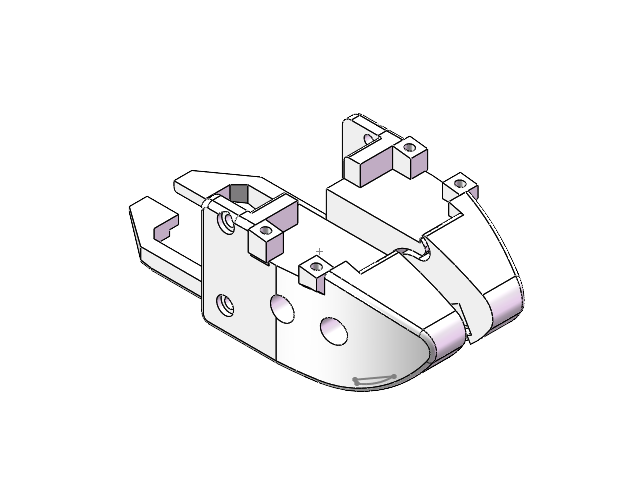
[picture p139: CAD file, 2026-05-18]
RAPID-Hand-main/RapidHandHardware/mechanical_structure/3D Printed Parts/thumb/拇指尖镜像.SLDASM
拇指带摄像头左
Mirror拇指带摄像头左
