David0412-sun/Rapidhand/(list of files, cad)

Other CAD files:
RAPID-Hand-main/RapidHandHardware/mechanical_structure/3D Printed Parts/3d打印文件/手掌加工2026-3/手指/f5_tactile.STEP
RAPID-Hand-main/RapidHandHardware/mechanical_structure/3D Printed Parts/3d打印文件/手掌加工2026-3/手掌/快拆件底座.STEP
RAPID-Hand-main/RapidHandHardware/mechanical_structure/3D Printed Parts/3d打印文件/手掌加工2026-3/拇指/t1-拇指带摄像头左-改.STEP
RAPID-Hand-main/RapidHandHardware/mechanical_structure/3D Printed Parts/finger/摄像头-改走线.SLDPRT
RAPID-Hand-main/RapidHandHardware/mechanical_structure/3D Printed Parts/mesh/URDF/PALM_URDF_0723_collision_featured_1.SLDASM/meshes/TDIP_TACTILE_DOWN.STL
RAPID-Hand-main/RapidHandHardware/mechanical_structure/3D Printed Parts/palm/横向支撑件.SLDPRT
RAPID-Hand-main/RapidHandHardware/mechanical_structure/FingerVIP_Mechanical_structure/Model/Finger/Finger.STEP
RAPID-Hand-main/RapidHandHardware/mechanical_structure/FingerVIP_Mechanical_structure/Model/Thumb/Thumb.STEP
RAPID-Hand-main/RapidHandHardware/mechanical_structure/Model/手支架.SLDPRT
RAPID-Hand-main/RapidHandHardware/mechanical_structure/robot side/Robot side.STEP
RAPID-Hand-main/RapidHandHardware/mechanical_structure/rss_design/finger_with_cam/p1-Idler_pin.SLDPRT
RAPID-Hand-main/RapidHandHardware/mechanical_structure/rss_design/palm_asm/T6-拇指掌骨构件右.step
RAPID-Hand-main/RapidHandHardware/mechanical_structure/3D Printed Parts/3d打印文件/0318手指打印.gcode.3mf
RAPID-Hand-main/RapidHandHardware/mechanical_structure/3D Printed Parts/3d打印文件/手掌加工2026-3/手指/f4_tactile.STEP
RAPID-Hand-main/RapidHandHardware/mechanical_structure/3D Printed Parts/3d打印文件/手掌加工2026-3/手掌/H2-手掌.STEP
RAPID-Hand-main/RapidHandHardware/mechanical_structure/3D Printed Parts/3d打印文件/手掌加工2026-3/拇指/t9-拇指指骨构件下.STEP
RAPID-Hand-main/RapidHandHardware/mechanical_structure/3D Printed Parts/3d打印文件/手掌加工2026-3/机械件/P1-从动销.STEP
RAPID-Hand-main/RapidHandHardware/mechanical_structure/3D Printed Parts/finger/tactile.SLDPRT
RAPID-Hand-main/RapidHandHardware/mechanical_structure/3D Printed Parts/mesh/URDF/PALM_URDF_0723_collision_featured.SLDASM/meshes/TDIP_TACTILE_DOWN.STL
RAPID-Hand-main/RapidHandHardware/mechanical_structure/3D Printed Parts/palm/H7-手部连接件-快拆.SLDPRT
RAPID-Hand-main/RapidHandHardware/mechanical_structure/3D Printed Parts/thumb/拇指摄像头-改走线.SLDPRT
RAPID-Hand-main/RapidHandHardware/RapidTeleop/assets/robots/hands/leap_hand/meshes/collision/white_tip.obj
RAPID-Hand-main/RapidHandHardware/RapidTeleop/assets/robots/hands/rapid_hand/meshes/MPIP.STL
RAPID-Hand-main/RapidHandHardware/mechanical_structure/3D Printed Parts/3d打印文件/0318手指tactile打印.gcode.3mf
RAPID-Hand-main/RapidHandHardware/mechanical_structure/3D Printed Parts/3d打印文件/手掌加工2026-3/手指/f6_tactile.STEP
RAPID-Hand-main/RapidHandHardware/mechanical_structure/3D Printed Parts/3d打印文件/手掌加工2026-3/手掌/H8-手部连接件外-原本.STEP
RAPID-Hand-main/RapidHandHardware/mechanical_structure/3D Printed Parts/3d打印文件/手掌加工2026-3/机械件/P2-1-DC15_A01_IDLE_CAP_DUMMY.STEP
RAPID-Hand-main/RapidHandHardware/mechanical_structure/3D Printed Parts/mesh/URDF/PALM_URDF_0723_collision_featured.SLDASM/meshes/RPIP.STL
RAPID-Hand-main/RapidHandHardware/mechanical_structure/3D Printed Parts/mesh/URDF/PALM_URDF_0723_collision_featured_2.SLDASM/meshes/LDIP_TACTILE.STL
RAPID-Hand-main/RapidHandHardware/mechanical_structure/3D Printed Parts/mesh/URDF/PALM_URDF_0724_collision_featured_4.SLDASM/meshes/LDIP_CAMERA.STL
RAPID-Hand-main/RapidHandHardware/mechanical_structure/3D Printed Parts/机械件/G5-1M18T锥齿轮(从动轮).step
RAPID-Hand-main/RapidHandHardware/mechanical_structure/Model/rapidhand.STEP
RAPID-Hand-main/RapidHandHardware/mechanical_structure/rss_design/finger_with_cam/f1-CamtipR.SLDPRT
RAPID-Hand-main/RapidHandHardware/mechanical_structure/rss_design/palm_asm/f5.SLDPRT
RAPID-Hand-main/RapidHandHardware/mechanical_structure/rss_design/thumb_with_cam/camera.SLDPRT
RAPID-Hand-main/RapidHandHardware/mechanical_structure/3D Printed Parts/3d打印文件/0831.gcode.3mf
RAPID-Hand-main/RapidHandHardware/mechanical_structure/3D Printed Parts/3d打印文件/手掌加工2026-3/手指/f1-手指带摄像头左_倾斜扩大.STEP
RAPID-Hand-main/RapidHandHardware/mechanical_structure/3D Printed Parts/3d打印文件/手掌加工2026-3/手掌/H9-板子支架.STEP
RAPID-Hand-main/RapidHandHardware/mechanical_structure/3D Printed Parts/3d打印文件/手掌加工2026-3/机械件/g1-1m25t直齿轮+1m18t锥齿轮.STEP
RAPID-Hand-main/RapidHandHardware/mechanical_structure/3D Printed Parts/mesh/URDF/PALM_URDF_0724_collision_featured_4.SLDASM/meshes/TDIP_TACTILE_DOWN.STL
RAPID-Hand-main/RapidHandHardware/mechanical_structure/3D Printed Parts/palm/wrist.SLDPRT
RAPID-Hand-main/RapidHandHardware/mechanical_structure/3D Printed Parts/机械件/P2-1-DC15_A01_IDLE_CAP_DUMMY-原本.SLDPRT
RAPID-Hand-main/RapidHandHardware/mechanical_structure/Model/h8-手部连接件外.SLDPRT
RAPID-Hand-main/RapidHandHardware/mechanical_structure/rss_design/palm_asm/F9-食指底座.step
RAPID-Hand-main/RapidHandHardware/mechanical_structure/rss_design/thumb_with_cam/拇指带摄像头右改.SLDPRT
RAPID-Hand-main/RapidHandHardware/RapidTeleop/assets/robots/arms/ur10e/meshes/collision/base.obj
RAPID-Hand-main/RapidHandHardware/mechanical_structure/3D Printed Parts/3d打印文件/手指tactile打印楼下.gcode.3mf
RAPID-Hand-main/RapidHandHardware/mechanical_structure/3D Printed Parts/3d打印文件/手掌加工2026-3/手指/f6_tactile_改.STEP
RAPID-Hand-main/RapidHandHardware/mechanical_structure/3D Printed Parts/3d打印文件/手掌加工2026-3/手掌/H7-realsense底座-原本.STEP
RAPID-Hand-main/RapidHandHardware/mechanical_structure/3D Printed Parts/3d打印文件/手掌加工2026-3/拇指/t3_tactile_加板.STEP
RAPID-Hand-main/RapidHandHardware/mechanical_structure/3D Printed Parts/3d打印文件/手掌加工2026-3/机械件/P2-2-DC15_A01_IDLE_CAP_DUMMY-原本.STEP
RAPID-Hand-main/RapidHandHardware/mechanical_structure/3D Printed Parts/mesh/URDF/PALM_URDF_0723_collision_featured.SLDASM/meshes/LMCPS.STL
RAPID-Hand-main/RapidHandHardware/mechanical_structure/3D Printed Parts/mesh/URDF/PALM_URDF_0724_collision_featured_4.SLDASM/meshes/TDIP_CAMERA.STL
RAPID-Hand-main/RapidHandHardware/mechanical_structure/3D Printed Parts/palm/XL,XC-330.SLDPRT
RAPID-Hand-main/RapidHandHardware/mechanical_structure/3D Printed Parts/thumb/拇指带摄像头左.SLDPRT
RAPID-Hand-main/RapidHandHardware/mechanical_structure/3D Printed Parts/机械件/G2-1M25T直齿轮（驱动轮）.step
RAPID-Hand-main/RapidHandHardware/mechanical_structure/Model/零件1.SLDPRT
RAPID-Hand-main/RapidHandHardware/mechanical_structure/rss_design/finger_with_cam/camera.STEP
RAPID-Hand-main/RapidHandHardware/mechanical_structure/rss_design/palm_asm/拇指带摄像头左.SLDPRT
RAPID-Hand-main/RapidHandHardware/RapidTeleop/assets/robots/arms/ur10e/meshes/collision/wrist1.obj
RAPID-Hand-main/RapidHandHardware/RapidTeleop/assets/robots/arms/ur10e/meshes/collision/wrist2.obj
RAPID-Hand-main/RapidHandHardware/RapidTeleop/assets/robots/arms/ur10e/meshes/collision/wrist3.obj
RAPID-Hand-main/RapidHandHardware/RapidTeleop/assets/robots/arms/ur10e/meshes/visual/shoulder.obj
RAPID-Hand-main/RapidHandHardware/RapidTeleop/assets/robots/arms/ur10e/meshes/visual/upperarm.obj
RAPID-Hand-main/RapidHandHardware/RapidTeleop/assets/robots/arms/ur10e/meshes/visual/wrist1.obj
RAPID-Hand-main/RapidHandHardware/RapidTeleop/assets/robots/arms/ur5e/meshes/collision/base.obj
RAPID-Hand-main/RapidHandHardware/RapidTeleop/assets/robots/arms/ur5e/meshes/collision/shoulder.obj
RAPID-Hand-main/RapidHandHardware/RapidTeleop/assets/robots/arms/ur5e/meshes/collision/upperarm.obj
RAPID-Hand-main/RapidHandHardware/RapidTeleop/assets/robots/arms/ur5e/meshes/visual/shoulder.obj
RAPID-Hand-main/RapidHandHardware/RapidTeleop/assets/robots/arms/ur5e/meshes/visual/wrist1.obj
RAPID-Hand-main/RapidHandHardware/RapidTeleop/assets/robots/arms/ur5e/meshes/visual/wrist3.obj
RAPID-Hand-main/RapidHandHardware/RapidTeleop/assets/robots/hands/allegro_hand/meshes/visual/base_link.obj
RAPID-Hand-main/RapidHandHardware/RapidTeleop/assets/robots/hands/allegro_hand/meshes/visual/link_0.0.obj
RAPID-Hand-main/RapidHandHardware/RapidTeleop/assets/robots/hands/allegro_hand/meshes/visual/link_12.0_left.obj
RAPID-Hand-main/RapidHandHardware/RapidTeleop/assets/robots/hands/allegro_hand/meshes/visual/link_12.0_right.obj
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
