David0412-sun/Rapidhand/tmp/thumb_assembled_latest.png

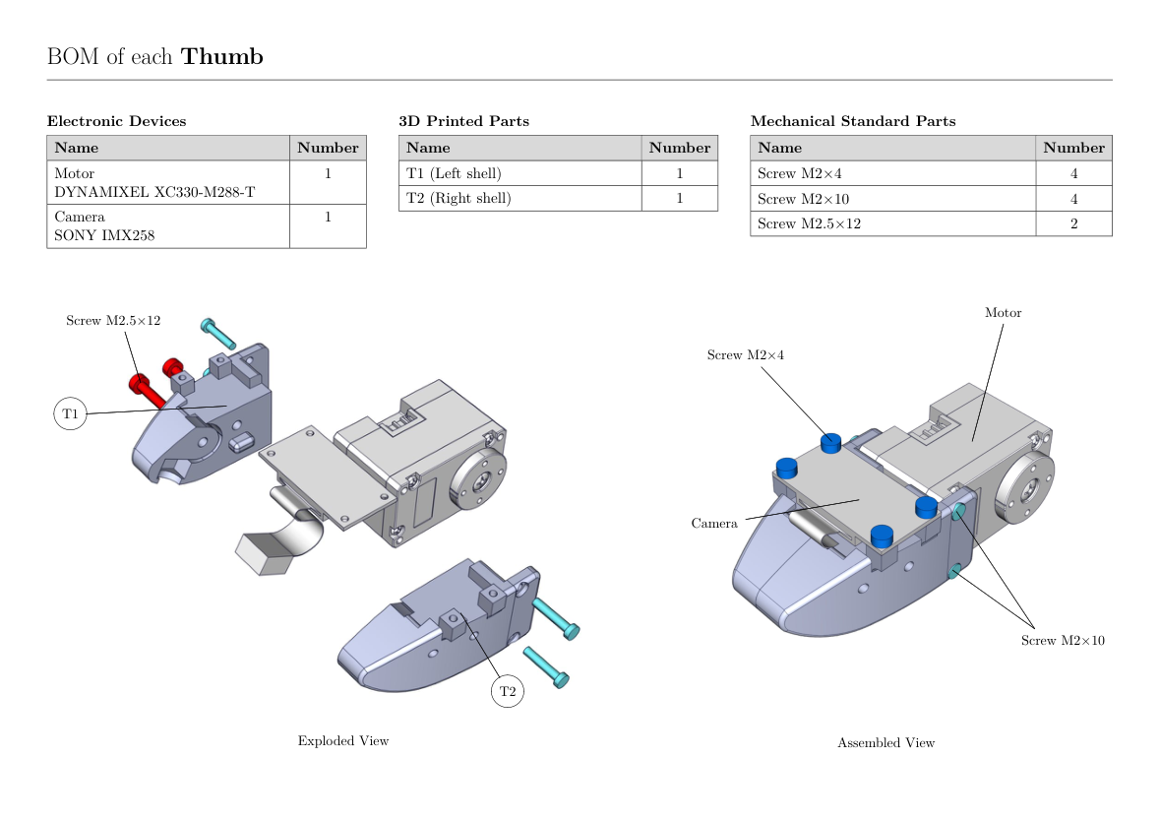
tmp/thumb_assembled_latest.png
