David0412-sun/Rapidhand/tmp/zip_verify_path.txt

E:\cu_projects\Rapidhand\tmp\zip_verify_529f006681a540f498d839003ec03326\RapidHand_camera_BOM_assembly_guide
