David0412-sun/Rapidhand/RAPID-Hand-main/RapidHandHardware/mechanical_structure/3D Printed Parts/mesh/URDF/PALM_URDF.SLDASM/urdf/PALM_URDF.SLDASM.urdf

<?xml version="1.0" encoding="utf-8"?>
<!-- This URDF was automatically created by SolidWorks to URDF Exporter! Originally created by Stephen Brawner (brawner@gmail.com) 
     Commit Version: 1.6.0-4-g7f85cfe  Build Version: 1.6.7995.38578
     For more information, please see http://wiki.ros.org/sw_urdf_exporter -->
<robot name="PALM_URDF.SLDASM">
  <link name="BASE">
    <inertial>
      <origin xyz="0.00096535 0.0018835 0.059248" rpy="0 0 0" />
      <mass value="0.36616" />
      <inertia ixx="0.00026014" ixy="-2.8445E-06" ixz="-3.9515E-05" iyy="0.00049763" iyz="-1.3878E-06" izz="0.00033928" />
    </inertial>
    <visual>
      <origin xyz="0 0 0" rpy="0 0 0" />
      <geometry>
        <mesh filename="package://PALM_URDF.SLDASM/meshes/BASE.STL" />
      </geometry>
      <material name="">
        <color rgba="0.75294 0.75294 0.75294 1" />
      </material>
    </visual>
    <collision>
      <origin xyz="0 0 0" rpy="0 0 0" />
      <geometry>
        <mesh filename="package://PALM_URDF.SLDASM/meshes/BASE.STL" />
      </geometry>
    </collision>
  </link>
  <link name="TMCPF">
    <inertial>
      <origin xyz="-8.94485140175844E-08 -0.00651772632754088 0.00979641891039251" rpy="0 0 0" />
      <mass value="0.00403111186793774" />
      <inertia ixx="3.51226821493148E-07" ixy="5.13601613299572E-13" ixz="-3.55839429697947E-12" iyy="5.76592866072564E-07" iyz="-3.46269775245642E-08" izz="3.57954487924098E-07" />
    </inertial>
    <visual>
      <origin xyz="0 0 0" rpy="0 0 0" />
      <geometry>
        <mesh filename="package://PALM_URDF.SLDASM/meshes/TMCPF.STL" />
      </geometry>
      <material name="">
        <color rgba="0.752941176470588 0.752941176470588 0.752941176470588 1" />
      </material>
    </visual>
    <collision>
      <origin xyz="0 0 0" rpy="0 0 0" />
      <geometry>
        <mesh filename="package://PALM_URDF.SLDASM/meshes/TMCPF.STL" />
      </geometry>
    </collision>
  </link>
  <joint name="TF" type="revolute">
    <origin xyz="0.044 -0.0075 0.043" rpy="0 1.5708 0" />
    <parent link="BASE" />
    <child link="TMCPF" />
    <axis xyz="-1 0 0" />
    <limit lower="0" upper="0" effort="0" velocity="0" />
  </joint>
  <link name="TMCPS">
    <inertial>
      <origin xyz="0.00103849116596672 -1.64329802196383E-07 -0.00331551855469359" rpy="0 0 0" />
      <mass value="0.0106268686560954" />
      <inertia ixx="7.55169051256462E-07" ixy="6.05082919324868E-13" ixz="-2.4010713387721E-08" iyy="5.98746618835006E-07" iyz="6.62863494730563E-12" izz="6.08350308334754E-07" />
    </inertial>
    <visual>
      <origin xyz="0 0 0" rpy="0 0 0" />
      <geometry>
        <mesh filename="package://PALM_URDF.SLDASM/meshes/TMCPS.STL" />
      </geometry>
      <material name="">
        <color rgba="0.752941176470588 0.752941176470588 0.752941176470588 1" />
      </material>
    </visual>
    <collision>
      <origin xyz="0 0 0" rpy="0 0 0" />
      <geometry>
        <mesh filename="package://PALM_URDF.SLDASM/meshes/TMCPS.STL" />
      </geometry>
    </collision>
  </link>
  <joint name="TS" type="revolute">
    <origin xyz="0 0 0.03085" rpy="0 0 0" />
    <parent link="TMCPF" />
    <child link="TMCPS" />
    <axis xyz="0 0 -1" />
    <limit lower="0" upper="0" effort="0" velocity="0" />
  </joint>
  <link name="TPIP">
    <inertial>
      <origin xyz="0.000864181716214022 0.000343885411216688 0.0141246010245415" rpy="0 0 0" />
      <mass value="0.0273995580848551" />
      <inertia ixx="5.51734130747595E-06" ixy="6.92817306498706E-09" ixz="-1.54059086928342E-07" iyy="4.42571415652065E-06" iyz="1.25541646027666E-07" izz="1.96525275886189E-06" />
    </inertial>
    <visual>
      <origin xyz="0 0 0" rpy="0 0 0" />
      <geometry>
        <mesh filename="package://PALM_URDF.SLDASM/meshes/TPIP.STL" />
      </geometry>
      <material name="">
        <color rgba="1 1 1 1" />
      </material>
    </visual>
    <collision>
      <origin xyz="0 0 0" rpy="0 0 0" />
      <geometry>
        <mesh filename="package://PALM_URDF.SLDASM/meshes/TPIP.STL" />
      </geometry>
    </collision>
  </link>
  <joint name="TP" type="revolute">
    <origin xyz="0 0 0.0185" rpy="0 0 0" />
    <parent link="TMCPS" />
    <child link="TPIP" />
    <axis xyz="-1 0 0" />
    <limit lower="0" upper="0" effort="0" velocity="0" />
  </joint>
  <link name="TDIP">
    <inertial>
      <origin xyz="0.000464044672430098 -0.0017281161416846 0.0229026766445721" rpy="0 0 0" />
      <mass value="0.0325641944561403" />
      <inertia ixx="5.20917273038169E-06" ixy="3.0876649601376E-09" ixz="3.64989100277285E-09" iyy="4.61090436972906E-06" iyz="-2.6183151051951E-07" izz="1.5441035843723E-06" />
    </inertial>
    <visual>
      <origin xyz="0 0 0" rpy="0 0 0" />
      <geometry>
        <mesh filename="package://PALM_URDF.SLDASM/meshes/TDIP.STL" />
      </geometry>
      <material name="">
        <color rgba="1 1 1 1" />
      </material>
    </visual>
    <collision>
      <origin xyz="0 0 0" rpy="0 0 0" />
      <geometry>
        <mesh filename="package://PALM_URDF.SLDASM/meshes/TDIP.STL" />
      </geometry>
    </collision>
  </link>
  <joint name="TD" type="revolute">
    <origin xyz="0 0 0.0465" rpy="0.0091796 0 0" />
    <parent link="TPIP" />
    <child link="TDIP" />
    <axis xyz="-1 0 0" />
    <limit lower="0" upper="0" effort="0" velocity="0" />
  </joint>
  <link name="TDIP_TACTILE_DOWN">
    <inertial>
      <origin xyz="1.30104260698261E-16 0 -0.00249999999999997" rpy="0 0 0" />
      <mass value="0.00146" />
      <inertia ixx="4.95483333333334E-08" ixy="2.90359158539598E-23" ixz="5.55715796254778E-24" iyy="2.929E-08" iyz="-3.69344866215767E-24" izz="7.27550000000001E-08" />
    </inertial>
    <visual>
      <origin xyz="0 0 0" rpy="0 0 0" />
      <geometry>
        <mesh filename="package://PALM_URDF.SLDASM/meshes/TDIP_TACTILE_DOWN.STL" />
      </geometry>
      <material name="">
        <color rgba="1 1 1 1" />
      </material>
    </visual>
    <collision>
      <origin xyz="0 0 0" rpy="0 0 0" />
      <geometry>
        <mesh filename="package://PALM_URDF.SLDASM/meshes/TDIP_TACTILE_DOWN.STL" />
      </geometry>
    </collision>
  </link>
  <joint name="TD_TD" type="fixed">
    <origin xyz="0.0001 -0.015137 0.0076551" rpy="1.5616 0 0" />
    <parent link="TDIP" />
    <child link="TDIP_TACTILE_DOWN" />
    <axis xyz="0 0 0" />
  </joint>
  <link name="TDIP_TACTILE_UP">
    <inertial>
      <origin xyz="1.47451495458029E-16 2.22044604925031E-16 -0.0025" rpy="0 0 0" />
      <mass value="0.00146" />
      <inertia ixx="4.95483333333336E-08" ixy="3.83224655724443E-23" ixz="9.88393007284594E-25" iyy="2.92900000000001E-08" iyz="3.69629091429138E-25" izz="7.27550000000003E-08" />
    </inertial>
    <visual>
      <origin xyz="0 0 0" rpy="0 0 0" />
      <geometry>
        <mesh filename="package://PALM_URDF.SLDASM/meshes/TDIP_TACTILE_UP.STL" />
      </geometry>
      <material name="">
        <color rgba="1 1 1 1" />
      </material>
    </visual>
    <collision>
      <origin xyz="0 0 0" rpy="0 0 0" />
      <geometry>
        <mesh filename="package://PALM_URDF.SLDASM/meshes/TDIP_TACTILE_UP.STL" />
      </geometry>
    </collision>
  </link>
  <joint name="TD_UP" type="fixed">
    <origin xyz="0.0001 -0.014923 0.030998" rpy="1.5616 0 0" />
    <parent link="TDIP" />
    <child link="TDIP_TACTILE_UP" />
    <axis xyz="0 0 0" />
  </joint>
  <link name="TDIP_CAMERA">
    <inertial>
      <origin xyz="-2.67746700503384E-05 -0.00308600031104966 -0.0151496387593847" rpy="0 0 0" />
      <mass value="0.000865724954084934" />
      <inertia ixx="1.2382360219818E-08" ixy="-9.35231094103681E-23" ixz="-6.51813478770876E-23" iyy="4.23357916729273E-08" iyz="-4.32469630376937E-09" izz="4.62079016284062E-08" />
    </inertial>
    <visual>
      <origin xyz="0 0 0" rpy="0 0 0" />
      <geometry>
        <mesh filename="package://PALM_URDF.SLDASM/meshes/TDIP_CAMERA.STL" />
      </geometry>
      <material name="">
        <color rgba="1 1 1 1" />
      </material>
    </visual>
    <collision>
      <origin xyz="0 0 0" rpy="0 0 0" />
      <geometry>
        <mesh filename="package://PALM_URDF.SLDASM/meshes/TDIP_CAMERA.STL" />
      </geometry>
    </collision>
  </link>
  <joint name="TD_C" type="fixed">
    <origin xyz="0.0001 -0.0092472 0.053682" rpy="1.038 0 0" />
    <parent link="TDIP" />
    <child link="TDIP_CAMERA" />
    <axis xyz="0 0 0" />
  </joint>
  <link name="TPIP_TACTILE">
    <inertial>
      <origin xyz="4.16333634234434E-17 0 -0.00249999999999999" rpy="0 0 0" />
      <mass value="0.00146" />
      <inertia ixx="4.95483333333334E-08" ixy="-1.76252429735308E-23" ixz="1.2376925121472E-24" iyy="2.92900000000001E-08" iyz="1.9575347483553E-24" izz="7.27550000000001E-08" />
    </inertial>
    <visual>
      <origin xyz="0 0 0" rpy="0 0 0" />
      <geometry>
        <mesh filename="package://PALM_URDF.SLDASM/meshes/TPIP_TACTILE.STL" />
      </geometry>
      <material name="">
        <color rgba="1 1 1 1" />
      </material>
    </visual>
    <collision>
      <origin xyz="0 0 0" rpy="0 0 0" />
      <geometry>
        <mesh filename="package://PALM_URDF.SLDASM/meshes/TPIP_TACTILE.STL" />
      </geometry>
    </collision>
  </link>
  <joint name="TP_T" type="fixed">
    <origin xyz="0 -0.015 0.00745" rpy="1.5708 0 0" />
    <parent link="TPIP" />
    <child link="TPIP_TACTILE" />
    <axis xyz="0 0 0" />
  </joint>
  <link name="IMCPF">
    <inertial>
      <origin xyz="-0.0452116614032196 0.00414018647035749 -0.0151752439916012" rpy="0 0 0" />
      <mass value="0.75693649766014" />
      <inertia ixx="0.00489925180496908" ixy="6.90407197223538E-05" ixz="0.000360307698469376" iyy="0.00701833859290175" iyz="0.00019418849004639" izz="0.00241622745475381" />
    </inertial>
    <visual>
      <origin xyz="0 0 0" rpy="0 0 0" />
      <geometry>
        <mesh filename="package://PALM_URDF.SLDASM/meshes/IMCPF.STL" />
      </geometry>
      <material name="">
        <color rgba="0.674509803921569 0.709803921568627 0.737254901960784 1" />
      </material>
    </visual>
    <collision>
      <origin xyz="0 0 0" rpy="0 0 0" />
      <geometry>
        <mesh filename="package://PALM_URDF.SLDASM/meshes/IMCPF.STL" />
      </geometry>
    </collision>
  </link>
  <joint name="IF" type="revolute">
    <origin xyz="0.062 -0.0075 0.13" rpy="0 0 0" />
    <parent link="BASE" />
    <child link="IMCPF" />
    <axis xyz="-1 0 0" />
    <limit lower="0" upper="0" effort="0" velocity="0" />
  </joint>
  <link name="IMCPS">
    <inertial>
      <origin xyz="0.000366352894816346 0.00136079106892852 0.036307000644315" rpy="0 0 0" />
      <mass value="0.0299795617629257" />
      <inertia ixx="4.61407270089445E-06" ixy="-8.99357979669089E-11" ixz="-2.65128538904178E-09" iyy="4.96910634776405E-06" iyz="-1.08820321097628E-08" izz="1.68786894408092E-06" />
    </inertial>
    <visual>
      <origin xyz="0 0 0" rpy="0 0 0" />
      <geometry>
        <mesh filename="package://PALM_URDF.SLDASM/meshes/IMCPS.STL" />
      </geometry>
      <material name="">
        <color rgba="1 1 1 1" />
      </material>
    </visual>
    <collision>
      <origin xyz="0 0 0" rpy="0 0 0" />
      <geometry>
        <mesh filename="package://PALM_URDF.SLDASM/meshes/IMCPS.STL" />
      </geometry>
    </collision>
  </link>
  <joint name="IS" type="revolute">
    <origin xyz="0 0 0" rpy="0 0 0" />
    <parent link="IMCPF" />
    <child link="IMCPS" />
    <axis xyz="0 1 0" />
    <limit lower="0" upper="0" effort="0" velocity="0" />
  </joint>
  <link name="IPIP">
    <inertial>
      <origin xyz="0.00088360794312492 0.000518551489527327 0.0315502125402504" rpy="0 0 0" />
      <mass value="0.027206442467989" />
      <inertia ixx="4.85051610724986E-06" ixy="1.06519728675525E-08" ixz="1.36331026032813E-07" iyy="3.78353465508138E-06" iyz="-5.4440098060443E-08" izz="1.94188295958329E-06" />
    </inertial>
    <visual>
      <origin xyz="0 0 0" rpy="0 0 0" />
      <geometry>
        <mesh filename="package://PALM_URDF.SLDASM/meshes/IPIP.STL" />
      </geometry>
      <material name="">
        <color rgba="1 1 1 1" />
      </material>
    </visual>
    <collision>
      <origin xyz="0 0 0" rpy="0 0 0" />
      <geometry>
        <mesh filename="package://PALM_URDF.SLDASM/meshes/IPIP.STL" />
      </geometry>
    </collision>
  </link>
  <joint name="IP" type="revolute">
    <origin xyz="0 0 0.052" rpy="0 0 0" />
    <parent link="IMCPS" />
    <child link="IPIP" />
    <axis xyz="-1 0 0" />
    <limit lower="0" upper="0" effort="0" velocity="0" />
  </joint>
  <link name="IDIP">
    <inertial>
      <origin xyz="0.000755618362616062 -0.00285690029863031 0.0251719278979156" rpy="0 0 0" />
      <mass value="0.0152963409977157" />
      <inertia ixx="2.60252180819878E-06" ixy="-6.11796223608748E-09" ixz="1.3786754678515E-07" iyy="2.43805284577734E-06" iyz="1.22062110226717E-07" izz="7.35865815495018E-07" />
    </inertial>
    <visual>
      <origin xyz="0 0 0" rpy="0 0 0" />
      <geometry>
        <mesh filename="package://PALM_URDF.SLDASM/meshes/IDIP.STL" />
      </geometry>
      <material name="">
        <color rgba="1 1 1 1" />
      </material>
    </visual>
    <collision>
      <origin xyz="0 0 0" rpy="0 0 0" />
      <geometry>
        <mesh filename="package://PALM_URDF.SLDASM/meshes/IDIP.STL" />
      </geometry>
    </collision>
  </link>
  <joint name="ID" type="revolute">
    <origin xyz="0 0 0.0465" rpy="0 0 0" />
    <parent link="IPIP" />
    <child link="IDIP" />
    <axis xyz="-1 0 0" />
    <limit lower="0" upper="0" effort="0" velocity="0" />
  </joint>
  <link name="IDIP_TACTILE">
    <inertial>
      <origin xyz="0 0 -0.0025" rpy="0 0 0" />
      <mass value="0.00145999999999999" />
      <inertia ixx="4.9548333333333E-08" ixy="1.02757169171569E-23" ixz="-1.3808909495774E-24" iyy="2.92899999999995E-08" iyz="8.67574700602462E-26" izz="7.27549999999992E-08" />
    </inertial>
    <visual>
      <origin xyz="0 0 0" rpy="0 0 0" />
      <geometry>
        <mesh filename="package://PALM_URDF.SLDASM/meshes/IDIP_TACTILE.STL" />
      </geometry>
      <material name="">
        <color rgba="1 1 1 1" />
      </material>
    </visual>
    <collision>
      <origin xyz="0 0 0" rpy="0 0 0" />
      <geometry>
        <mesh filename="package://PALM_URDF.SLDASM/meshes/IDIP_TACTILE.STL" />
      </geometry>
    </collision>
  </link>
  <joint name="ID_T" type="fixed">
    <origin xyz="0 -0.014925 0.024096" rpy="1.5708 0 0" />
    <parent link="IDIP" />
    <child link="IDIP_TACTILE" />
    <axis xyz="0 0 0" />
  </joint>
  <link name="IDIP_CAMERA">
    <inertial>
      <origin xyz="-2.67746700504112E-05 -0.00407450190545353 -0.015109791760626" rpy="0 0 0" />
      <mass value="0.00086572495408493" />
      <inertia ixx="1.23823602198178E-08" ixy="5.89988200103309E-27" ixz="6.36192170559021E-24" iyy="4.23218910238283E-08" iyz="-4.32064612591671E-09" izz="4.62218022775047E-08" />
    </inertial>
    <visual>
      <origin xyz="0 0 0" rpy="0 0 0" />
      <geometry>
        <mesh filename="package://PALM_URDF.SLDASM/meshes/IDIP_CAMERA.STL" />
      </geometry>
      <material name="">
        <color rgba="1 1 1 1" />
      </material>
    </visual>
    <collision>
      <origin xyz="0 0 0" rpy="0 0 0" />
      <geometry>
        <mesh filename="package://PALM_URDF.SLDASM/meshes/IDIP_CAMERA.STL" />
      </geometry>
    </collision>
  </link>
  <joint name="ID_C" type="fixed">
    <origin xyz="0 -0.0094581 0.043053" rpy="1.0472 0 0" />
    <parent link="IDIP" />
    <child link="IDIP_CAMERA" />
    <axis xyz="0 0 0" />
  </joint>
  <link name="IPIP_TACTILE">
    <inertial>
      <origin xyz="2.22044604925031E-16 2.77555756156289E-17 -0.00249999999999999" rpy="0 0 0" />
      <mass value="0.00145999999999999" />
      <inertia ixx="4.9548333333333E-08" ixy="-1.99651962803056E-23" ixz="2.7232137406974E-25" iyy="2.92899999999995E-08" iyz="-4.2219706461114E-24" izz="7.27549999999991E-08" />
    </inertial>
    <visual>
      <origin xyz="0 0 0" rpy="0 0 0" />
      <geometry>
        <mesh filename="package://PALM_URDF.SLDASM/meshes/IPIP_TACTILE.STL" />
      </geometry>
      <material name="">
        <color rgba="1 1 1 1" />
      </material>
    </visual>
    <collision>
      <origin xyz="0 0 0" rpy="0 0 0" />
      <geometry>
        <mesh filename="package://PALM_URDF.SLDASM/meshes/IPIP_TACTILE.STL" />
      </geometry>
    </collision>
  </link>
  <joint name="IP_T" type="fixed">
    <origin xyz="5E-05 -0.015 0.0391" rpy="1.5708 0 0" />
    <parent link="IPIP" />
    <child link="IPIP_TACTILE" />
    <axis xyz="0 0 0" />
  </joint>
  <link name="IMCPS_TACTILE">
    <inertial>
      <origin xyz="2.22044604925031E-16 1.38777878078145E-17 -0.00249999999999997" rpy="0 0 0" />
      <mass value="0.00145999999999999" />
      <inertia ixx="4.95483333333333E-08" ixy="-2.59398305050849E-23" ixz="-3.77338073205544E-24" iyy="2.92899999999995E-08" iyz="1.9160813811325E-24" izz="7.27549999999994E-08" />
    </inertial>
    <visual>
      <origin xyz="0 0 0" rpy="0 0 0" />
      <geometry>
        <mesh filename="package://PALM_URDF.SLDASM/meshes/IMCPS_TACTILE.STL" />
      </geometry>
      <material name="">
        <color rgba="1 1 1 1" />
      </material>
    </visual>
    <collision>
      <origin xyz="0 0 0" rpy="0 0 0" />
      <geometry>
        <mesh filename="package://PALM_URDF.SLDASM/meshes/IMCPS_TACTILE.STL" />
      </geometry>
    </collision>
  </link>
  <joint name="IS_T" type="fixed">
    <origin xyz="0 -0.015 0.0445" rpy="1.5708 0 0" />
    <parent link="IMCPS" />
    <child link="IMCPS_TACTILE" />
    <axis xyz="0 0 0" />
  </joint>
  <link name="MMCPF">
    <inertial>
      <origin xyz="-0.00921166140321783 0.00414018647035749 -0.0151752439916011" rpy="0 0 0" />
      <mass value="0.75693649766014" />
      <inertia ixx="0.00489925180496907" ixy="6.90407197223496E-05" ixz="0.000360307698469442" iyy="0.00701833859290174" iyz="0.000194188490046389" izz="0.0024162274547538" />
    </inertial>
    <visual>
      <origin xyz="0 0 0" rpy="0 0 0" />
      <geometry>
        <mesh filename="package://PALM_URDF.SLDASM/meshes/MMCPF.STL" />
      </geometry>
      <material name="">
        <color rgba="0.674509803921569 0.709803921568627 0.737254901960784 1" />
      </material>
    </visual>
    <collision>
      <origin xyz="0 0 0" rpy="0 0 0" />
      <geometry>
        <mesh filename="package://PALM_URDF.SLDASM/meshes/MMCPF.STL" />
      </geometry>
    </collision>
  </link>
  <joint name="MF" type="revolute">
    <origin xyz="0.026 -0.0075 0.13" rpy="0 0 0" />
    <parent link="BASE" />
    <child link="MMCPF" />
    <axis xyz="-1 0 0" />
    <limit lower="0" upper="0" effort="0" velocity="0" />
  </joint>
  <link name="MMCPS">
    <inertial>
      <origin xyz="0.00036635289481679 0.0013607910689285 0.036307000644315" rpy="0 0 0" />
      <mass value="0.0299795617629258" />
      <inertia ixx="4.61407270089446E-06" ixy="-8.9935797965925E-11" ixz="-2.65128538904687E-09" iyy="4.96910634776408E-06" iyz="-1.08820321097613E-08" izz="1.68786894408093E-06" />
    </inertial>
    <visual>
      <origin xyz="0 0 0" rpy="0 0 0" />
      <geometry>
        <mesh filename="package://PALM_URDF.SLDASM/meshes/MMCPS.STL" />
      </geometry>
      <material name="">
        <color rgba="1 1 1 1" />
      </material>
    </visual>
    <collision>
      <origin xyz="0 0 0" rpy="0 0 0" />
      <geometry>
        <mesh filename="package://PALM_URDF.SLDASM/meshes/MMCPS.STL" />
      </geometry>
    </collision>
  </link>
  <joint name="MS" type="revolute">
    <origin xyz="0 0 0" rpy="0 0 0" />
    <parent link="MMCPF" />
    <child link="MMCPS" />
    <axis xyz="0 1 0" />
    <limit lower="0" upper="0" effort="0" velocity="0" />
  </joint>
  <link name="MPIP">
    <inertial>
      <origin xyz="0.000883607943124698 0.000518551489527383 0.0315502125402506" rpy="0 0 0" />
      <mass value="0.0272064424679892" />
      <inertia ixx="4.85051610725001E-06" ixy="1.06519728675506E-08" ixz="1.36331026032793E-07" iyy="3.78353465508154E-06" iyz="-5.44400980604317E-08" izz="1.94188295958329E-06" />
    </inertial>
    <visual>
      <origin xyz="0 0 0" rpy="0 0 0" />
      <geometry>
        <mesh filename="package://PALM_URDF.SLDASM/meshes/MPIP.STL" />
      </geometry>
      <material name="">
        <color rgba="1 1 1 1" />
      </material>
    </visual>
    <collision>
      <origin xyz="0 0 0" rpy="0 0 0" />
      <geometry>
        <mesh filename="package://PALM_URDF.SLDASM/meshes/MPIP.STL" />
      </geometry>
    </collision>
  </link>
  <joint name="MP" type="revolute">
    <origin xyz="0 0 0.052" rpy="0 0 0" />
    <parent link="MMCPS" />
    <child link="MPIP" />
    <axis xyz="-1 0 0" />
    <limit lower="0" upper="0" effort="0" velocity="0" />
  </joint>
  <link name="MDIP">
    <inertial>
      <origin xyz="0.000755618362616506 -0.00285690029863031 0.0251719278979156" rpy="0 0 0" />
      <mass value="0.0152963409977157" />
      <inertia ixx="2.6025218081988E-06" ixy="-6.11796223608874E-09" ixz="1.37867546785198E-07" iyy="2.43805284577736E-06" iyz="1.22062110226714E-07" izz="7.35865815495016E-07" />
    </inertial>
    <visual>
      <origin xyz="0 0 0" rpy="0 0 0" />
      <geometry>
        <mesh filename="package://PALM_URDF.SLDASM/meshes/MDIP.STL" />
      </geometry>
      <material name="">
        <color rgba="1 1 1 1" />
      </material>
    </visual>
    <collision>
      <origin xyz="0 0 0" rpy="0 0 0" />
      <geometry>
        <mesh filename="package://PALM_URDF.SLDASM/meshes/MDIP.STL" />
      </geometry>
    </collision>
  </link>
  <joint name="MD" type="revolute">
    <origin xyz="0 0 0.0465" rpy="0 0 0" />
    <parent link="MPIP" />
    <child link="MDIP" />
    <axis xyz="-1 0 0" />
    <limit lower="0" upper="0" effort="0" velocity="0" />
  </joint>
  <link name="MDIP_TACTILE">
    <inertial>
      <origin xyz="0 -2.77555756156289E-17 -0.0025" rpy="0 0 0" />
      <mass value="0.00145999999999999" />
      <inertia ixx="4.95483333333329E-08" ixy="-1.10778006470767E-25" ixz="-4.5416300957282E-24" iyy="2.92899999999995E-08" iyz="-5.3677819714707E-24" izz="7.27549999999991E-08" />
    </inertial>
    <visual>
      <origin xyz="0 0 0" rpy="0 0 0" />
      <geometry>
        <mesh filename="package://PALM_URDF.SLDASM/meshes/MDIP_TACTILE.STL" />
      </geometry>
      <material name="">
        <color rgba="1 1 1 1" />
      </material>
    </visual>
    <collision>
      <origin xyz="0 0 0" rpy="0 0 0" />
      <geometry>
        <mesh filename="package://PALM_URDF.SLDASM/meshes/MDIP_TACTILE.STL" />
      </geometry>
    </collision>
  </link>
  <joint name="MD_T" type="fixed">
    <origin xyz="0 -0.014925 0.024096" rpy="1.5708 0 0" />
    <parent link="MDIP" />
    <child link="MDIP_TACTILE" />
    <axis xyz="0 0 0" />
  </joint>
  <link name="MDIP_CAMERA">
    <inertial>
      <origin xyz="-2.67746700501892E-05 -0.00407450190545353 -0.015109791760626" rpy="0 0 0" />
      <mass value="0.000865724954084932" />
      <inertia ixx="1.2382360219818E-08" ixy="2.73689092122158E-25" ixz="2.13302188485751E-24" iyy="4.23218910238286E-08" iyz="-4.32064612591669E-09" izz="4.62218022775049E-08" />
    </inertial>
    <visual>
      <origin xyz="0 0 0" rpy="0 0 0" />
      <geometry>
        <mesh filename="package://PALM_URDF.SLDASM/meshes/MDIP_CAMERA.STL" />
      </geometry>
      <material name="">
        <color rgba="1 1 1 1" />
      </material>
    </visual>
    <collision>
      <origin xyz="0 0 0" rpy="0 0 0" />
      <geometry>
        <mesh filename="package://PALM_URDF.SLDASM/meshes/MDIP_CAMERA.STL" />
      </geometry>
    </collision>
  </link>
  <joint name="MD_C" type="fixed">
    <origin xyz="0 -0.0094581 0.043053" rpy="1.0472 0 0" />
    <parent link="MDIP" />
    <child link="MDIP_CAMERA" />
    <axis xyz="0 0 0" />
  </joint>
  <link name="MPIP_TACTILE">
    <inertial>
      <origin xyz="0 0 -0.0025" rpy="0 0 0" />
      <mass value="0.00145999999999999" />
      <inertia ixx="4.95483333333332E-08" ixy="-4.9510435962476E-24" ixz="-1.41268932206762E-25" iyy="2.92899999999995E-08" iyz="-4.52736710151494E-24" izz="7.27549999999994E-08" />
    </inertial>
    <visual>
      <origin xyz="0 0 0" rpy="0 0 0" />
      <geometry>
        <mesh filename="package://PALM_URDF.SLDASM/meshes/MPIP_TACTILE.STL" />
      </geometry>
      <material name="">
        <color rgba="1 1 1 1" />
      </material>
    </visual>
    <collision>
      <origin xyz="0 0 0" rpy="0 0 0" />
      <geometry>
        <mesh filename="package://PALM_URDF.SLDASM/meshes/MPIP_TACTILE.STL" />
      </geometry>
    </collision>
  </link>
  <joint name="MP_T" type="fixed">
    <origin xyz="5E-05 -0.015 0.0391" rpy="1.5708 0 0" />
    <parent link="MPIP" />
    <child link="MPIP_TACTILE" />
    <axis xyz="0 0 0" />
  </joint>
  <link name="MMCPS_TACTILE">
    <inertial>
      <origin xyz="2.22044604925031E-16 2.77555756156289E-17 -0.00249999999999999" rpy="0 0 0" />
      <mass value="0.00145999999999999" />
      <inertia ixx="4.9548333333333E-08" ixy="-9.73238214860379E-24" ixz="2.95914222032437E-25" iyy="2.92899999999995E-08" iyz="-4.72572091989409E-24" izz="7.27549999999992E-08" />
    </inertial>
    <visual>
      <origin xyz="0 0 0" rpy="0 0 0" />
      <geometry>
        <mesh filename="package://PALM_URDF.SLDASM/meshes/MMCPS_TACTILE.STL" />
      </geometry>
      <material name="">
        <color rgba="1 1 1 1" />
      </material>
    </visual>
    <collision>
      <origin xyz="0 0 0" rpy="0 0 0" />
      <geometry>
        <mesh filename="package://PALM_URDF.SLDASM/meshes/MMCPS_TACTILE.STL" />
      </geometry>
    </collision>
  </link>
  <joint name="MS_T" type="fixed">
    <origin xyz="0 -0.015 0.0445" rpy="1.5708 0 0" />
    <parent link="MMCPS" />
    <child link="MMCPS_TACTILE" />
    <axis xyz="0 0 0" />
  </joint>
  <link name="RMCPF">
    <inertial>
      <origin xyz="0.0267883385967822 0.00414018647035747 -0.0151752439916011" rpy="0 0 0" />
      <mass value="0.75693649766014" />
      <inertia ixx="0.00489925180496908" ixy="6.90407197223565E-05" ixz="0.000360307698469349" iyy="0.00701833859290176" iyz="0.00019418849004639" izz="0.00241622745475382" />
    </inertial>
    <visual>
      <origin xyz="0 0 0" rpy="0 0 0" />
      <geometry>
        <mesh filename="package://PALM_URDF.SLDASM/meshes/RMCPF.STL" />
      </geometry>
      <material name="">
        <color rgba="0.674509803921569 0.709803921568627 0.737254901960784 1" />
      </material>
    </visual>
    <collision>
      <origin xyz="0 0 0" rpy="0 0 0" />
      <geometry>
        <mesh filename="package://PALM_URDF.SLDASM/meshes/RMCPF.STL" />
      </geometry>
    </collision>
  </link>
  <joint name="RF" type="revolute">
    <origin xyz="-0.01 -0.0075 0.13" rpy="0 0 0" />
    <parent link="BASE" />
    <child link="RMCPF" />
    <axis xyz="1 0 0" />
    <limit lower="0" upper="0" effort="0" velocity="0" />
  </joint>
  <link name="RMCPS">
    <inertial>
      <origin xyz="0.000366352894816679 0.00136079106892853 0.036307000644315" rpy="0 0 0" />
      <mass value="0.0299795617629258" />
      <inertia ixx="4.61407270089445E-06" ixy="-8.99357979702165E-11" ixz="-2.651285389045E-09" iyy="4.96910634776407E-06" iyz="-1.08820321097617E-08" izz="1.68786894408093E-06" />
    </inertial>
    <visual>
      <origin xyz="0 0 0" rpy="0 0 0" />
      <geometry>
        <mesh filename="package://PALM_URDF.SLDASM/meshes/RMCPS.STL" />
      </geometry>
      <material name="">
        <color rgba="1 1 1 1" />
      </material>
    </visual>
    <collision>
      <origin xyz="0 0 0" rpy="0 0 0" />
      <geometry>
        <mesh filename="package://PALM_URDF.SLDASM/meshes/RMCPS.STL" />
      </geometry>
    </collision>
  </link>
  <joint name="RS" type="revolute">
    <origin xyz="0 0 0" rpy="0 0 0" />
    <parent link="RMCPF" />
    <child link="RMCPS" />
    <axis xyz="0 1 0" />
    <limit lower="0" upper="0" effort="0" velocity="0" />
  </joint>
  <link name="RPIP">
    <inertial>
      <origin xyz="0.000883607942915199 0.000518551489729999 0.031550212540222" rpy="0 0 0" />
      <mass value="0.0272064424685651" />
      <inertia ixx="4.85051610732065E-06" ixy="1.06519728750291E-08" ixz="1.36331026037561E-07" iyy="3.78353465510333E-06" iyz="-5.44400980930829E-08" izz="1.94188295962763E-06" />
    </inertial>
    <visual>
      <origin xyz="0 0 0" rpy="0 0 0" />
      <geometry>
        <mesh filename="package://PALM_URDF.SLDASM/meshes/RPIP.STL" />
      </geometry>
      <material name="">
        <color rgba="1 1 1 1" />
      </material>
    </visual>
    <collision>
      <origin xyz="0 0 0" rpy="0 0 0" />
      <geometry>
        <mesh filename="package://PALM_URDF.SLDASM/meshes/RPIP.STL" />
      </geometry>
    </collision>
  </link>
  <joint name="RP" type="revolute">
    <origin xyz="0 0 0.052" rpy="0 0 0" />
    <parent link="RMCPS" />
    <child link="RPIP" />
    <axis xyz="-1 0 0" />
    <limit lower="0" upper="0" effort="0" velocity="0" />
  </joint>
  <link name="RDIP">
    <inertial>
      <origin xyz="0.00075561836261584 -0.00285690029863032 0.0251719278979156" rpy="0 0 0" />
      <mass value="0.0152963409977157" />
      <inertia ixx="2.60252180819879E-06" ixy="-6.11796223608598E-09" ixz="1.37867546785174E-07" iyy="2.43805284577734E-06" iyz="1.22062110226726E-07" izz="7.35865815495008E-07" />
    </inertial>
    <visual>
      <origin xyz="0 0 0" rpy="0 0 0" />
      <geometry>
        <mesh filename="package://PALM_URDF.SLDASM/meshes/RDIP.STL" />
      </geometry>
      <material name="">
        <color rgba="1 1 1 1" />
      </material>
    </visual>
    <collision>
      <origin xyz="0 0 0" rpy="0 0 0" />
      <geometry>
        <mesh filename="package://PALM_URDF.SLDASM/meshes/RDIP.STL" />
      </geometry>
    </collision>
  </link>
  <joint name="RD" type="revolute">
    <origin xyz="0 0 0.0465" rpy="0 0 0" />
    <parent link="RPIP" />
    <child link="RDIP" />
    <axis xyz="-1 0 0" />
    <limit lower="0" upper="0" effort="0" velocity="0" />
  </joint>
  <link name="RDIP_TACTILE">
    <inertial>
      <origin xyz="-5.00000000002165E-05 0.0314957914612014 -0.00257459539177737" rpy="0 0 0" />
      <mass value="0.00146" />
      <inertia ixx="4.95483333333335E-08" ixy="4.52127439378832E-23" ixz="-1.61774727528033E-23" iyy="2.92900000000001E-08" iyz="-4.12403362478912E-24" izz="7.27550000000003E-08" />
    </inertial>
    <visual>
      <origin xyz="0 0 0" rpy="0 0 0" />
      <geometry>
        <mesh filename="package://PALM_URDF.SLDASM/meshes/RDIP_TACTILE.STL" />
      </geometry>
      <material name="">
        <color rgba="1 1 1 1" />
      </material>
    </visual>
    <collision>
      <origin xyz="0 0 0" rpy="0 0 0" />
      <geometry>
        <mesh filename="package://PALM_URDF.SLDASM/meshes/RDIP_TACTILE.STL" />
      </geometry>
    </collision>
  </link>
  <joint name="RD_T" type="fixed">
    <origin xyz="5E-05 -0.015 -0.0074" rpy="1.5708 0 0" />
    <parent link="RDIP" />
    <child link="RDIP_TACTILE" />
    <axis xyz="0 0 0" />
  </joint>
  <link name="RDIP_CAMERA">
    <inertial>
      <origin xyz="-2.67746700504112E-05 -0.00407450190545347 -0.0151097917606259" rpy="0 0 0" />
      <mass value="0.000865724954084925" />
      <inertia ixx="1.23823602198179E-08" ixy="2.7325137400898E-24" ixz="-3.10017271981854E-24" iyy="4.23218910238279E-08" iyz="-4.32064612591663E-09" izz="4.62218022775043E-08" />
    </inertial>
    <visual>
      <origin xyz="0 0 0" rpy="0 0 0" />
      <geometry>
        <mesh filename="package://PALM_URDF.SLDASM/meshes/RDIP_CAMERA.STL" />
      </geometry>
      <material name="">
        <color rgba="1 1 1 1" />
      </material>
    </visual>
    <collision>
      <origin xyz="0 0 0" rpy="0 0 0" />
      <geometry>
        <mesh filename="package://PALM_URDF.SLDASM/meshes/RDIP_CAMERA.STL" />
      </geometry>
    </collision>
  </link>
  <joint name="RD_C" type="fixed">
    <origin xyz="0 -0.0094581 0.043053" rpy="1.0472 0 0" />
    <parent link="RDIP" />
    <child link="RDIP_CAMERA" />
    <axis xyz="0 0 0" />
  </joint>
  <link name="RPIP_TACTILE">
    <inertial>
      <origin xyz="0 0 -0.0025" rpy="0 0 0" />
      <mass value="0.00146" />
      <inertia ixx="4.95483333333332E-08" ixy="-1.42537950031485E-22" ixz="-2.06737579452231E-25" iyy="2.92899999999999E-08" iyz="-4.76711350057175E-24" izz="7.27549999999998E-08" />
    </inertial>
    <visual>
      <origin xyz="0 0 0" rpy="0 0 0" />
      <geometry>
        <mesh filename="package://PALM_URDF.SLDASM/meshes/RPIP_TACTILE.STL" />
      </geometry>
      <material name="">
        <color rgba="1 1 1 1" />
      </material>
    </visual>
    <collision>
      <origin xyz="0 0 0" rpy="0 0 0" />
      <geometry>
        <mesh filename="package://PALM_URDF.SLDASM/meshes/RPIP_TACTILE.STL" />
      </geometry>
    </collision>
  </link>
  <joint name="RP_T" type="fixed">
    <origin xyz="5E-05 -0.015 0.0391" rpy="1.5708 0 0" />
    <parent link="RPIP" />
    <child link="RPIP_TACTILE" />
    <axis xyz="0 0 0" />
  </joint>
  <link name="RMCPS_TACTILE">
    <inertial>
      <origin xyz="0 0 -0.0025" rpy="0 0 0" />
      <mass value="0.00146" />
      <inertia ixx="4.95483333333337E-08" ixy="-2.34056512385316E-23" ixz="-7.96324007534223E-25" iyy="2.92900000000002E-08" iyz="-2.37470452236124E-24" izz="7.27550000000005E-08" />
    </inertial>
    <visual>
      <origin xyz="0 0 0" rpy="0 0 0" />
      <geometry>
        <mesh filename="package://PALM_URDF.SLDASM/meshes/RMCPS_TACTILE.STL" />
      </geometry>
      <material name="">
        <color rgba="1 1 1 1" />
      </material>
    </visual>
    <collision>
      <origin xyz="0 0 0" rpy="0 0 0" />
      <geometry>
        <mesh filename="package://PALM_URDF.SLDASM/meshes/RMCPS_TACTILE.STL" />
      </geometry>
    </collision>
  </link>
  <joint name="RS_T" type="fixed">
    <origin xyz="0 -0.015 0.0445" rpy="1.5708 0 0" />
    <parent link="RMCPS" />
    <child link="RMCPS_TACTILE" />
    <axis xyz="0 0 0" />
  </joint>
  <link name="LMCPF">
    <inertial>
      <origin xyz="0.0667883357357592 0.00414018503984552 0.00482475028635327" rpy="0 0 0" />
      <mass value="0.75693649766014" />
      <inertia ixx="0.00489925180496908" ixy="6.90407197223527E-05" ixz="0.000360307698469407" iyy="0.00701833859290176" iyz="0.00019418849004639" izz="0.00241622745475382" />
    </inertial>
    <visual>
      <origin xyz="0 0 0" rpy="0 0 0" />
      <geometry>
        <mesh filename="package://PALM_URDF.SLDASM/meshes/LMCPF.STL" />
      </geometry>
      <material name="">
        <color rgba="0.674509803921569 0.709803921568627 0.737254901960784 1" />
      </material>
    </visual>
    <collision>
      <origin xyz="0 0 0" rpy="0 0 0" />
      <geometry>
        <mesh filename="package://PALM_URDF.SLDASM/meshes/LMCPF.STL" />
      </geometry>
    </collision>
  </link>
  <joint name="LF" type="revolute">
    <origin xyz="-0.05 -0.0075 0.11" rpy="0 0 0" />
    <parent link="BASE" />
    <child link="LMCPF" />
    <axis xyz="-1 0 0" />
    <limit lower="0" upper="0" effort="0" velocity="0" />
  </joint>
  <link name="LMCPS">
    <inertial>
      <origin xyz="0.00036635289481679 0.00136079106892854 0.036307000644315" rpy="0 0 0" />
      <mass value="0.0299795617629258" />
      <inertia ixx="4.61407270089445E-06" ixy="-8.9935797969808E-11" ixz="-2.6512853890423E-09" iyy="4.96910634776406E-06" iyz="-1.08820321097631E-08" izz="1.68786894408093E-06" />
    </inertial>
    <visual>
      <origin xyz="0 0 0" rpy="0 0 0" />
      <geometry>
        <mesh filename="package://PALM_URDF.SLDASM/meshes/LMCPS.STL" />
      </geometry>
      <material name="">
        <color rgba="1 1 1 1" />
      </material>
    </visual>
    <collision>
      <origin xyz="0 0 0" rpy="0 0 0" />
      <geometry>
        <mesh filename="package://PALM_URDF.SLDASM/meshes/LMCPS.STL" />
      </geometry>
    </collision>
  </link>
  <joint name="LS" type="revolute">
    <origin xyz="0 0 0" rpy="0 0 0" />
    <parent link="LMCPF" />
    <child link="LMCPS" />
    <axis xyz="0 1 0" />
    <limit lower="0" upper="0" effort="0" velocity="0" />
  </joint>
  <link name="LPIP">
    <inertial>
      <origin xyz="0.000883607942915088 0.000518551489730013 0.0315502125402218" rpy="0 0 0" />
      <mass value="0.0272064424685652" />
      <inertia ixx="4.85051610732064E-06" ixy="1.06519728750235E-08" ixz="1.36331026037563E-07" iyy="3.78353465510332E-06" iyz="-5.44400980930848E-08" izz="1.94188295962763E-06" />
    </inertial>
    <visual>
      <origin xyz="0 0 0" rpy="0 0 0" />
      <geometry>
        <mesh filename="package://PALM_URDF.SLDASM/meshes/LPIP.STL" />
      </geometry>
      <material name="">
        <color rgba="1 1 1 1" />
      </material>
    </visual>
    <collision>
      <origin xyz="0 0 0" rpy="0 0 0" />
      <geometry>
        <mesh filename="package://PALM_URDF.SLDASM/meshes/LPIP.STL" />
      </geometry>
    </collision>
  </link>
  <joint name="LP" type="revolute">
    <origin xyz="0 0 0.052" rpy="0 0 0" />
    <parent link="LMCPS" />
    <child link="LPIP" />
    <axis xyz="-1 0 0" />
    <limit lower="0" upper="0" effort="0" velocity="0" />
  </joint>
  <link name="LDIP">
    <inertial>
      <origin xyz="0.000755618362616062 -0.00285690029863038 0.0251719278979156" rpy="0 0 0" />
      <mass value="0.0152963409977157" />
      <inertia ixx="2.60252180819878E-06" ixy="-6.11796223608723E-09" ixz="1.37867546785183E-07" iyy="2.43805284577734E-06" iyz="1.22062110226717E-07" izz="7.35865815495013E-07" />
    </inertial>
    <visual>
      <origin xyz="0 0 0" rpy="0 0 0" />
      <geometry>
        <mesh filename="package://PALM_URDF.SLDASM/meshes/LDIP.STL" />
      </geometry>
      <material name="">
        <color rgba="1 1 1 1" />
      </material>
    </visual>
    <collision>
      <origin xyz="0 0 0" rpy="0 0 0" />
      <geometry>
        <mesh filename="package://PALM_URDF.SLDASM/meshes/LDIP.STL" />
      </geometry>
    </collision>
  </link>
  <joint name="LD" type="fixed">
    <origin xyz="0 0 0.0465" rpy="0 0 0" />
    <parent link="LPIP" />
    <child link="LDIP" />
    <axis xyz="0 0 0" />
  </joint>
  <link name="LDIP_TACTILE">
    <inertial>
      <origin xyz="0 -2.77555756156289E-17 -0.0025" rpy="0 0 0" />
      <mass value="0.00146" />
      <inertia ixx="4.95483333333334E-08" ixy="1.87852506929172E-23" ixz="-1.6479916330088E-24" iyy="2.92900000000001E-08" iyz="1.34423765121166E-24" izz="7.27550000000001E-08" />
    </inertial>
    <visual>
      <origin xyz="0 0 0" rpy="0 0 0" />
      <geometry>
        <mesh filename="package://PALM_URDF.SLDASM/meshes/LDIP_TACTILE.STL" />
      </geometry>
      <material name="">
        <color rgba="1 1 1 1" />
      </material>
    </visual>
    <collision>
      <origin xyz="0 0 0" rpy="0 0 0" />
      <geometry>
        <mesh filename="package://PALM_URDF.SLDASM/meshes/LDIP_TACTILE.STL" />
      </geometry>
    </collision>
  </link>
  <joint name="LD_T" type="fixed">
    <origin xyz="0 -0.014925 0.024096" rpy="1.5708 0 0" />
    <parent link="LDIP" />
    <child link="LDIP_TACTILE" />
    <axis xyz="0 0 0" />
  </joint>
  <link name="LDIP_CAMERA">
    <inertial>
      <origin xyz="-2.67746700503002E-05 -0.0040745019054536 -0.015109791760626" rpy="0 0 0" />
      <mass value="0.000865724954084931" />
      <inertia ixx="1.23823602198179E-08" ixy="-1.93869857927924E-24" ixz="1.15135360865956E-23" iyy="4.23218910238285E-08" iyz="-4.32064612591673E-09" izz="4.62218022775049E-08" />
    </inertial>
    <visual>
      <origin xyz="0 0 0" rpy="0 0 0" />
      <geometry>
        <mesh filename="package://PALM_URDF.SLDASM/meshes/LDIP_CAMERA.STL" />
      </geometry>
      <material name="">
        <color rgba="1 1 1 1" />
      </material>
    </visual>
    <collision>
      <origin xyz="0 0 0" rpy="0 0 0" />
      <geometry>
        <mesh filename="package://PALM_URDF.SLDASM/meshes/LDIP_CAMERA.STL" />
      </geometry>
    </collision>
  </link>
  <joint name="LD_C" type="fixed">
    <origin xyz="0 -0.0094581 0.043053" rpy="1.0472 0 0" />
    <parent link="LDIP" />
    <child link="LDIP_CAMERA" />
    <axis xyz="0 0 0" />
  </joint>
  <link name="LPIP_TACTILE">
    <inertial>
      <origin xyz="1.11022302462516E-16 2.77555756156289E-17 -0.00249999999999999" rpy="0 0 0" />
      <mass value="0.00146" />
      <inertia ixx="4.95483333333334E-08" ixy="-1.50475121634476E-22" ixz="-6.23483329349609E-25" iyy="2.929E-08" iyz="-1.58674109584387E-24" izz="7.2755E-08" />
    </inertial>
    <visual>
      <origin xyz="0 0 0" rpy="0 0 0" />
      <geometry>
        <mesh filename="package://PALM_URDF.SLDASM/meshes/LPIP_TACTILE.STL" />
      </geometry>
      <material name="">
        <color rgba="1 1 1 1" />
      </material>
    </visual>
    <collision>
      <origin xyz="0 0 0" rpy="0 0 0" />
      <geometry>
        <mesh filename="package://PALM_URDF.SLDASM/meshes/LPIP_TACTILE.STL" />
      </geometry>
    </collision>
  </link>
  <joint name="LP_T" type="fixed">
    <origin xyz="5E-05 -0.015 0.0391" rpy="1.5708 0 0" />
    <parent link="LPIP" />
    <child link="LPIP_TACTILE" />
    <axis xyz="0 0 0" />
  </joint>
  <link name="LMCPS_TACTILE">
    <inertial>
      <origin xyz="0 1.38777878078145E-17 -0.00250000000000002" rpy="0 0 0" />
      <mass value="0.00146" />
      <inertia ixx="4.95483333333335E-08" ixy="-7.15003268993821E-24" ixz="-4.03565792543714E-24" iyy="2.929E-08" iyz="-1.21105521224976E-23" izz="7.27550000000002E-08" />
    </inertial>
    <visual>
      <origin xyz="0 0 0" rpy="0 0 0" />
      <geometry>
        <mesh filename="package://PALM_URDF.SLDASM/meshes/LMCPS_TACTILE.STL" />
      </geometry>
      <material name="">
        <color rgba="1 1 1 1" />
      </material>
    </visual>
    <collision>
      <origin xyz="0 0 0" rpy="0 0 0" />
      <geometry>
        <mesh filename="package://PALM_URDF.SLDASM/meshes/LMCPS_TACTILE.STL" />
      </geometry>
    </collision>
  </link>
  <joint name="LS_T" type="fixed">
    <origin xyz="0 -0.015 0.0445" rpy="1.5708 0 0" />
    <parent link="LMCPS" />
    <child link="LMCPS_TACTILE" />
    <axis xyz="0 0 0" />
  </joint>
</robot>
