David0412-sun/Rapidhand/RAPID-Hand-main/RapidHandHardware/mechanical_structure/robot side/Robot side.pdf

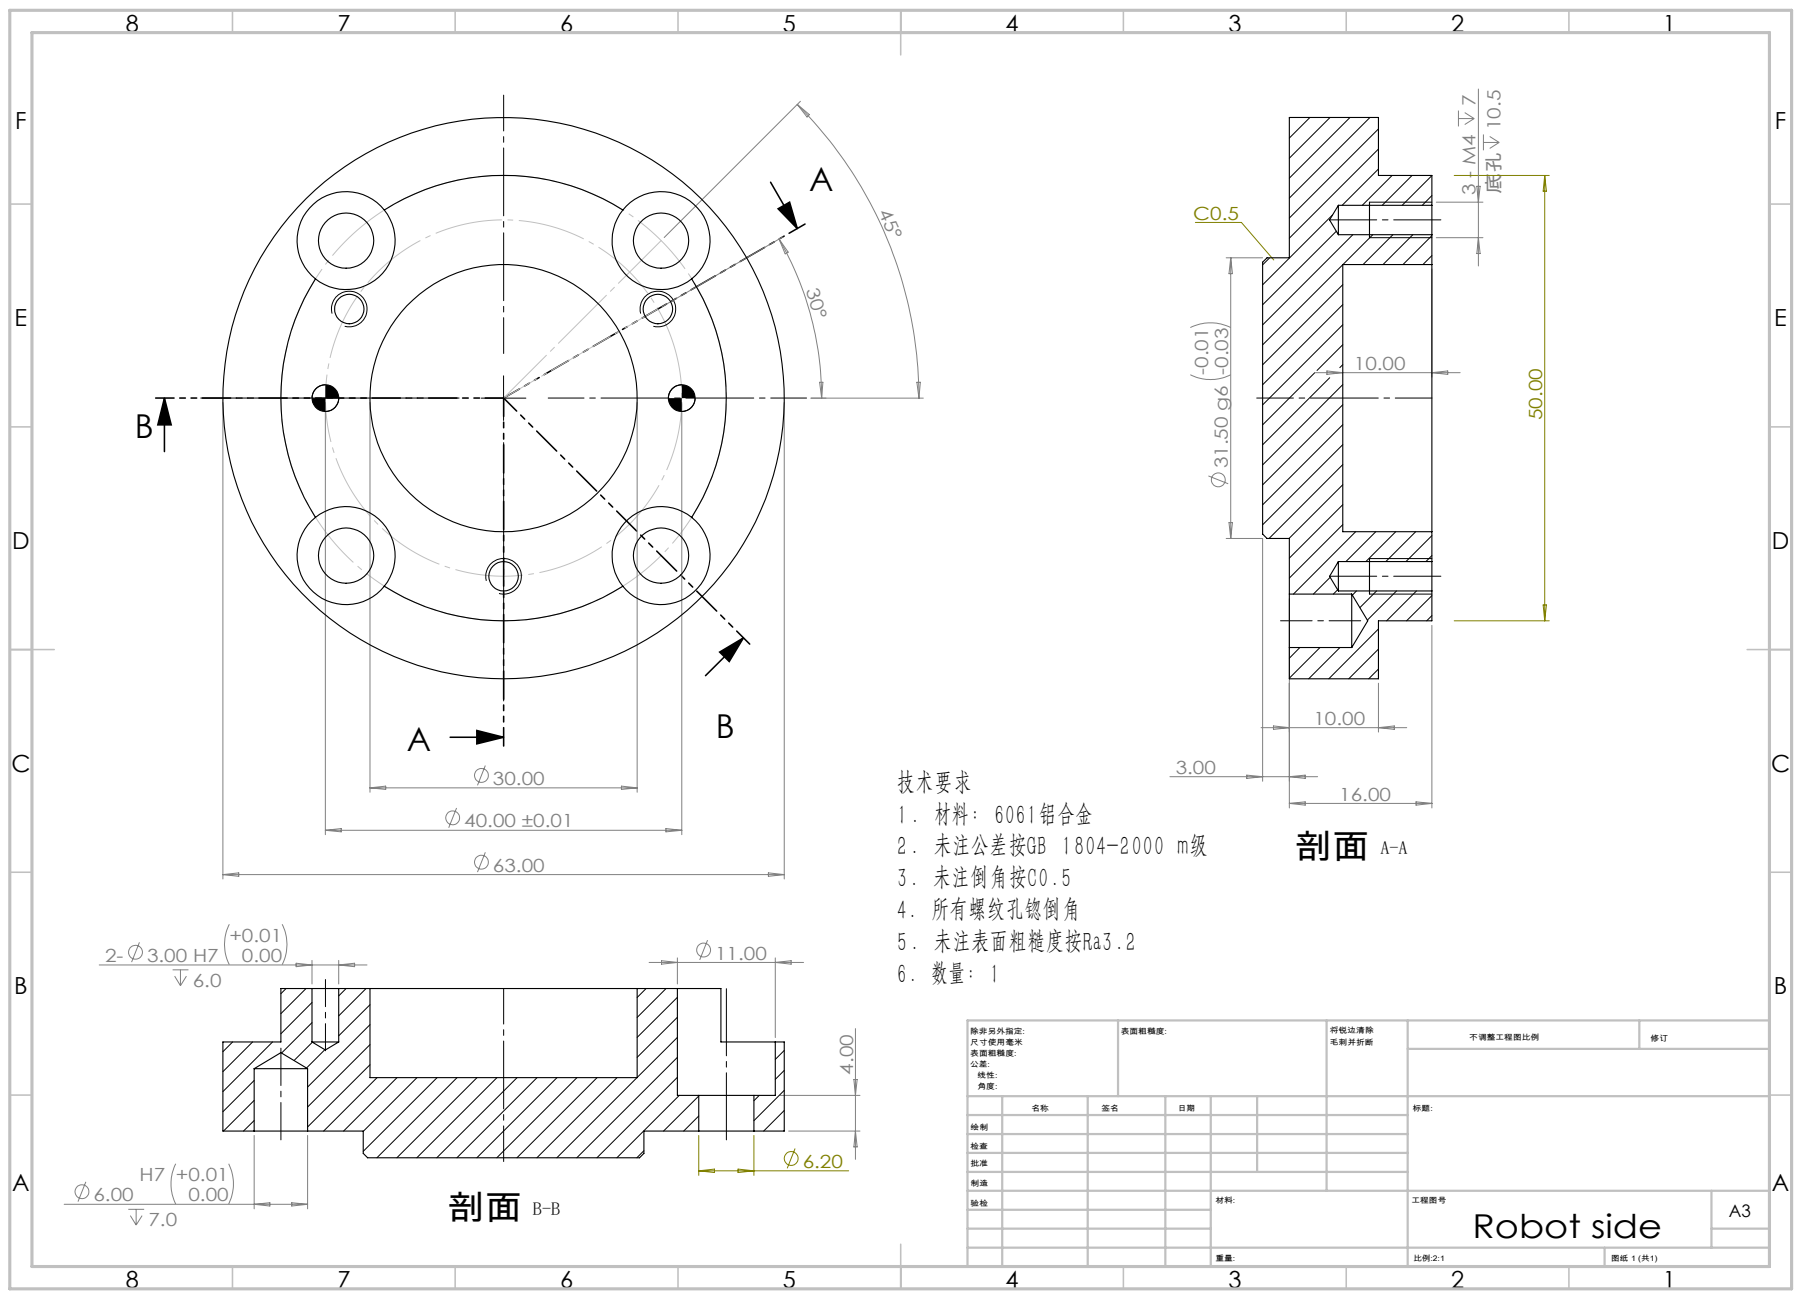
[picture p145: page 1]
1. 材料：6061铝合金 2. 未注公差按GB 1804-2000 m级 3. 未注倒角按C0.5 4. 所有螺纹孔锪倒角 5. 未注表面粗糙度按Ra3.2 6. 数量：1

绘制
检查
批准
制造
验检 | | | | 材料: | 工程图号 Robot side | A3
