David0412-sun/Rapidhand/(commit log)

2026-05-18 modified: "RAPID-Hand-main/RapidHandHardware/mechanical_structure/3D Printed Parts/finger/\346\211\213\346\214\207\345\270\246\346\221\204\345\203\217\345\244\264\345\267\246_\345\200\276\346\226\234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
    [手指带摄像头左_倾斜扩大.SLDPRT]
2026-05-19 modified: "RAPID-Hand-main/RapidHandHardware/mechanical_structure/3D Printed Parts/finger/\346\211\213\346\214\207\350\243\205\351\205\215.SLDASM"
    [手指装配.SLDASM]
